KVR-CIBER/sc02-solar-hypercar/f1/docs/boodschappenlijst.md

# SC-02 · Boodschappenlijst

Afvinkbaar op je gsm: http://192.168.68.88:5880/lijst/

Prijzen zijn richtprijzen (oktober 2026). Bewaar alle kassabonnen: de organisatie vergoedt max. €50.

## Aandrijving (≈ €28)

| ✓ | Onderdeel | Aantal | Prijs | Waarvoor | Waar / zoekterm |
|---|---|---|---|---|---|
| ☐ | Tamiya Hyper-Dash 3 motor | 2 | €17.00 | Mini 4WD 130-motor, art. 15477 | Hobbywinkel / bol.com / Amazon.de · zoek “Tamiya 15477” |
| ☐ | Messing pinion 8T, module 0,5, boring 2 mm | 2 | €2.50 | past op de 2 mm-as van de motor (pak van 10) | AliExpress · “0.5M 8T brass pinion 2mm” |
| ☐ | Kogellager 683ZZ (3×7×3 mm) | 6 | €3.60 | 2 achteras + 4 in de voorwielen (pak van 10) | AliExpress / bol.com · “683ZZ bearing” |
| ☐ | Carbonstaaf Ø3 mm × 500 mm | 1 | €2.50 | achteras 186 mm | AliExpress / modelbouw · “carbon rod 3mm” |
| ☐ | Zilverstaal Ø3 mm × 100 mm | 1 | €2.00 | 2 steekasjes voor 16 mm | Conrad / modelbouw · “zilverstaal 3 mm” |

## Sturen & elektronica (≈ €60)

| ✓ | Onderdeel | Aantal | Prijs | Waarvoor | Waar / zoekterm |
|---|---|---|---|---|---|
| ☐ | Servo MG90S (metalen tandwielen) | 1 | €4.00 | stuurservo, omgekeerd in de neus | AliExpress / bol.com · “MG90S” |
| ☐ | Pololu DRV8874 motordriver | 2 | €18.00 | 1 per motor, vooruit/achteruit/remmen | Kiwi Electronics / Antratek / Pololu · “Pololu DRV8874 carrier” |
| ☐ | Pololu S13V30F5 (5 V 3 A buck-boost) | 1 | €17.00 | 5 V voor Pi 4 + servo, werkt op 4,8 V én 12 V | Kiwi Electronics / Antratek · “S13V30F5” |
| ☐ | INA226-module 20 A (2 mΩ shunt) | 1 | €3.00 | meet batterijspanning en stroom → verbruik op je gsm | AliExpress · “INA226 20A” |
| ☐ | Hallsensor DRV5023 (TO-92) | 1 | €1.50 | snelheid via het tandwiel | Mouser / Farnell · “DRV5023 TO-92” |
| ☐ | Neodymium magneetjes 2×1 mm + 6×3 mm | 1 | €4.00 | 2 in het tandwiel, 8 voor de body | AliExpress · “magnet 2x1mm / 6x3mm” |
| ☐ | Schottky 1N5819 + zekeringhouder mini-blade + 10 A zekering + mini-schakelaar | 1 | €4.00 | paneel-diode (verplicht), zekering, aan/uit onder de vloer | Conrad / AliExpress |
| ☐ | Siliconendraad 20 AWG + 26 AWG, XT30-stekkers | 1 | €6.00 | voeding + signaal | AliExpress / bol.com · “silicone wire 20awg”, “XT30” |
| ☐ | Dupont-kabeltjes F-F | 1 | €2.00 | ESP ↔ Pi UART, sensoren | AliExpress / bol.com |

## Batterij (≈ €48)

| ✓ | Onderdeel | Aantal | Prijs | Waarvoor | Waar / zoekterm |
|---|---|---|---|---|---|
| ☐ | 3S LiPo 1300 mAh (XT30, max. 75×35×25 mm) | 1 | €18.00 | om te rijden met Pi + controller (niet voor de wedstrijd) | Hobbywinkel / AliExpress · “3S 1300mAh XT30” |
| ☐ | LiPo-balanslader | 1 | €25.00 | alleen als je er nog geen hebt | bv. ToolkitRC / ISDT · “LiPo balance charger” |
| ☐ | LiPo-veiligheidszak | 1 | €5.00 | laden en bewaren | “LiPo safe bag” |

## Carrosserie, vloer & banden (≈ €44)

| ✓ | Onderdeel | Aantal | Prijs | Waarvoor | Waar / zoekterm |
|---|---|---|---|---|---|
| ☐ | Zwart plexi/acrylaat 2 mm, lasersnijden (DXF) | 1 | €15.00 | bestand: floor_2mm_acrylic.dxf | FabLab / laserservice · “acrylaat lasersnijden” |
| ☐ | Filament ASA (rood + zwart), ± 300 g | 1 | €8.00 | body, vleugels, chassisdelen | Bambu Lab store · “Bambu ASA” |
| ☐ | Filament PETG smoke/zwart, ± 40 g | 1 | €2.00 | koepel | Bambu Lab store · “PETG translucent gray” |
| ☐ | Filament PLA grafiet, ± 160 g | 1 | €3.00 | velgen + bandenmal |  |
| ☐ | Gietrubber: PU Shore 50A of siliconen Shore 40A (± 50 ml) | 1 | €15.00 | 4 banden + reserve | bol.com / Formx · “PU gietrubber shore 50” |
| ☐ | Spuitjes 10 ml Luer (zonder naald) | 3 | €1.50 | rubber inspuiten | apotheek / bol.com |

## Schroeven & klein materiaal (≈ €14)

| ✓ | Onderdeel | Aantal | Prijs | Waarvoor | Waar / zoekterm |
|---|---|---|---|---|---|
| ☐ | Assortiment M2×8 zelftappend + M3×6 verzonken + M3×12 (kingpins) | 1 | €8.00 | alles van onderen door de plexivloer | bol.com / AliExpress · “M2 M3 screw assortment” |
| ☐ | Klittenband + kabelbinders 2,5 mm | 1 | €3.00 | batterij en kabels |  |
| ☐ | Krimpkous assortiment | 1 | €3.00 |  |  |

**Totaal ≈ €194.** Zonder LiPo-lader en veiligheidszak (als je die al hebt) ≈ €164.

**Al in huis:** Raspberry Pi 4, ESP32-S3 DevKitC-1, Recon Cloud-controller, Bambu P1S, en de kit van de organisatie (paneel, 4× AA, houders, Loctite 3090).
