KVR-CIBER/sc02-solar-hypercar/cad/out/render_inside.png

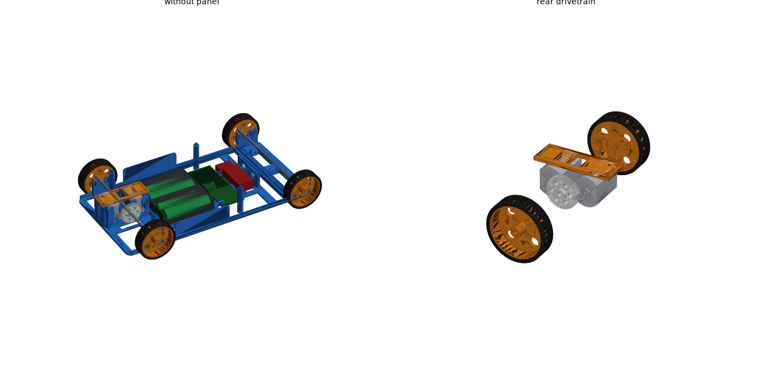
cad/out/render_inside.png
