KVR-CIBER/sc02-solar-hypercar/cad/out/render_mold.png

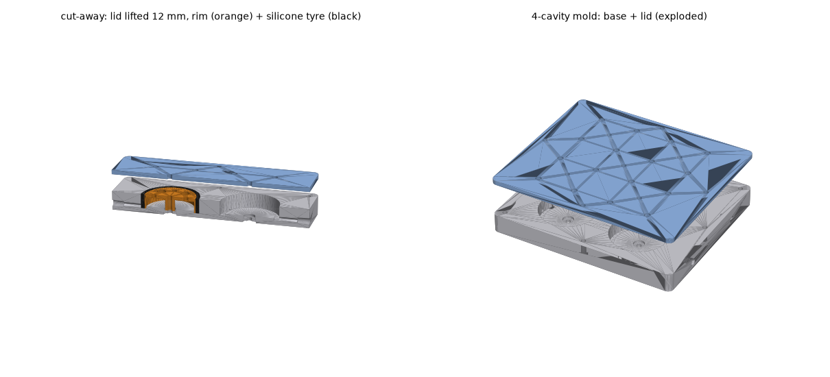
cad/out/render_mold.png
