KVR-CIBER/sc02-solar-hypercar/f1/pcb/fab/render_3d.png

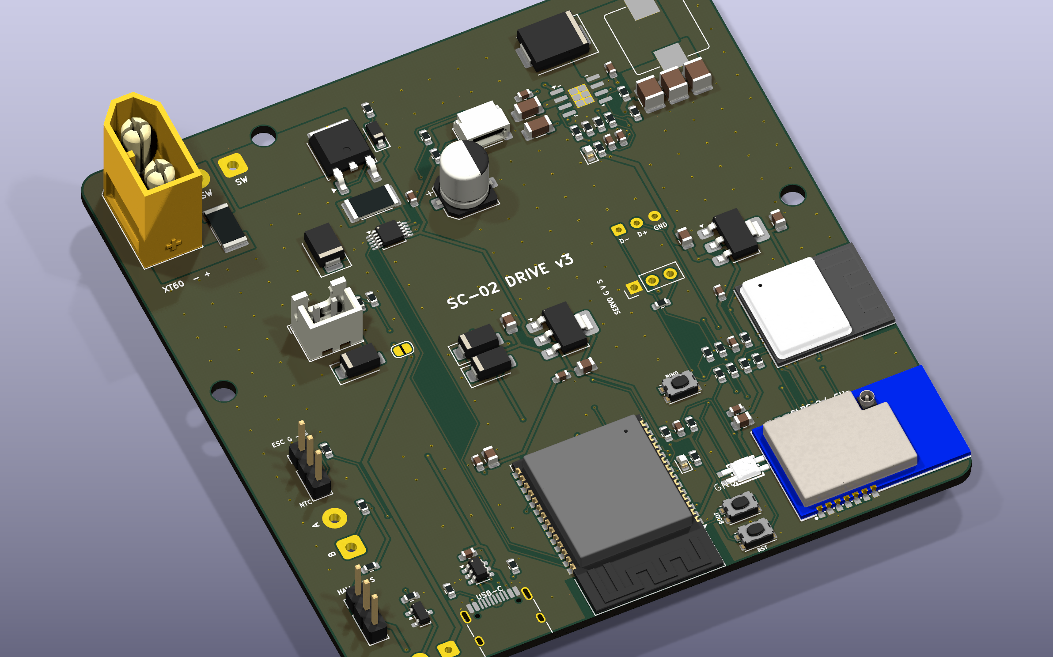
f1/pcb/fab/render_3d.png
