KVR-CIBER/sc02-solar-hypercar/f1/pcb/fab/render_bottom.png

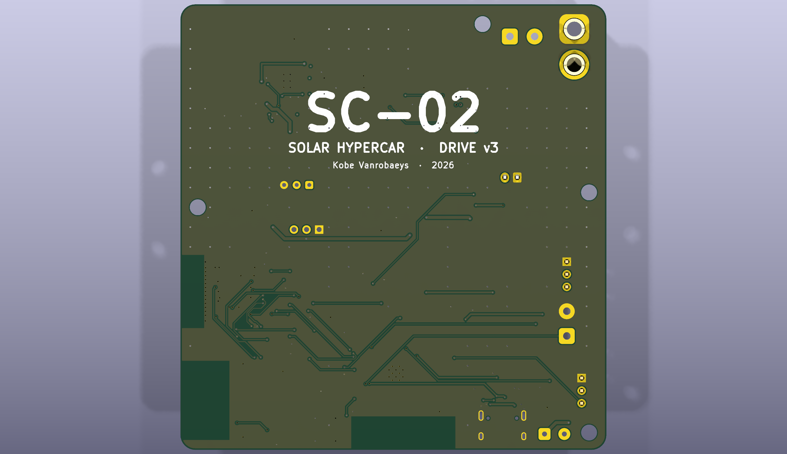
f1/pcb/fab/render_bottom.png
