KVR-CIBER/sc02-solar-hypercar/f1/pcb/fab/render_top.png

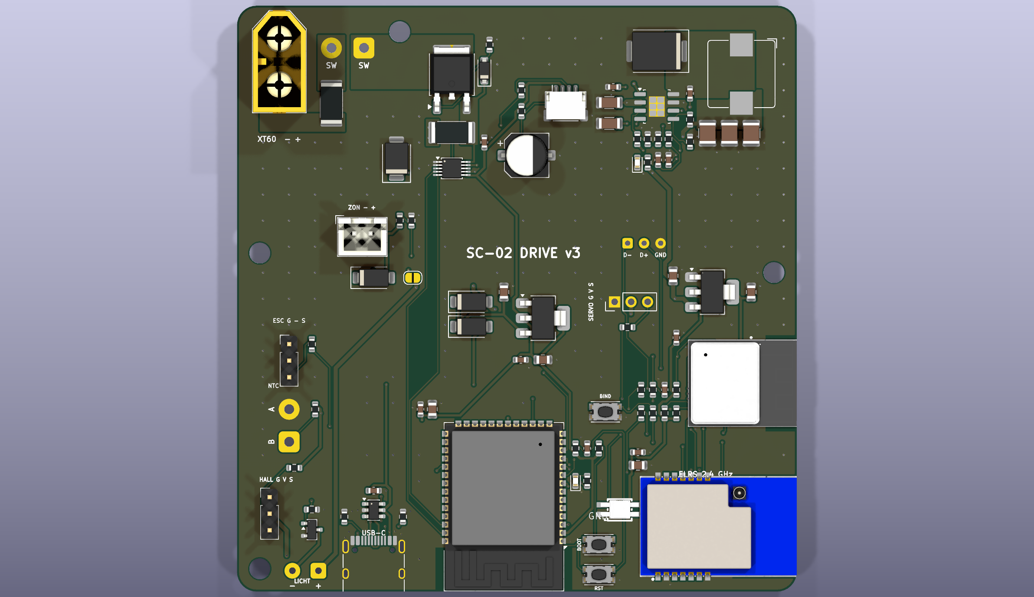
f1/pcb/fab/render_top.png
