KVR-CIBER/sc02-solar-hypercar/sim/out/launch_map.png

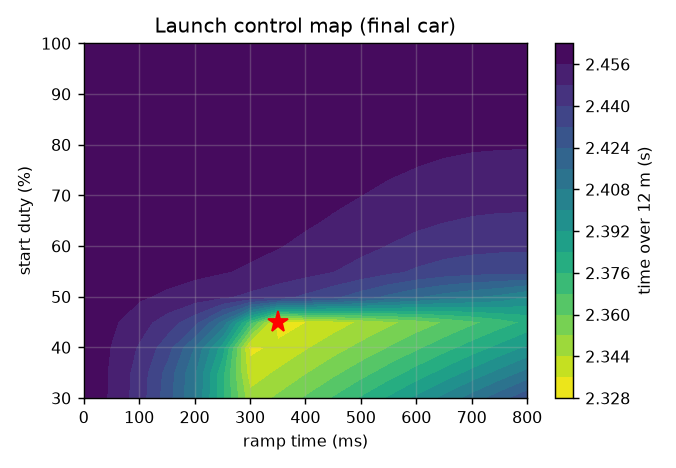
sim/out/launch_map.png
