KVR-CIBER/sc02-solar-hypercar/site/media/poster_hero.jpg

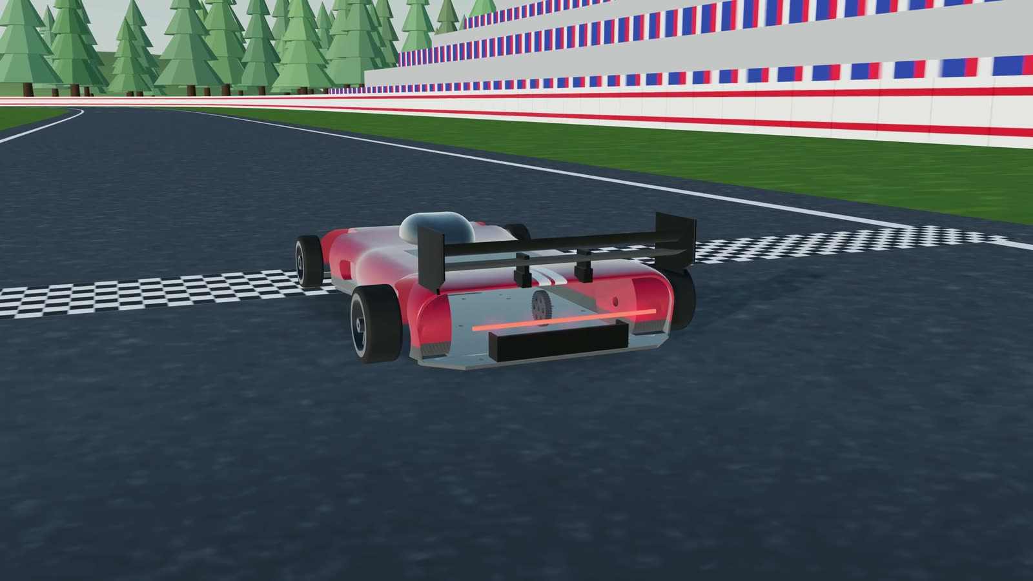
site/media/poster_hero.jpg
