KVR-CIBER/sc02-solar-hypercar/video/beauty/01_voor_driekwart.jpg

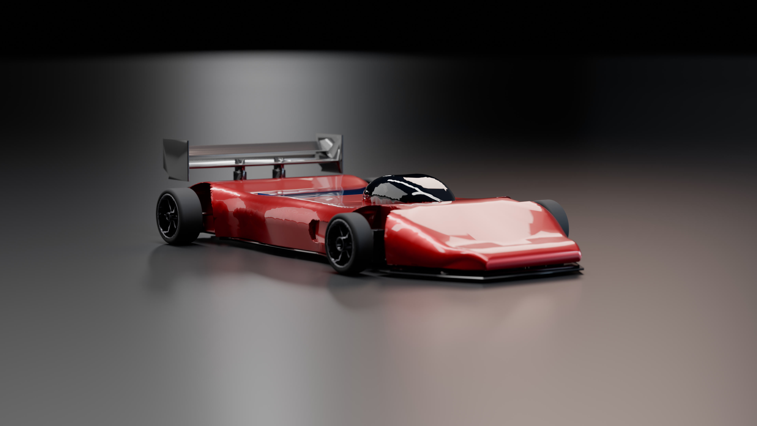
video/beauty/01_voor_driekwart.jpg
