KVR-CIBER/sc02-solar-hypercar/video/beauty/02_achter_driekwart.jpg

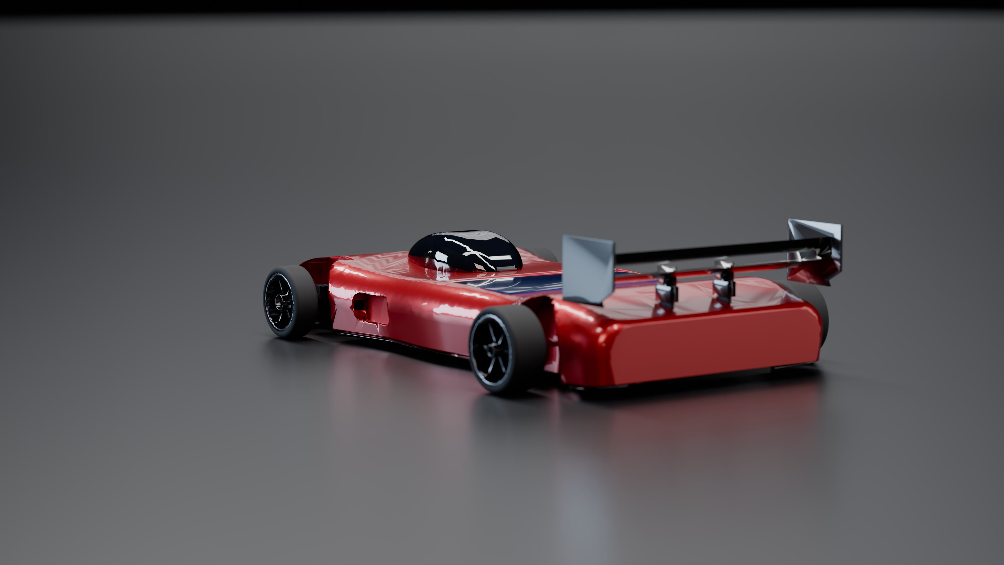
video/beauty/02_achter_driekwart.jpg
