KVR-CIBER/sc02-solar-hypercar/video/beauty/03_zijkant.jpg

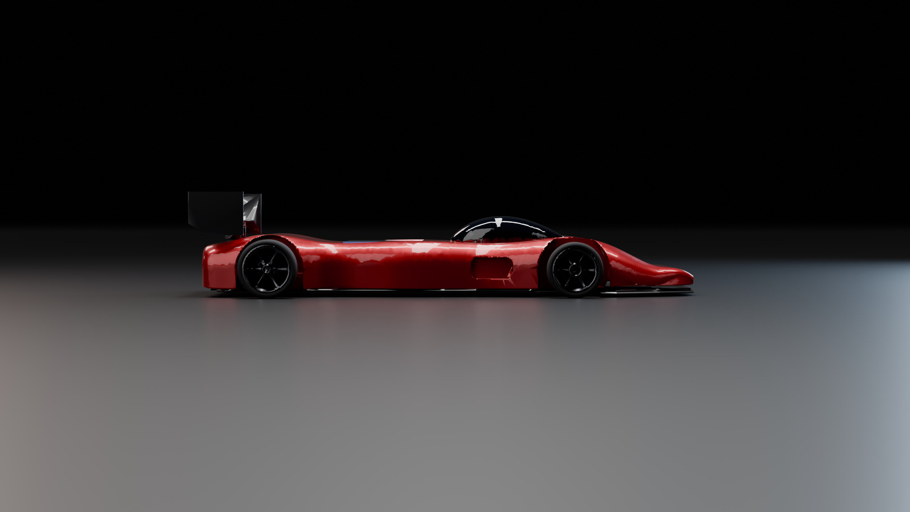
video/beauty/03_zijkant.jpg
