KVR-CIBER/sc02-solar-hypercar/video/beauty/04_laag_neus.jpg

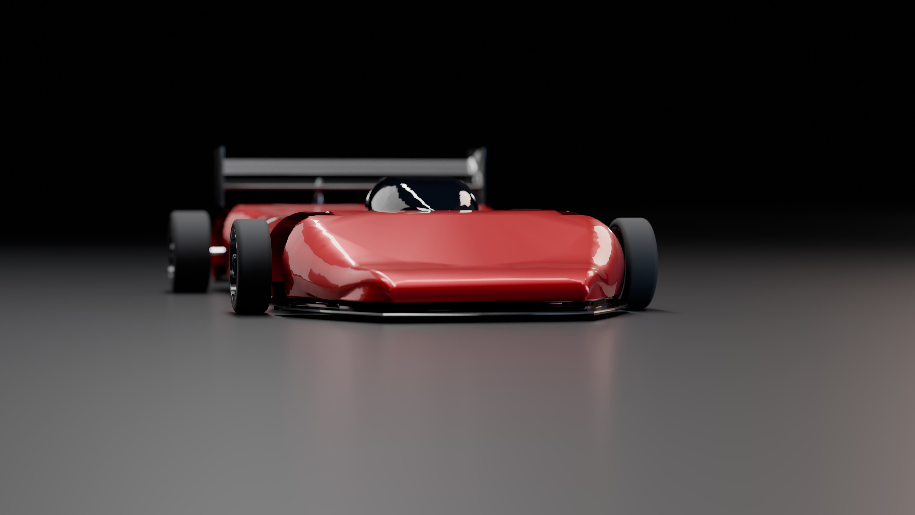
video/beauty/04_laag_neus.jpg
