KVR-CIBER/sc02-solar-hypercar/video/beauty/05_boven.jpg

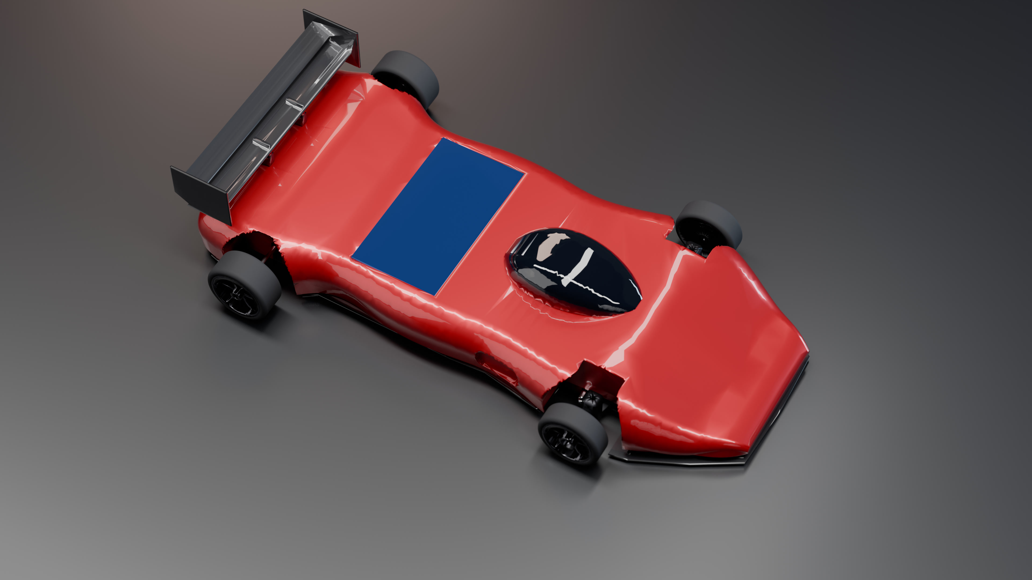
video/beauty/05_boven.jpg
