KVR-CIBER/sc02-solar-hypercar/video/beauty/06_achtervleugel.jpg

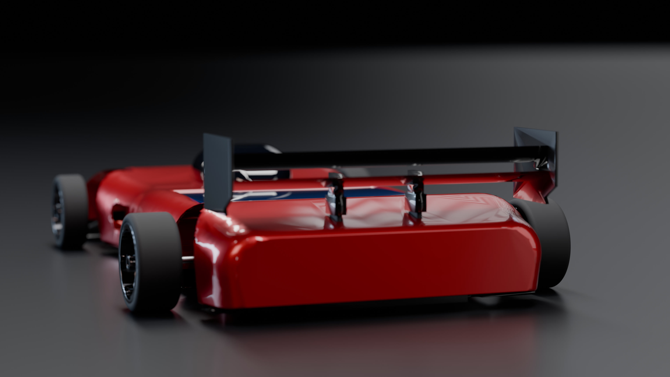
video/beauty/06_achtervleugel.jpg
