KVR-CIBER/sc02-solar-hypercar/video/beauty/07_wiel_voor.jpg

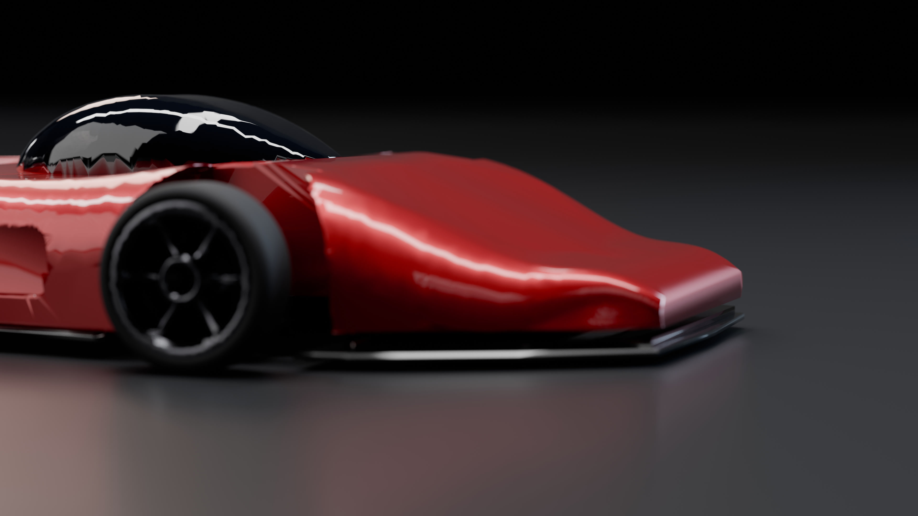
video/beauty/07_wiel_voor.jpg
