KVR-CIBER/sc02-solar-hypercar/video/beauty/08_zonnepaneel.jpg

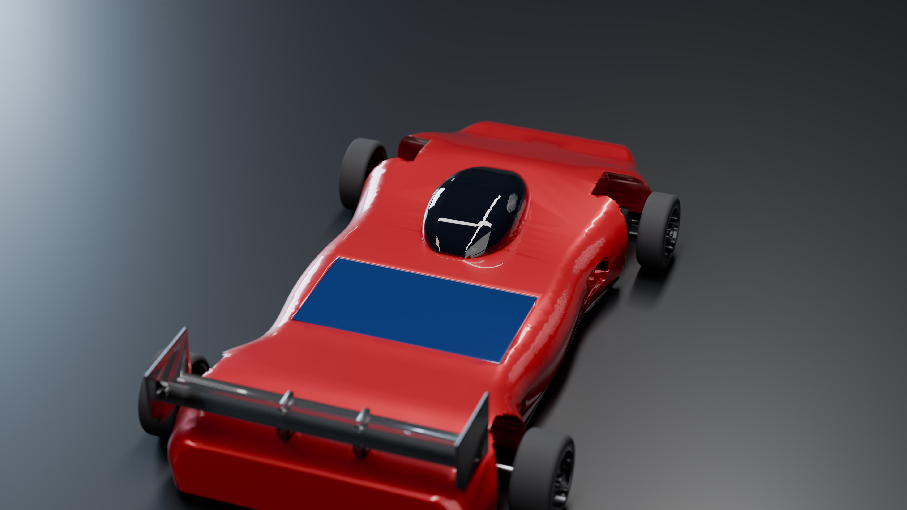
video/beauty/08_zonnepaneel.jpg
