KVR-CIBER/sc02-solar-hypercar/video/beauty/09_rontgen.jpg

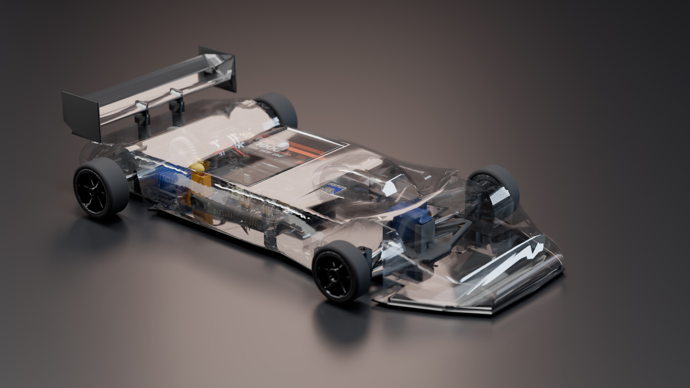
video/beauty/09_rontgen.jpg
