KVR-CIBER/sc02-solar-hypercar/video/beauty/10_explosie.jpg

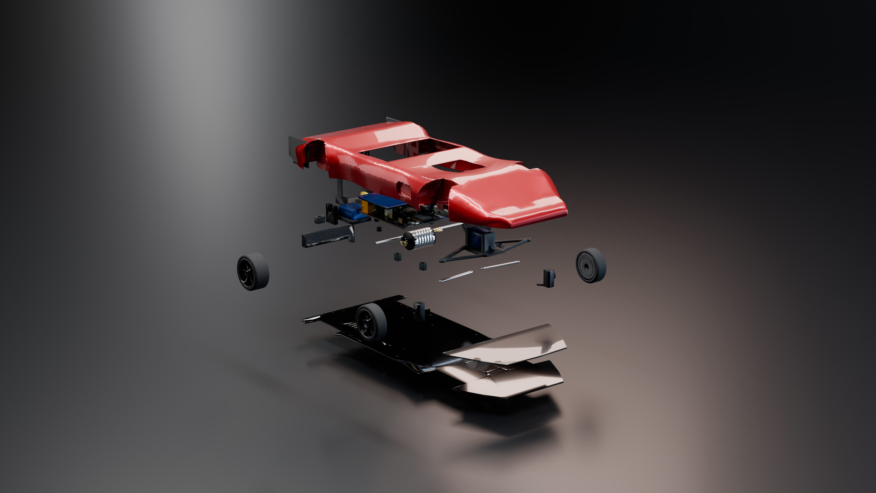
video/beauty/10_explosie.jpg
