KVR-CIBER/sc02-solar-hypercar/f1/docs/BOM_SC02.md

# SC-02 · Onderdelenlijst

De prijzen zijn richtprijzen (EU-webshops, oktober 2026). Al in huis: Raspberry Pi 4, ESP32-S3 DevKitC-1, Recon Cloud-controller, P1S.
Geleverd door de organisatie: kit-zonnepaneel, 4× AA NiMH en houders.

| # | Onderdeel | Aantal | Pro | Budget-alternatief |
|---|---|---|---|---|
| 1 | Zwart acrylaat 2 mm, lasersnijden (≈ 380 × 180) | 1 | €15 (laserservice/FabLab) | €8 (FabLab, zelf snijden) |
| 2 | Tamiya Hyper-Dash 3 (130-motor) | 2 | €17 | 2× generieke 130 high-speed €3 |
| 3 | Messing pinion 8T m0,5, 2 mm boring | 2 | €2,50 | idem |
| 4 | Servo MG90S (metalen tandwielen) | 1 | €4 | SG90 €2 |
| 5 | Motordriver Pololu DRV8874 (4,5–37 V, 6 A) | 2 | €18 | 1× TB6612FNG-module €2 (krapper: 1,2 A continu per kanaal) |
| 6 | Pololu S13V30F5 buck-boost 5 V 3 A | 1 | €17 | XL6009/SEPIC-module €3 |
| 7 | INA226-module met 2 mΩ-shunt (20 A-versie) | 1 | €3 | idem |
| 8 | 3S LiPo 1300 mAh (XT30) | 1 | €18 | idem (of alleen de kit-AA's: dan geen Pi aan boord) |
| 9 | XT30-stekkers, siliconendraad 20/24 AWG | – | €4 | idem |
| 10 | 683ZZ-lagers (3 × 7 × 3) | 6 | €3,50 (10 stuks) | idem |
| 11 | Carbonstaaf Ø3 + staalstaaf Ø3 (steekasjes) | – | €4 | idem |
| 12 | Schroeven M2 × 8 / M3 × 6 verzonken / M3-kingpins | – | €6 (assortiment) | idem |
| 13 | Magneten 6 × 3 (8) en 2 × 1 (2) | – | €4 | idem |
| 14 | DRV5023-hallsensor, 1N5819, zekeringhouder + 10 A, mini-schakelaar | – | €4,50 | idem |
| 15 | Bandenrubber: siliconen Shore 40A of PU Shore 50A (± 20 ml) | – | €15 | TPU 95A printen €1 |
| 16 | Filament: ASA ± 260 g, PETG smoke 40 g, PLA ± 180 g | – | €10 | idem |
| | **Totaal** | | **± €165** | **± €95** |

Zonder Pi aan boord (wedstrijdconfiguratie: kit-AA's, ESP alleen) vallen 6 en 8 weg.
De organisatie vergoedt max. €50 (regel 1.5): bewaar alle kassabonnen.
