KVR-CIBER/sc02-solar-hypercar/cad/out/render_parts.png

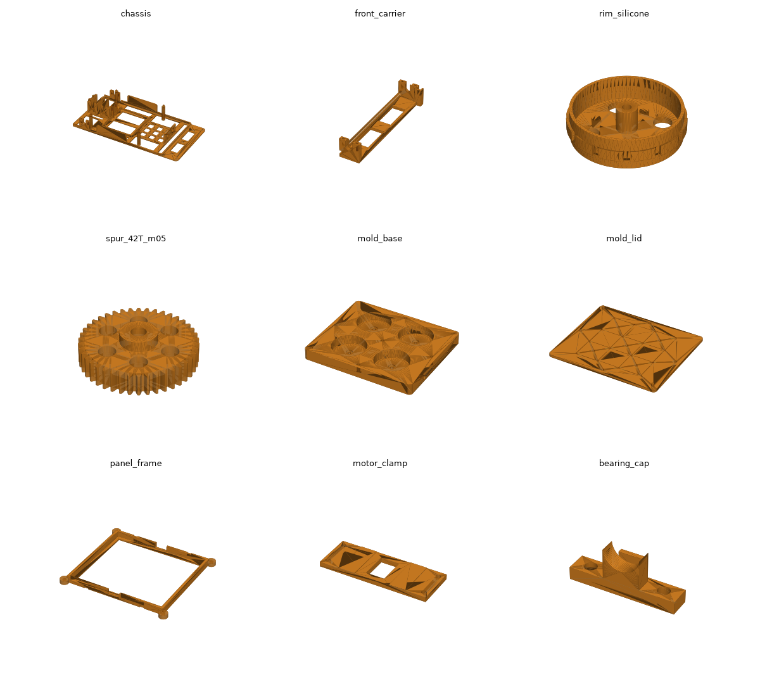
cad/out/render_parts.png
