KVR-CIBER/sc02-solar-hypercar/f1/cad/out/step/1_body_main_ASA.step

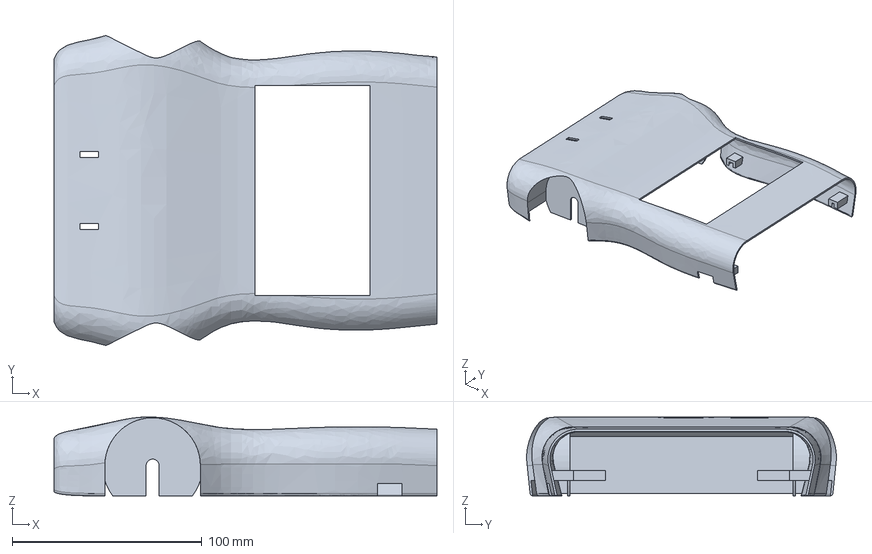
[picture p35: CAD file, 2026-10-18]
f1/cad/out/step/1_body_main_ASA.step
202.0 x 163.4 x 41.6 mm
