KVR-CIBER/sc02-solar-hypercar/f1/P1S_STEP/bambu_3mf/1_body_main_ASA.3mf

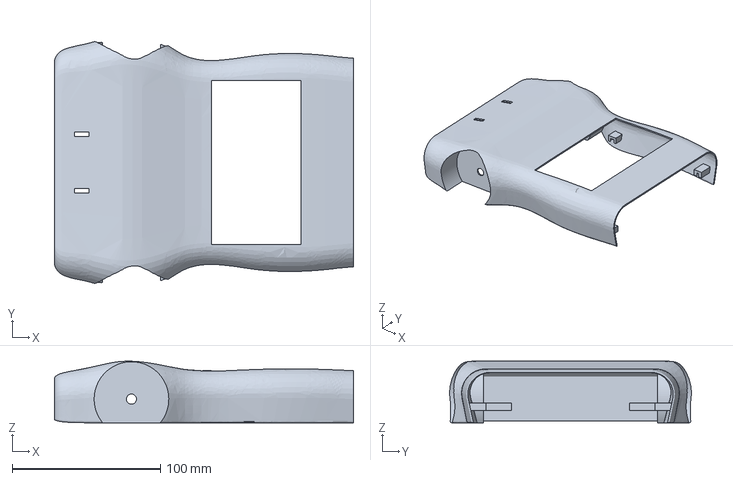
[picture p36: CAD file, 2026-10-16]
f1/P1S_STEP/bambu_3mf/1_body_main_ASA.3mf
202.0 x 163.4 x 41.7 mm
