KVR-CIBER/sc02-solar-hypercar/cad/out/step/assembly.step

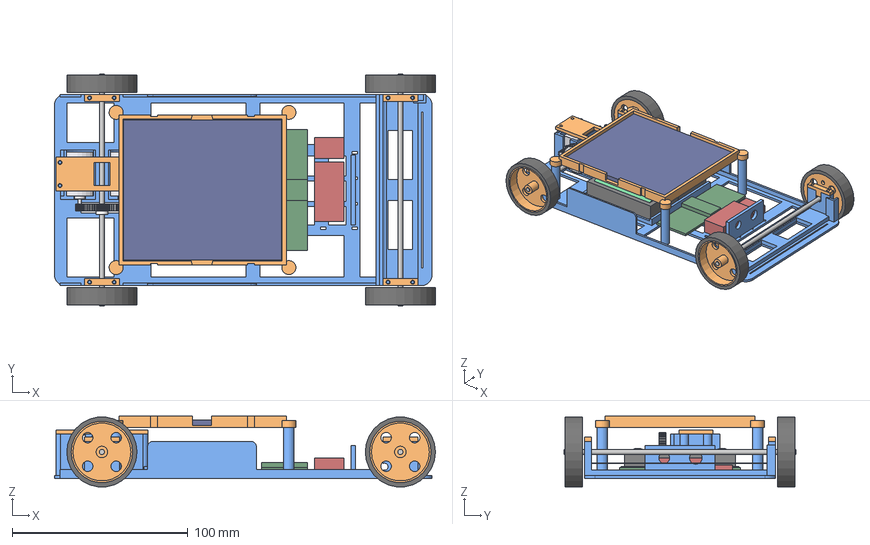
[picture p37: CAD file, 2026-10-16]
cad/out/step/assembly.step
217.0 x 132.0 x 40.3 mm
chassis
front_carrier
motor_clamp
cap_0_1
cap_0_-1
cap_170.0_1
cap_170.0_-1
panel_frame
spur
rim_0_1
tyre_0_1
rim_0_-1
tyre_0_-1
rim_170.0_1
tyre_170.0_1
rim_170.0_-1
tyre_170.0_-1
battery_holders
cells
panel
motors
axles
esp32s3
power
