KVR-CIBER/sc02-solar-hypercar/cad/out/print/4_option_TPU_tyres.3mf

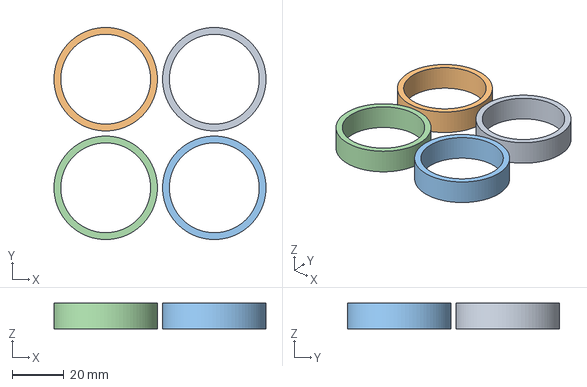
[picture p38: CAD file, 2026-10-16]
cad/out/print/4_option_TPU_tyres.3mf
81.9 x 81.9 x 10.0 mm
tyre_tpu.stl x 4
