KVR-CIBER/sc02-solar-hypercar/cad/out/render_parts/motor_clamp.stl

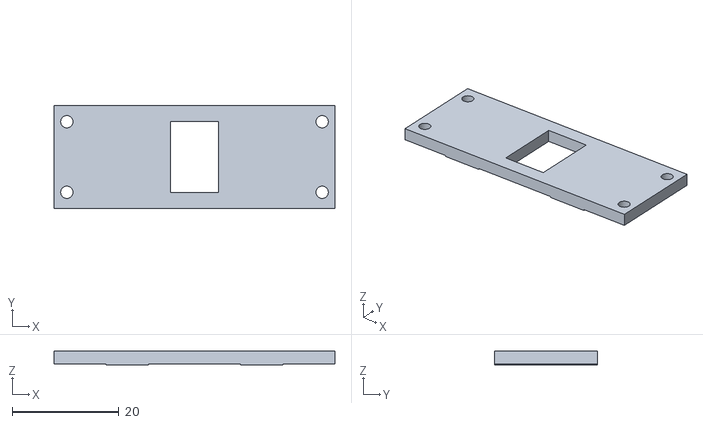
[picture p39: CAD file, 2026-10-16]
cad/out/render_parts/motor_clamp.stl
52.6 x 19.2 x 2.60
