KVR-CIBER/sc02-solar-hypercar/cad/out/step/front_carrier.step

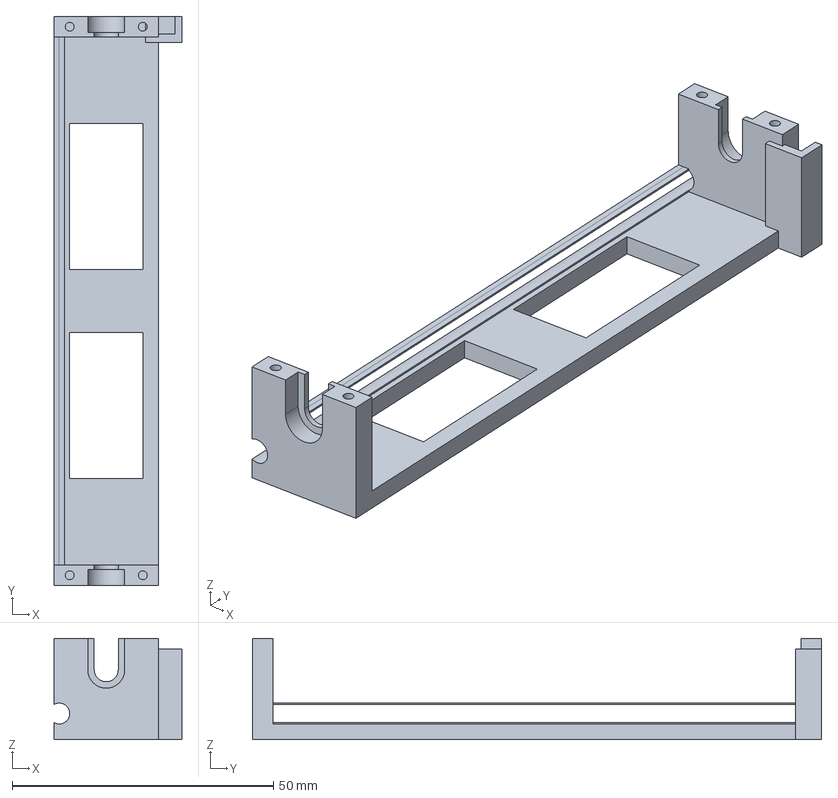
[picture p40: CAD file, 2026-10-16]
cad/out/step/front_carrier.step
24.5 x 109.0 x 19.4 mm
