KVR-CIBER/sc02-solar-hypercar/f1/cad/out/floor_2mm_acrylic_snijlijnen.dxf

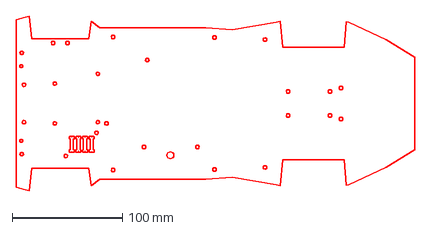
[picture p41: CAD file, 2026-10-21]
f1/cad/out/floor_2mm_acrylic_snijlijnen.dxf
362.0 x 158.6 mm
