KVR-CIBER/sc02-solar-hypercar/f1/cad/out/stl/clip_2L.stl

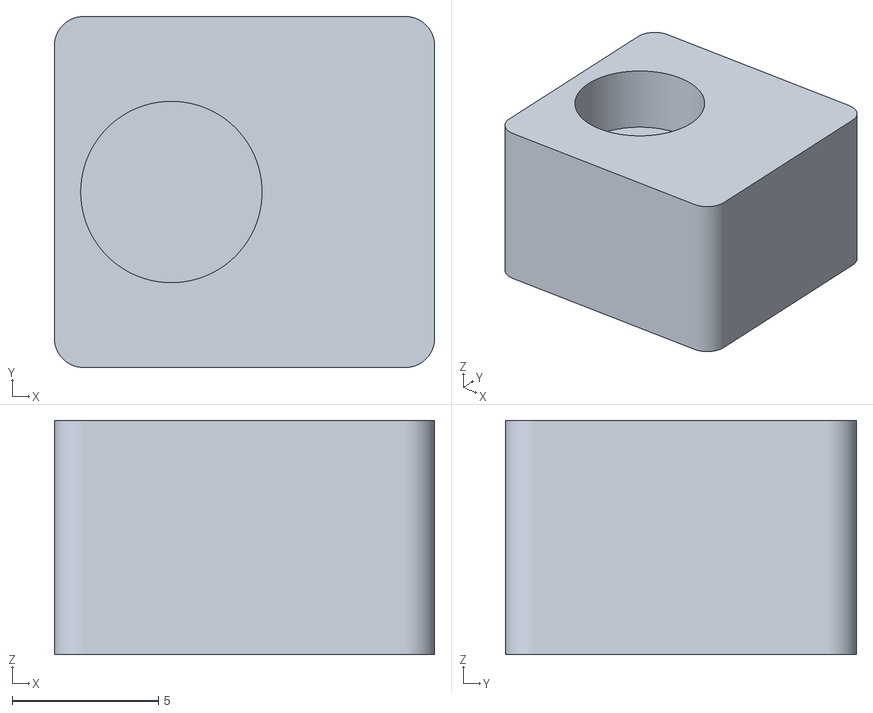
[picture p42: CAD file, 2026-10-21]
f1/cad/out/stl/clip_2L.stl
13.0 x 12.0 x 8.00
