KVR-CIBER/sc02-solar-hypercar/f1/P1S_STEP/bambu_3mf/6_wheels_PLA.3mf

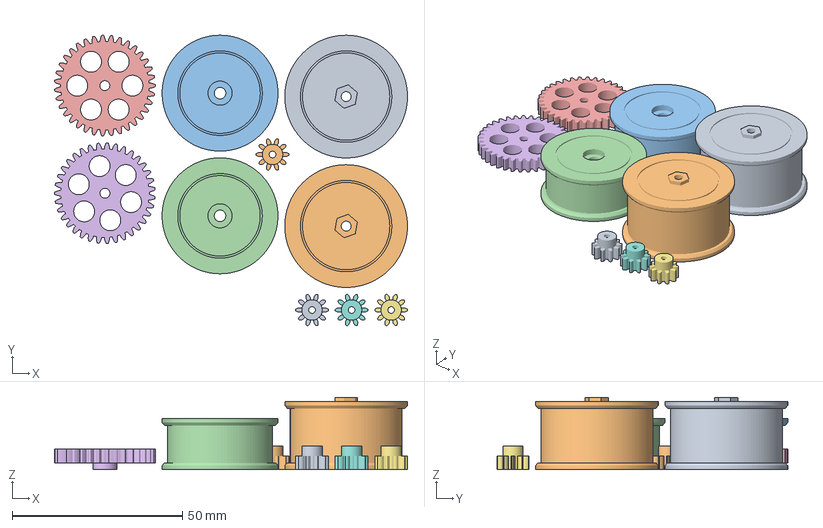
[picture p43: CAD file, 2026-10-16]
f1/P1S_STEP/bambu_3mf/6_wheels_PLA.3mf
103.6 x 85.2 x 21.2 mm
rim_rear_180_0.stl x 2
rim_front_180_0.stl x 2
spur_90_0.stl x 2
pinion_0_0.stl x 4
