KVR-CIBER/sc02-solar-hypercar/f1/P1S_STEP/onderdelen/tie_rod_R.step

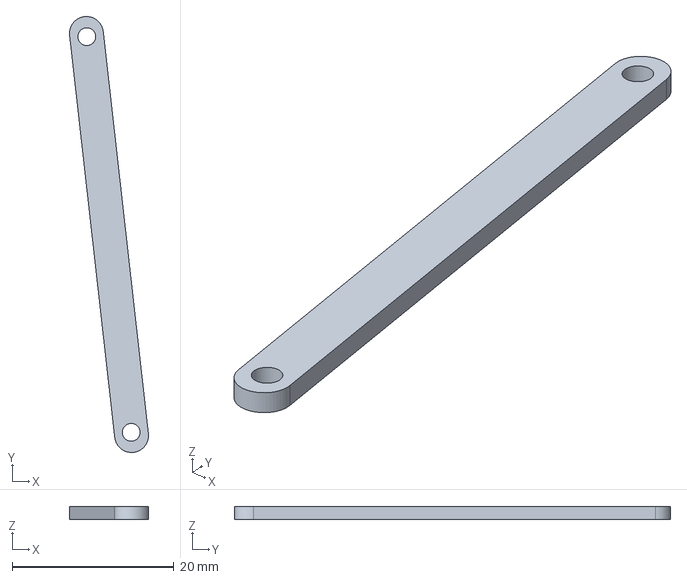
[picture p44: CAD file, 2026-10-16]
f1/P1S_STEP/onderdelen/tie_rod_R.step
9.79 x 54.0 x 1.60 mm
