KVR-CIBER/sc02-solar-hypercar/f1/P1S_STEP/platen/8_option_TPU_tyres.step

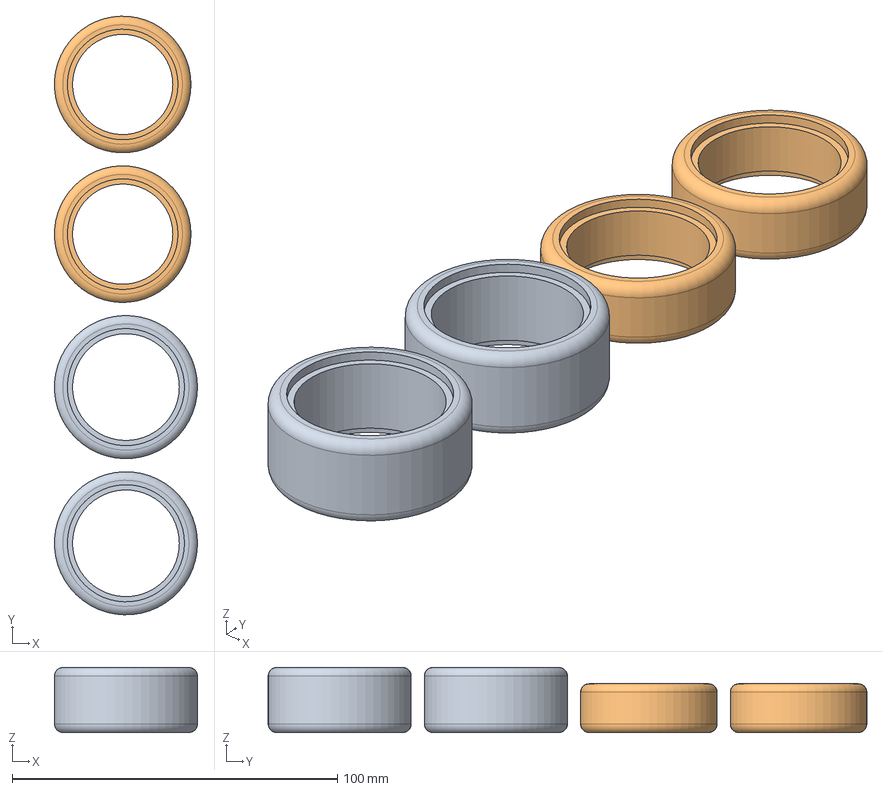
[picture p45: CAD file, 2026-10-16]
f1/P1S_STEP/platen/8_option_TPU_tyres.step
44.0 x 184.0 x 20.0 mm
tyre_rear_0
tyre_rear_1
tyre_front_2
tyre_front_3
