KVR-CIBER/sc02-solar-hypercar/PRINTEN_PLA_TPU/PLA/1x_esp_bridge.stl

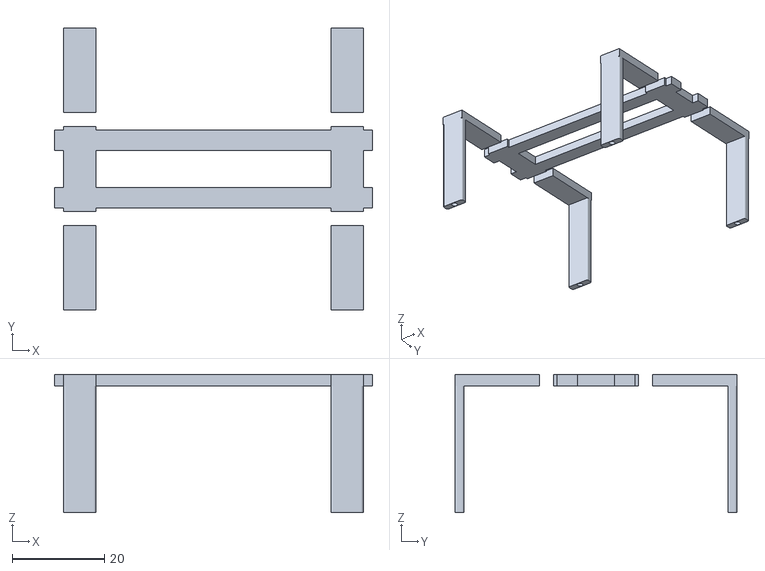
[picture p46: CAD file, 2026-10-16]
PRINTEN_PLA_TPU/PLA/1x_esp_bridge.stl
69.0 x 61.2 x 30.0
