KVR-CIBER/sc02-solar-hypercar/PRINTEN_PLA_TPU/TPU/2x_tyre_rear.stl

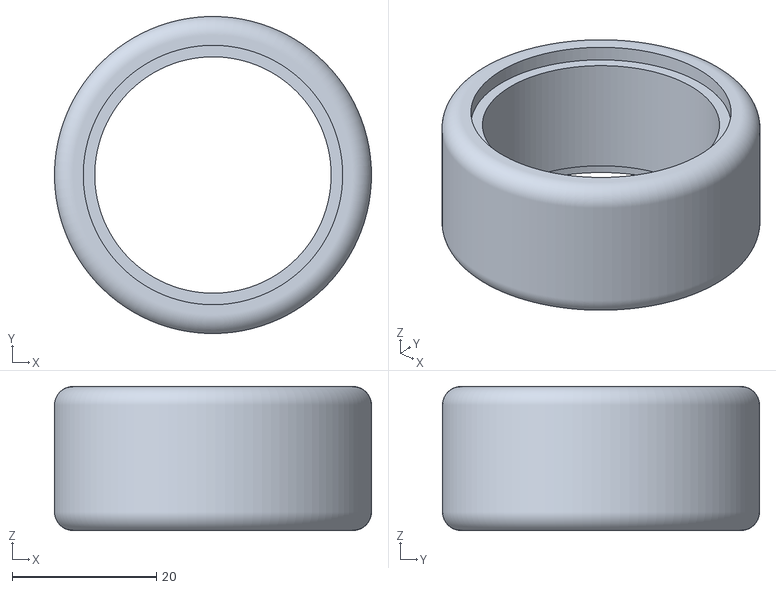
[picture p47: CAD file, 2026-10-16]
PRINTEN_PLA_TPU/TPU/2x_tyre_rear.stl
44.0 x 44.0 x 20.0
