KVR-CIBER/sc02-solar-hypercar/cad/out/print/5_option_rims_for_TPU_PLA.3mf

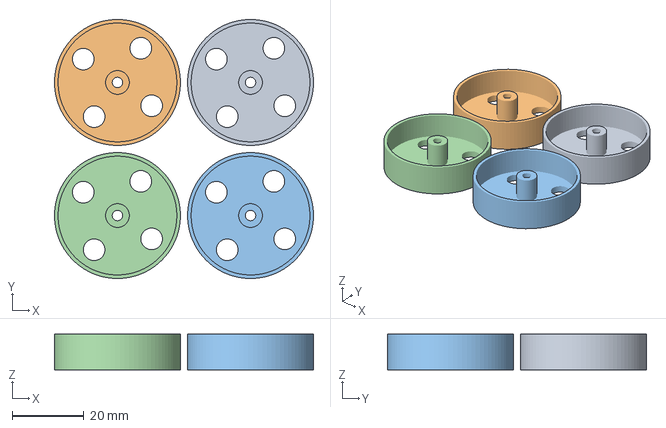
[picture p48: CAD file, 2026-10-16]
cad/out/print/5_option_rims_for_TPU_PLA.3mf
72.0 x 72.0 x 10.0 mm
rim_tpu.stl x 4
