KVR-CIBER/sc02-solar-hypercar/cad/out/render_parts/spur.stl

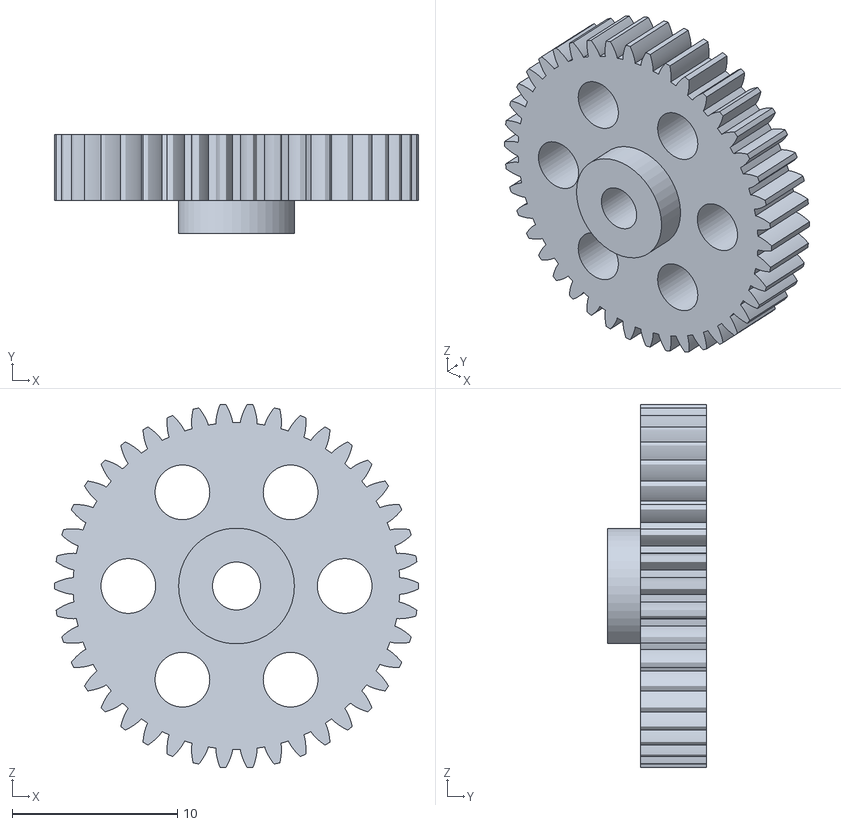
[picture p49: CAD file, 2026-10-16]
cad/out/render_parts/spur.stl
22.0 x 6.00 x 22.0
