KVR-CIBER/sc02-solar-hypercar/f1/cad/out/floor_2mm_acrylic.dxf

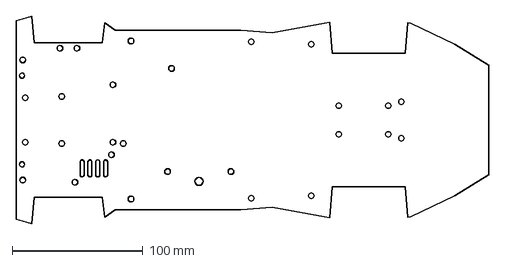
[picture p50: CAD file, 2026-10-21]
f1/cad/out/floor_2mm_acrylic.dxf
362.0 x 158.6 mm
