KVR-CIBER/sc02-solar-hypercar/f1/cad/out/step/7a_tyre_mold_bottom_cores_PLA.step

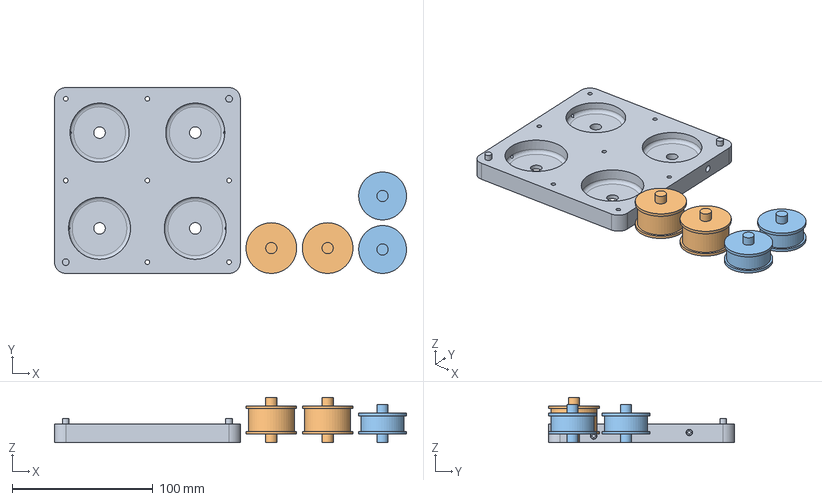
[picture p51: CAD file, 2026-10-18]
f1/cad/out/step/7a_tyre_mold_bottom_cores_PLA.step
250.0 x 132.0 x 32.0 mm
mold_bottom_0
mold_core_rear_1
mold_core_rear_2
mold_core_front_3
mold_core_front_4
