KVR-CIBER/sc02-solar-hypercar/f1/cad/out/step/onderdelen/splitter.step

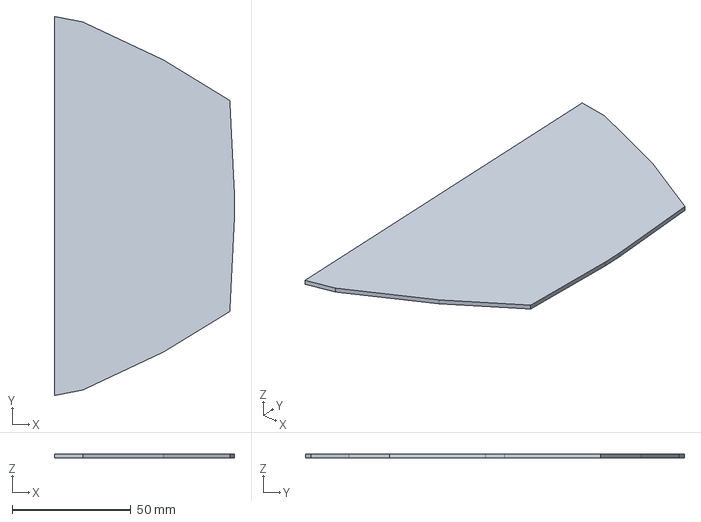
[picture p52: CAD file, 2026-10-18]
f1/cad/out/step/onderdelen/splitter.step
76.0 x 159.8 x 1.60 mm
