KVR-CIBER/sc02-solar-hypercar/f1/cad/out/stl/rear_bearing_R.stl

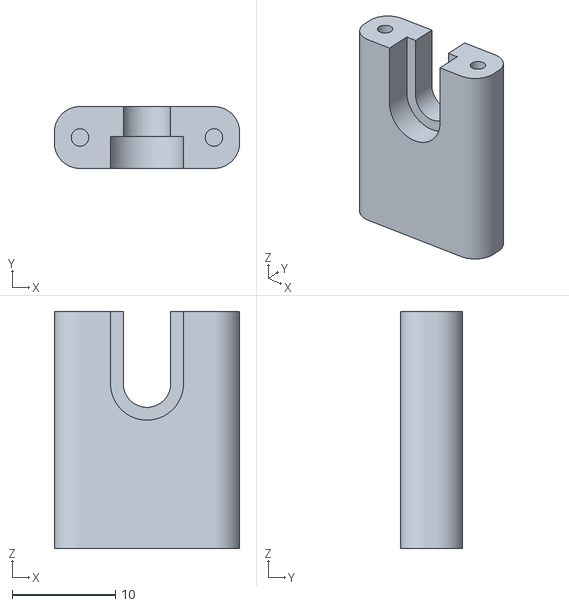
[picture p53: CAD file, 2026-10-21]
f1/cad/out/stl/rear_bearing_R.stl
18.0 x 6.00 x 23.0
