KVR-CIBER/sc02-solar-hypercar/PRINTEN_PLA_TPU/PLA/1x_clip_1L.stl

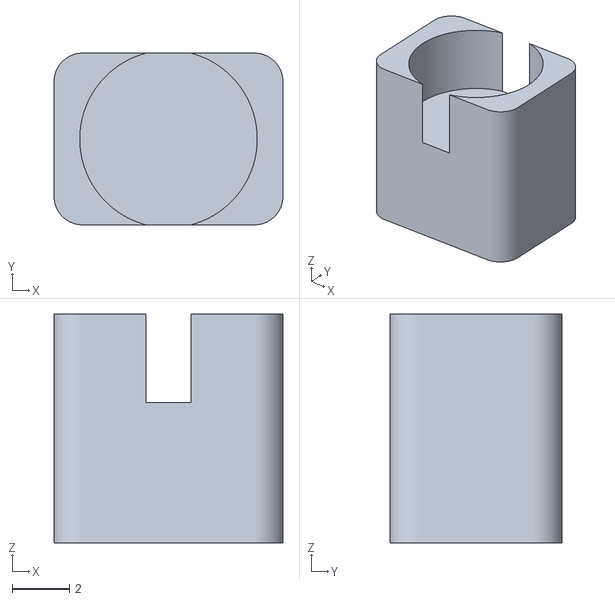
[picture p54: CAD file, 2026-10-16]
PRINTEN_PLA_TPU/PLA/1x_clip_1L.stl
8.00 x 6.00 x 8.00
