KVR-CIBER/sc02-solar-hypercar/PRINTEN_PLA_TPU/TPU/2x_tyre_front.stl

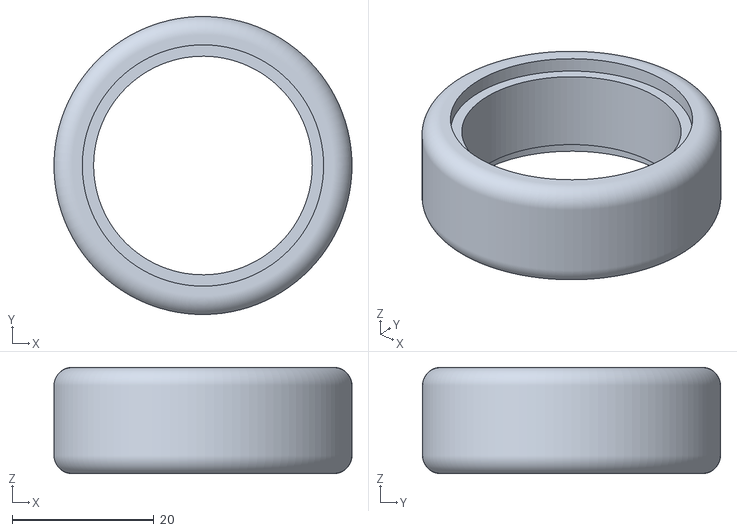
[picture p55: CAD file, 2026-10-16]
PRINTEN_PLA_TPU/TPU/2x_tyre_front.stl
42.0 x 42.0 x 15.0
