KVR-CIBER/sc02-solar-hypercar/cad/out/print/3_tyre_mold_PLA.3mf

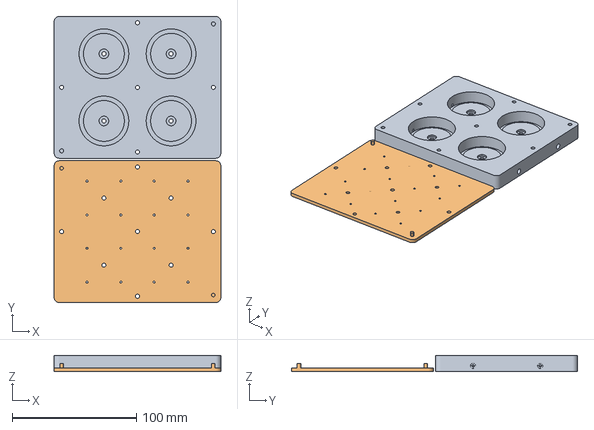
[picture p56: CAD file, 2026-10-16]
cad/out/print/3_tyre_mold_PLA.3mf
134.0 x 230.0 x 13.0 mm
mold_base.stl
mold_lid.stl
