KVR-CIBER/sc02-solar-hypercar/cad/out/render_parts/power.stl

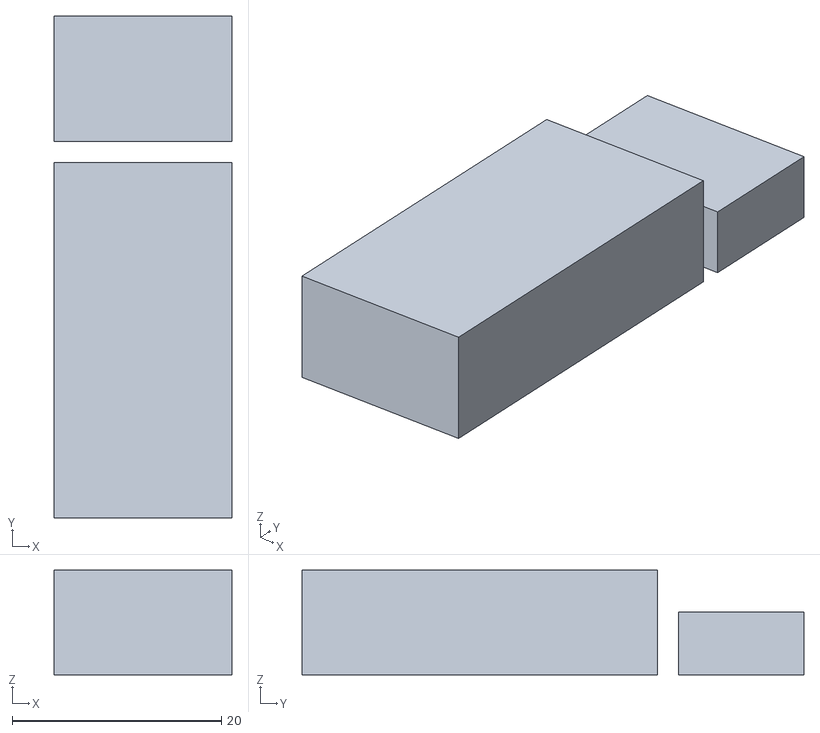
[picture p57: CAD file, 2026-10-16]
cad/out/render_parts/power.stl
17.0 x 48.0 x 10.0
