KVR-CIBER/sc02-solar-hypercar/cad/out/step/mold_base.step

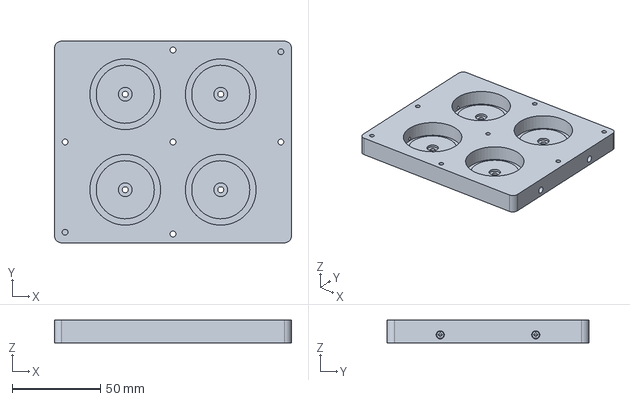
[picture p58: CAD file, 2026-10-16]
cad/out/step/mold_base.step
134.0 x 114.0 x 13.0 mm
