KVR-CIBER/sc02-solar-hypercar/f1/cad/out/cnc_spur_m0.8_35T.dxf

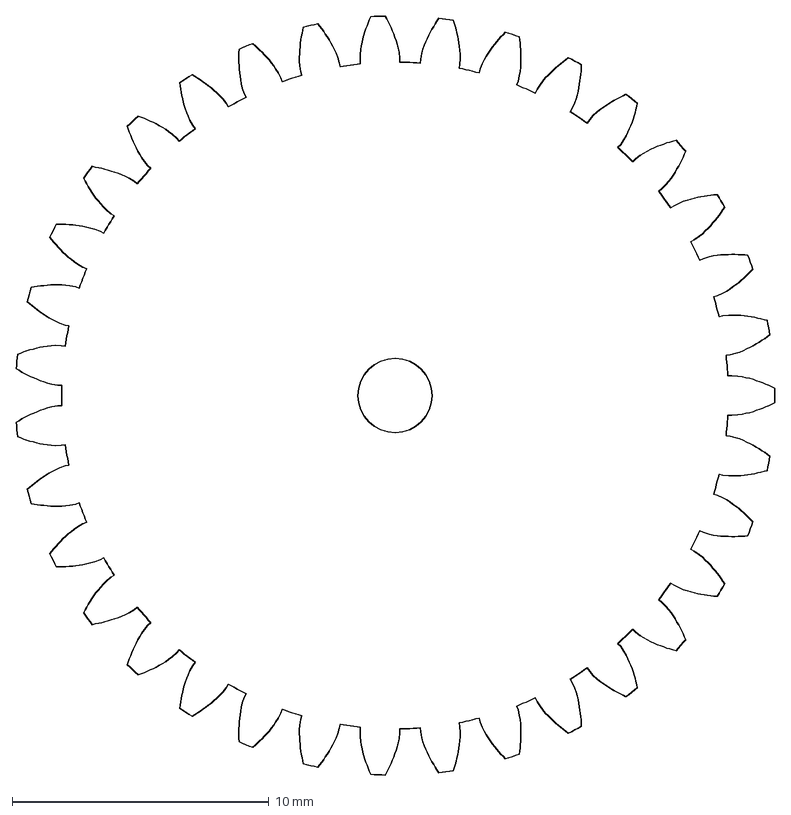
[picture p59: CAD file, 2026-10-20]
f1/cad/out/cnc_spur_m0.8_35T.dxf
29.6 x 29.6 mm
