KVR-CIBER/sc02-solar-hypercar/f1/cad/out/step/4_chassis_parts_ASA.step

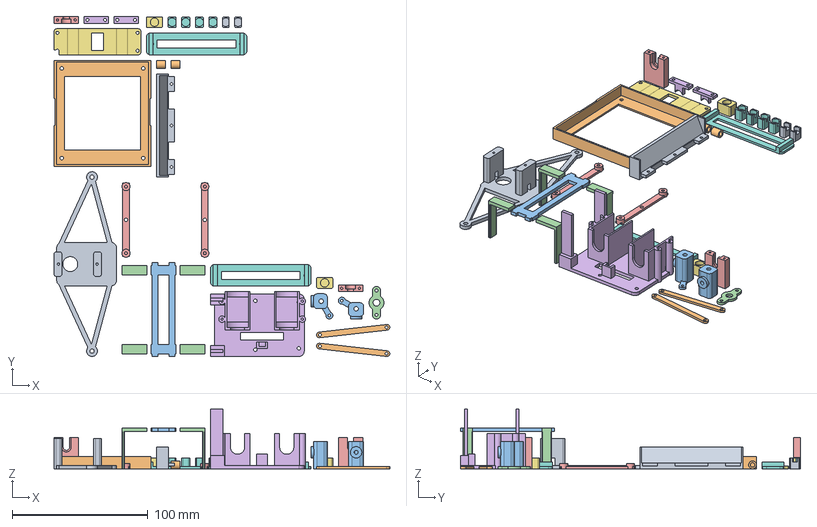
[picture p60: CAD file, 2026-10-18]
f1/cad/out/step/4_chassis_parts_ASA.step
247.1 x 250.2 x 44.0 mm
front_module_2
battery_tray_14
esp_bridge_16
pi_tray_15
rear_module_0
motor_clamp_1
power_tray_L_17
power_tray_R_18
diffuser_27
tie_rod_L_5
tie_rod_R_6
front_upright_L_3
front_upright_R_4
steering_horn_7
rear_bearing_L_8
rear_bearing_R_9
bearing_cap_R_11
bearing_cap_L_10
clip_2L_23
clip_2R_24
clip_1L_21
clip_1R_22
clip_3L_25
clip_3R_26
clip_0L_19
clip_0R_20
wheel_spacer_12
wheel_spacer_13
