KVR-CIBER/sc02-solar-hypercar/f1/cad/out/step/onderdelen/pinion.step

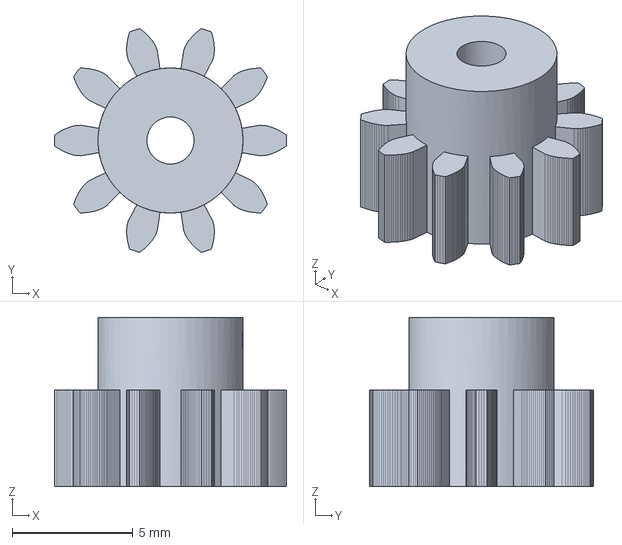
[picture p61: CAD file, 2026-10-18]
f1/cad/out/step/onderdelen/pinion.step
9.60 x 9.26 x 7.00 mm
