KVR-CIBER/sc02-solar-hypercar/f1/P1S_STEP/bambu_3mf/4_chassis_parts_ASA.3mf

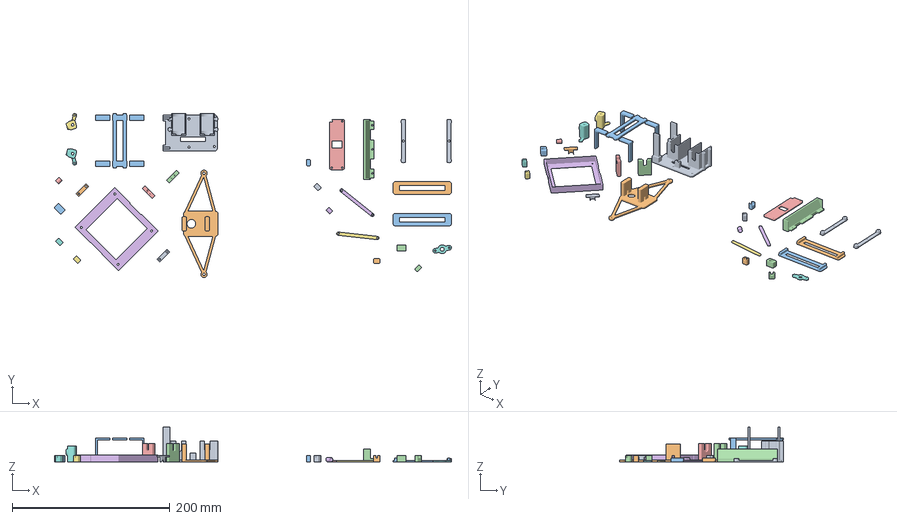
[picture p62: CAD file, 2026-10-16]
f1/P1S_STEP/bambu_3mf/4_chassis_parts_ASA.3mf
502.6 x 207.7 x 44.0 mm
rear_module_0_0.stl
front_module_0_0.stl
esp_bridge_0_0.stl
rear_bearing_L_0_0.stl
rear_bearing_R_0_0.stl
battery_tray_0_0.stl
front_upright_R_0_0.stl
front_upright_L_0_0.stl
pi_tray_0_0.stl
power_tray_L_0_0.stl
power_tray_R_0_0.stl
diffuser_0_0.stl
motor_clamp_0_0.stl
tie_rod_L_0_0.stl
tie_rod_R_0_0.stl
steering_horn_0_0.stl
bearing_cap_L_0_0.stl
bearing_cap_R_0_0.stl
clip_2L_0_0.stl
clip_2R_0_0.stl
wheel_spacer_0_0.stl x 2
clip_1L_0_0.stl
clip_1R_0_0.stl
clip_3L_0_0.stl
clip_3R_0_0.stl
clip_0L_0_0.stl
clip_0R_0_0.stl
