KVR-CIBER/sc02-solar-hypercar/f1/P1S_STEP/onderdelen/power_tray_R.step

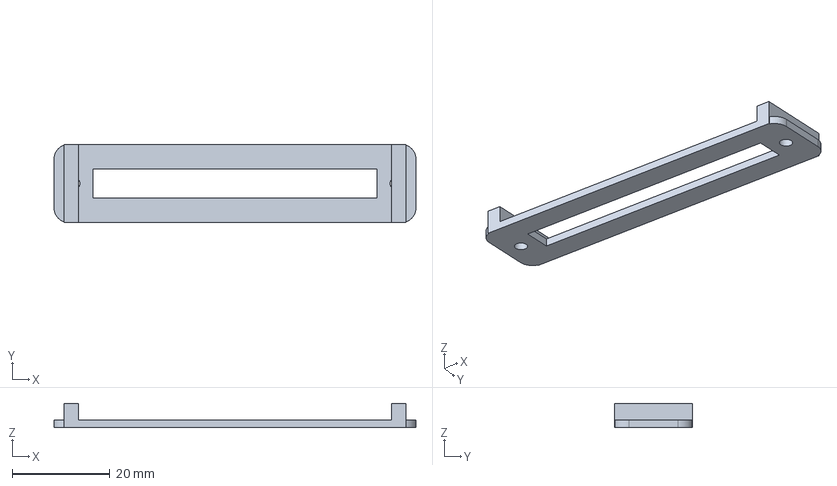
[picture p63: CAD file, 2026-10-16]
f1/P1S_STEP/onderdelen/power_tray_R.step
74.0 x 16.0 x 5.00 mm
