KVR-CIBER/sc02-solar-hypercar/f1/P1S_STEP/platen/2_body_nose_ASA.step

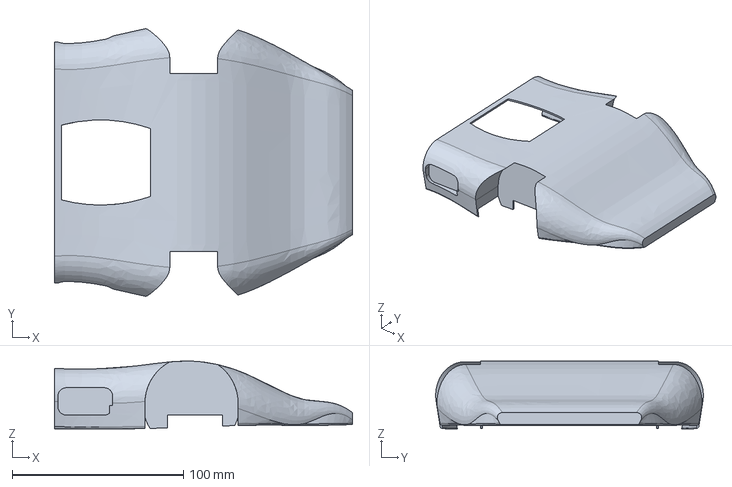
[picture p64: CAD file, 2026-10-16]
f1/P1S_STEP/platen/2_body_nose_ASA.step
174.0 x 156.3 x 39.6 mm
