KVR-CIBER/sc02-solar-hypercar/cad/out/print/2_wheels_PLA.3mf

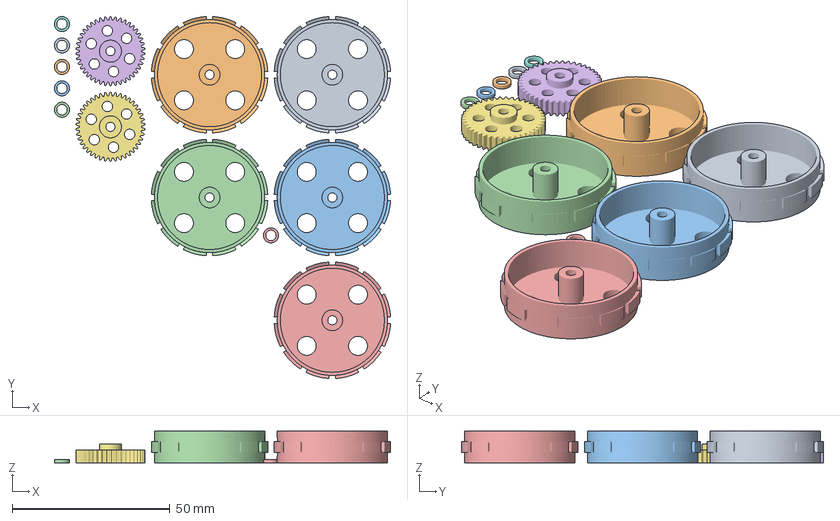
[picture p65: CAD file, 2026-10-16]
cad/out/print/2_wheels_PLA.3mf
106.7 x 114.8 x 10.0 mm
rim_silicone.stl x 5
spur_42T_m05.stl x 2
spacer.stl x 6
