KVR-CIBER/sc02-solar-hypercar/cad/out/render_parts/battery_holders.stl

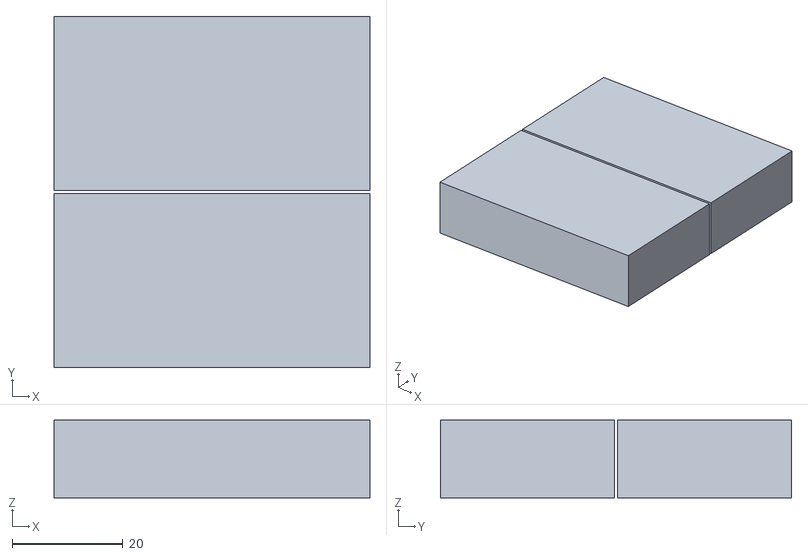
[picture p66: CAD file, 2026-10-16]
cad/out/render_parts/battery_holders.stl
57.0 x 63.4 x 14.0
