KVR-CIBER/sc02-solar-hypercar/cad/out/step/spacer.step

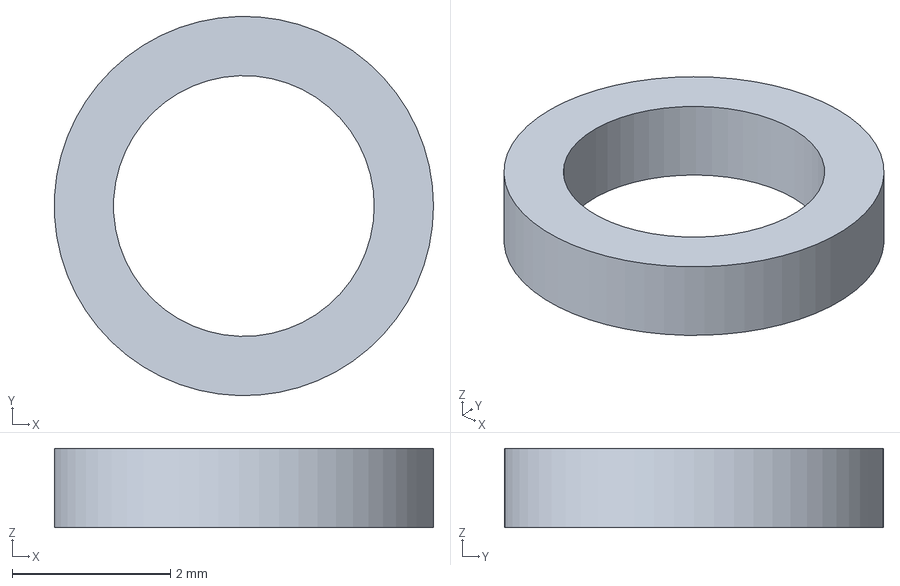
[picture p67: CAD file, 2026-10-16]
cad/out/step/spacer.step
4.80 x 4.80 x 1.00 mm
