KVR-CIBER/sc02-solar-hypercar/f1/cad/out/cnc_pinion_m0.8_11T.dxf

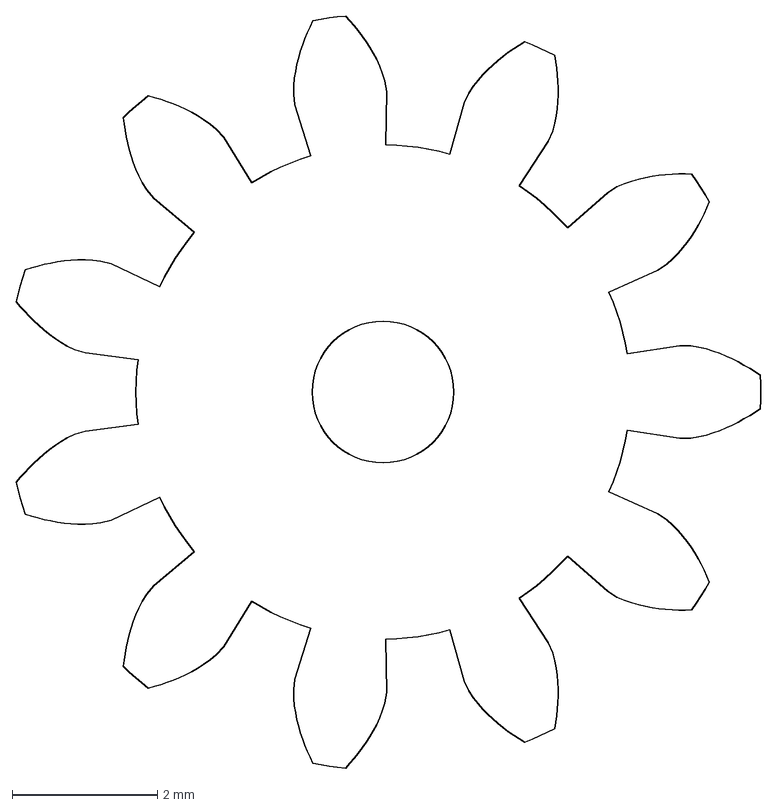
[picture p68: CAD file, 2026-10-20]
f1/cad/out/cnc_pinion_m0.8_11T.dxf
10.2 x 10.3 mm
