KVR-CIBER/sc02-solar-hypercar/f1/cad/out/step/7b_tyre_mold_top_PLA.step

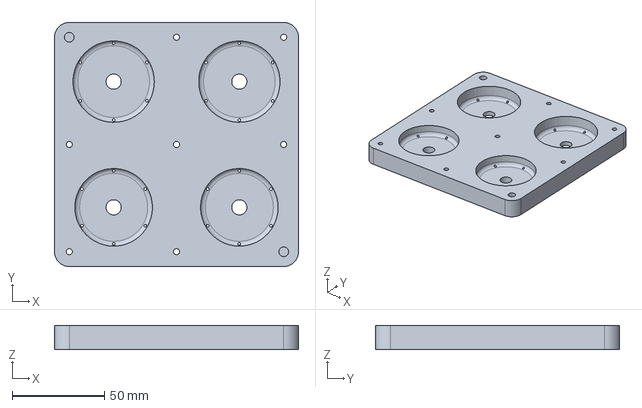
[picture p69: CAD file, 2026-10-18]
f1/cad/out/step/7b_tyre_mold_top_PLA.step
132.0 x 132.0 x 13.0 mm
