KVR-CIBER/sc02-solar-hypercar/f1/cad/out/stl/diffuser.stl

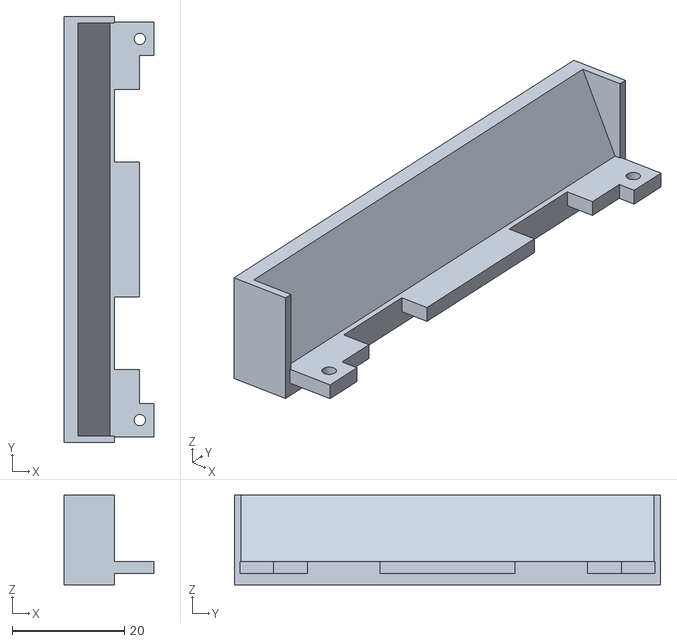
[picture p70: CAD file, 2026-10-21]
f1/cad/out/stl/diffuser.stl
16.0 x 76.0 x 16.0
