KVR-CIBER/sc02-solar-hypercar/f1/P1S_STEP/bambu_3mf/3_canopy_smoke_PETG.3mf

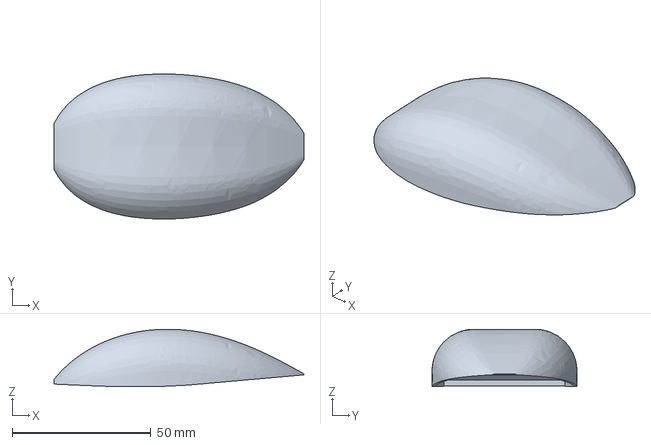
[picture p71: CAD file, 2026-10-16]
f1/P1S_STEP/bambu_3mf/3_canopy_smoke_PETG.3mf
90.0 x 52.2 x 20.7 mm
