KVR-CIBER/sc02-solar-hypercar/f1/P1S_STEP/onderdelen/steering_horn.step

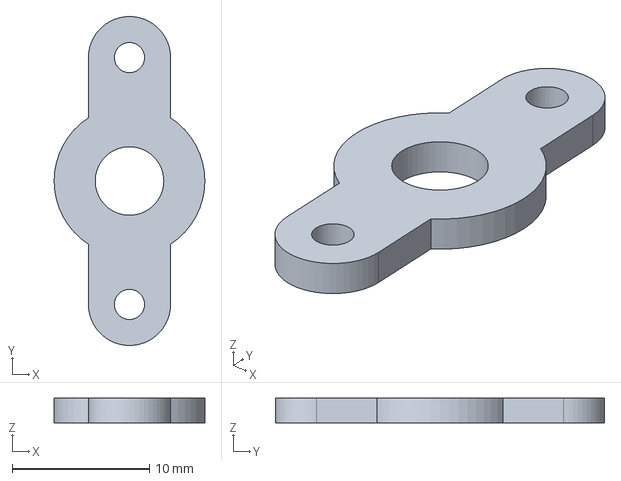
[picture p72: CAD file, 2026-10-16]
f1/P1S_STEP/onderdelen/steering_horn.step
11.0 x 24.0 x 1.80 mm
