KVR-CIBER/sc02-solar-hypercar/f1/P1S_STEP/platen/6_wheels_PLA.step

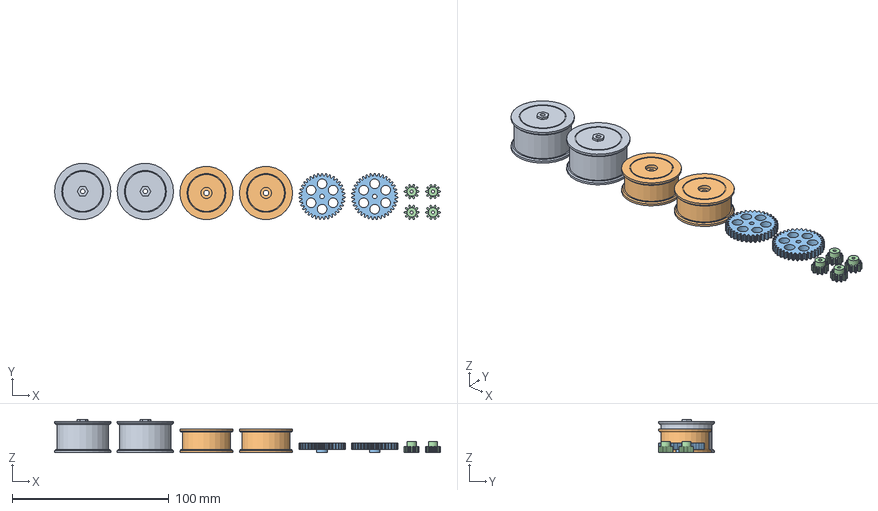
[picture p73: CAD file, 2026-10-16]
f1/P1S_STEP/platen/6_wheels_PLA.step
246.4 x 35.9 x 21.2 mm
rim_rear_0
rim_rear_1
rim_front_2
rim_front_3
spur_4
spur_5
pinion_6
pinion_7
pinion_8
pinion_9
