KVR-CIBER/sc02-solar-hypercar/PRINTEN_PLA_TPU/PLA/1x_rear_bearing_L.stl

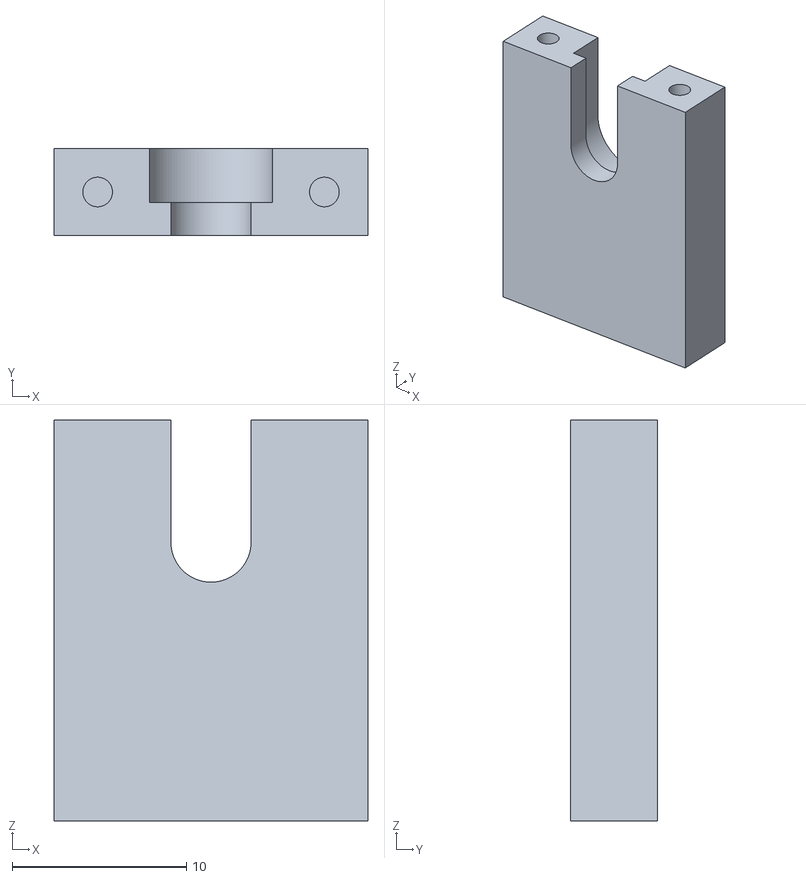
[picture p74: CAD file, 2026-10-16]
PRINTEN_PLA_TPU/PLA/1x_rear_bearing_L.stl
18.0 x 5.00 x 23.0
