KVR-CIBER/sc02-solar-hypercar/cad/out/print/1_car_ASA.3mf

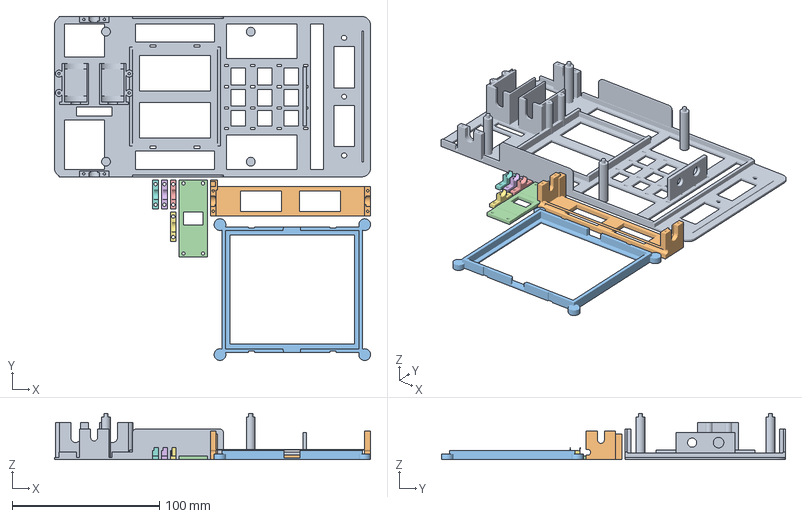
[picture p75: CAD file, 2026-10-16]
cad/out/print/1_car_ASA.3mf
215.0 x 233.9 x 31.5 mm
chassis.stl
front_carrier.stl
panel_frame.stl
motor_clamp.stl
bearing_cap.stl x 4
