KVR-CIBER/sc02-solar-hypercar/cad/out/render_parts/esp32s3.stl

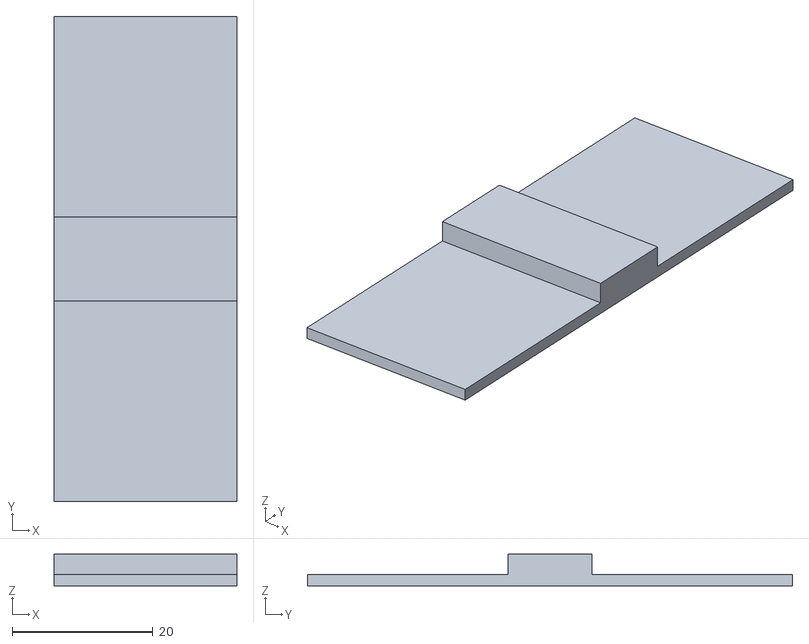
[picture p76: CAD file, 2026-10-16]
cad/out/render_parts/esp32s3.stl
26.0 x 69.0 x 4.50
