KVR-CIBER/sc02-solar-hypercar/cad/out/step/panel_frame.step

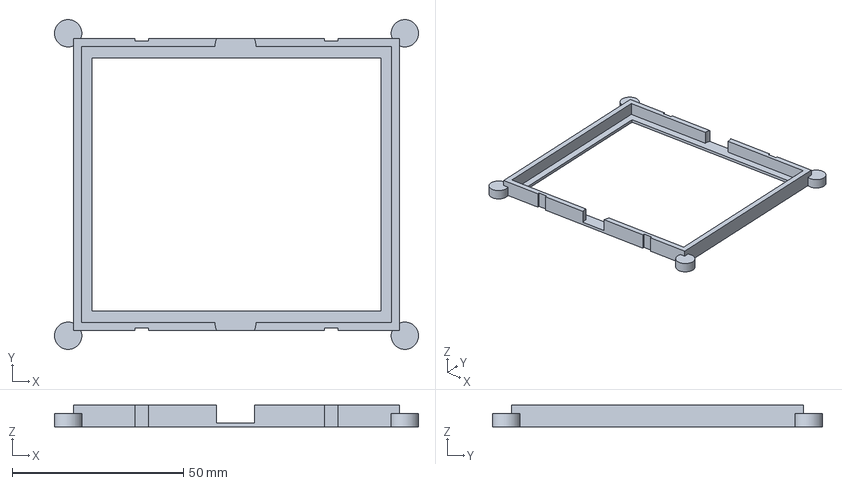
[picture p77: CAD file, 2026-10-16]
cad/out/step/panel_frame.step
106.4 x 96.4 x 6.40 mm
