KVR-CIBER/sc02-solar-hypercar/f1/cad/out/cnc_pinion_m0.8_10T.dxf

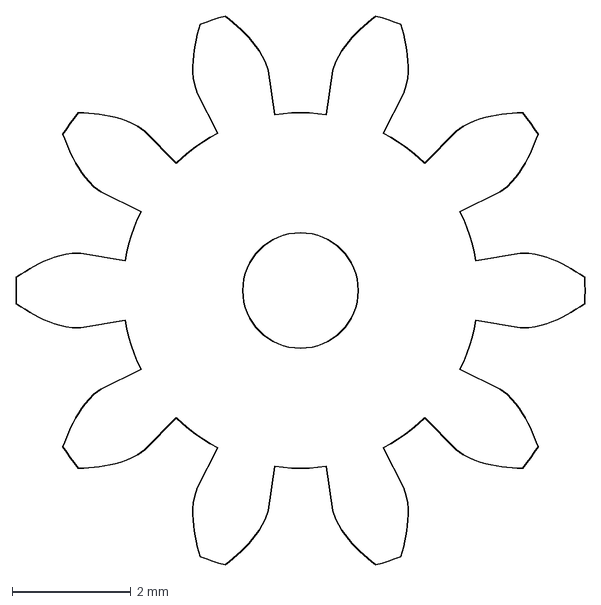
[picture p78: CAD file, 2026-10-18]
f1/cad/out/cnc_pinion_m0.8_10T.dxf
9.60 x 9.26 mm
