KVR-CIBER/sc02-solar-hypercar/f1/cad/out/step/onderdelen/clip_0R.step

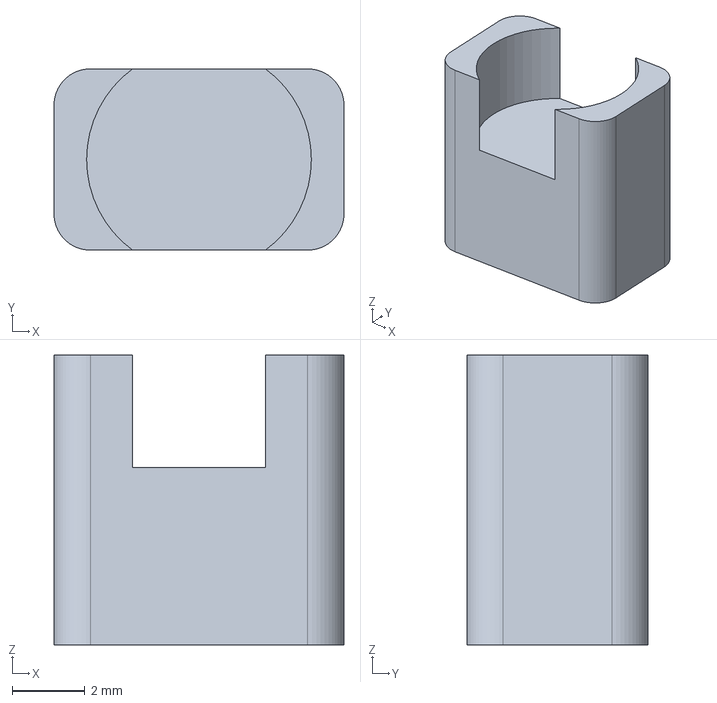
[picture p79: CAD file, 2026-10-18]
f1/cad/out/step/onderdelen/clip_0R.step
8.00 x 5.00 x 8.00 mm
