KVR-CIBER/sc02-solar-hypercar/f1/P1S_STEP/bambu_3mf/7a_tyre_mold_bottom_cores_PLA.3mf

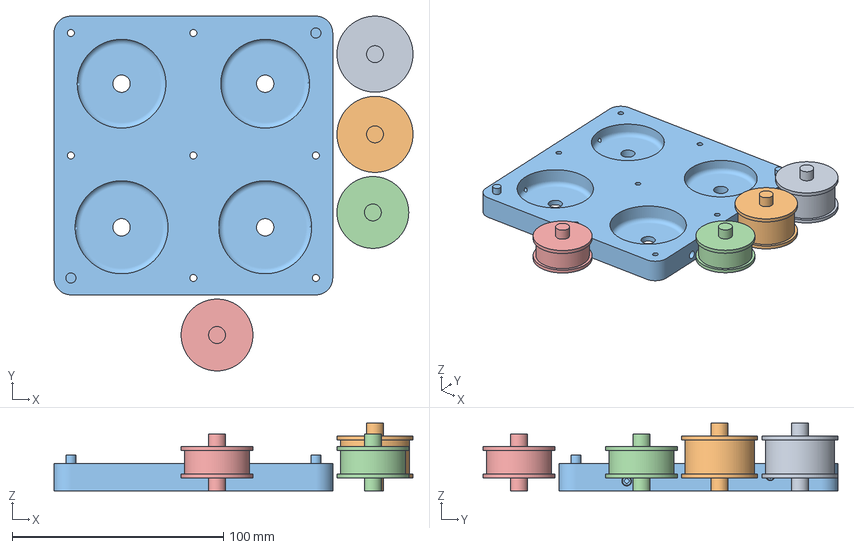
[picture p80: CAD file, 2026-10-16]
f1/P1S_STEP/bambu_3mf/7a_tyre_mold_bottom_cores_PLA.3mf
170.0 x 168.0 x 32.0 mm
mold_core_rear_0_0.stl x 2
mold_bottom_0_0.stl
mold_core_front_0_0.stl x 2
