KVR-CIBER/sc02-solar-hypercar/f1/P1S_STEP/onderdelen/clip_2L.step

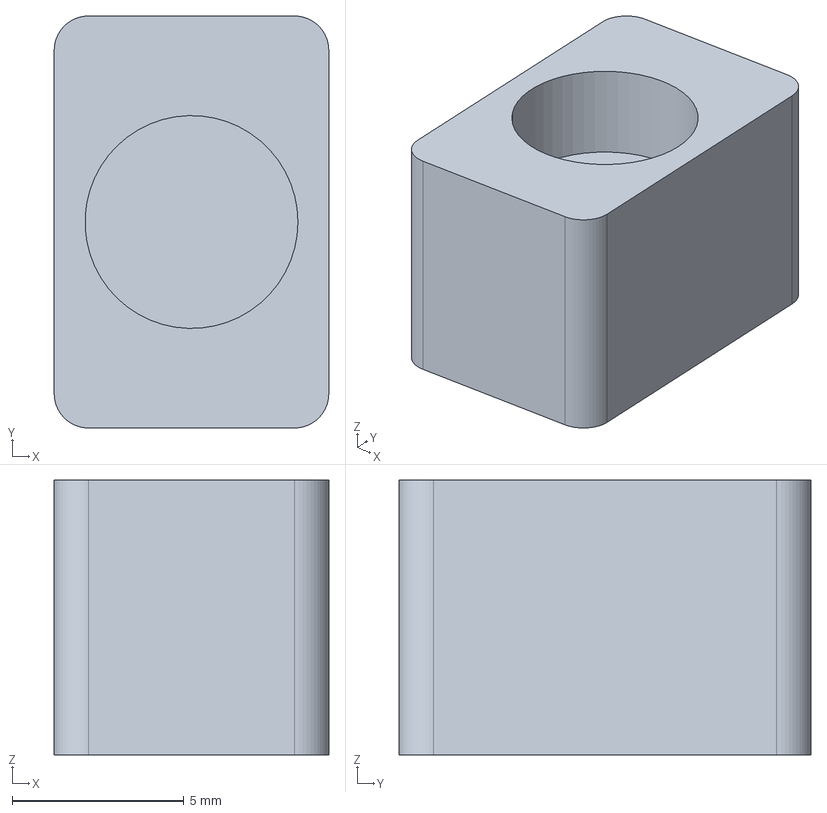
[picture p81: CAD file, 2026-10-16]
f1/P1S_STEP/onderdelen/clip_2L.step
8.00 x 12.0 x 8.00 mm
