KVR-CIBER/sc02-solar-hypercar/PRINTEN_PLA_TPU/PLA/2x_rim_rear.stl

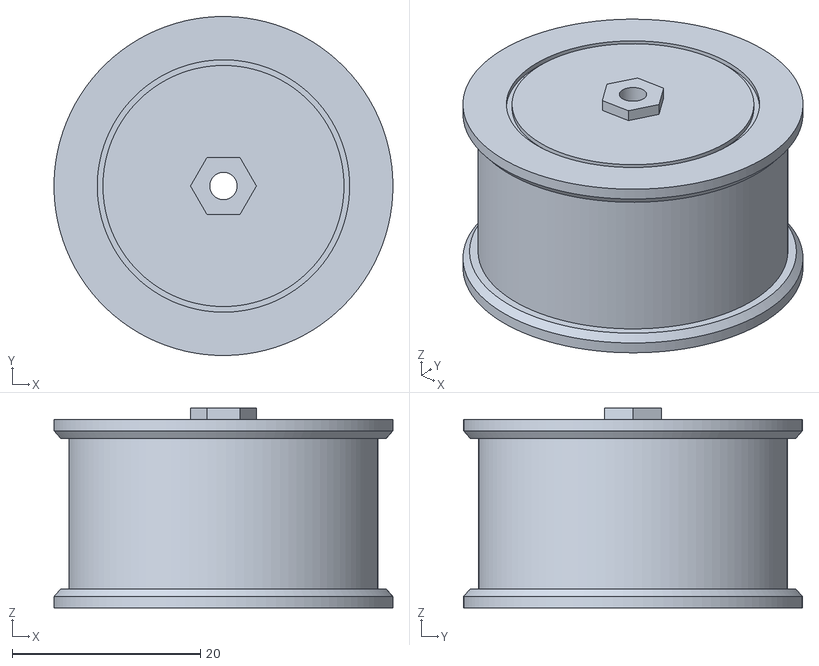
[picture p82: CAD file, 2026-10-16]
PRINTEN_PLA_TPU/PLA/2x_rim_rear.stl
36.0 x 36.0 x 21.2
