KVR-CIBER/sc02-solar-hypercar/cad/out/render_parts/tyre_170.0_-1.stl

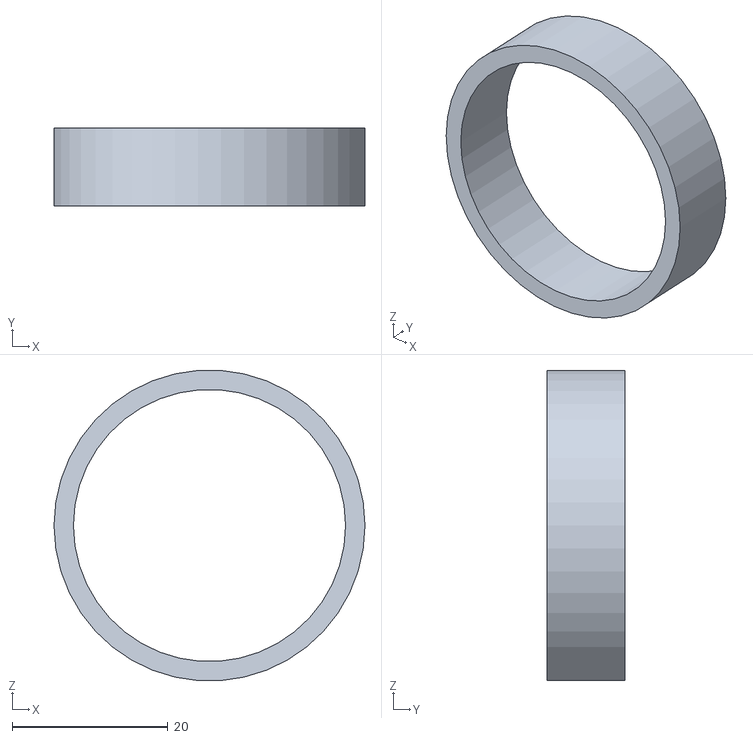
[picture p83: CAD file, 2026-10-16]
cad/out/render_parts/tyre_170.0_-1.stl
40.0 x 10.0 x 39.9
