KVR-CIBER/sc02-solar-hypercar/f1/cad/out/stl/bearing_cap_L.stl

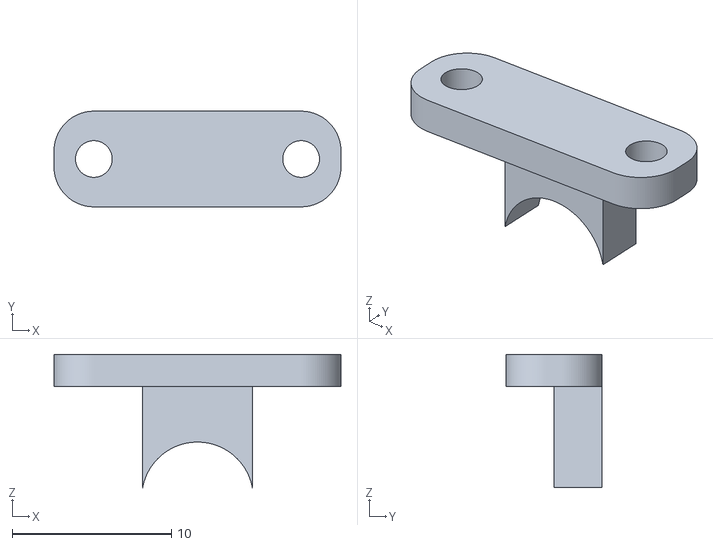
[picture p84: CAD file, 2026-10-21]
f1/cad/out/stl/bearing_cap_L.stl
18.0 x 6.00 x 8.35
