KVR-CIBER/sc02-solar-hypercar/f1/P1S_STEP/onderdelen/rim_front.step

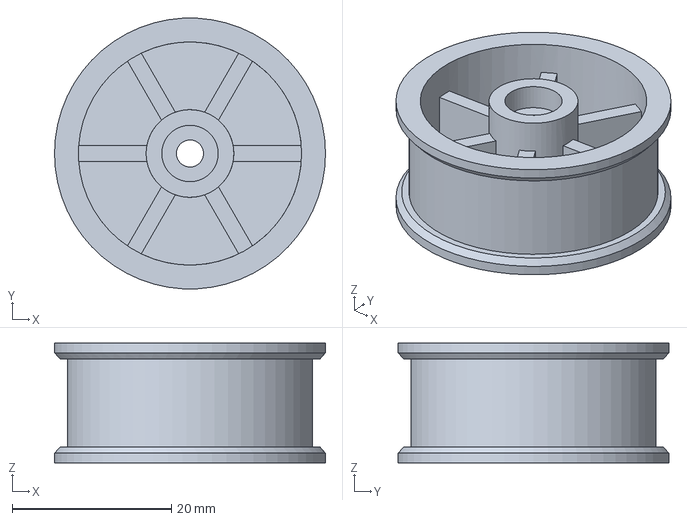
[picture p85: CAD file, 2026-10-16]
f1/P1S_STEP/onderdelen/rim_front.step
34.0 x 34.0 x 15.0 mm
