KVR-CIBER/sc02-solar-hypercar/cad/out/render_parts/rim_0_-1.stl

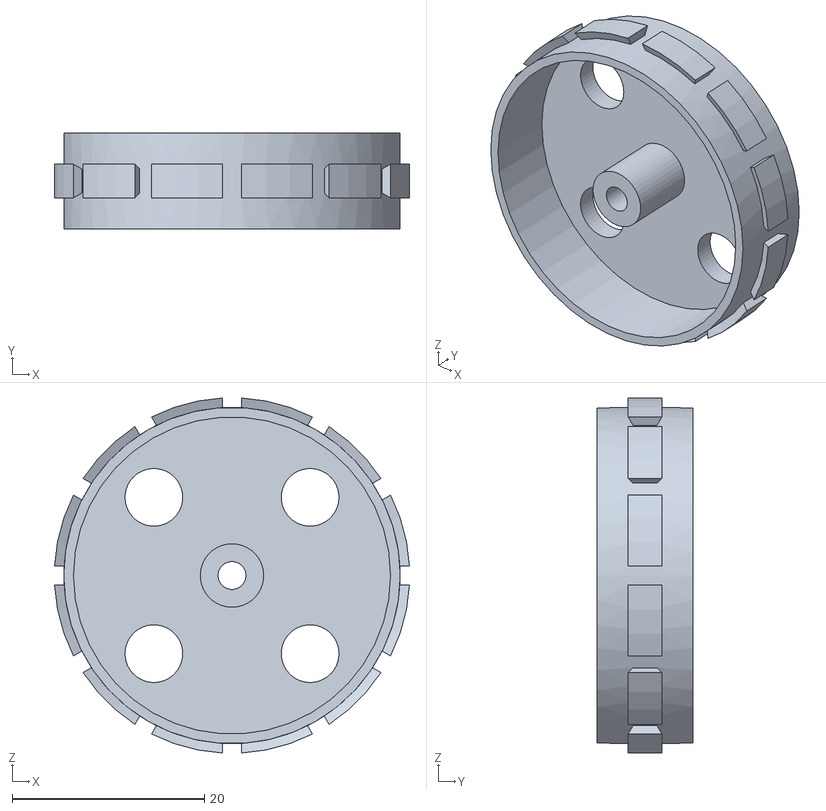
[picture p86: CAD file, 2026-10-16]
cad/out/render_parts/rim_0_-1.stl
36.9 x 10.0 x 36.9
