KVR-CIBER/sc02-solar-hypercar/cad/out/step/mold_lid.step

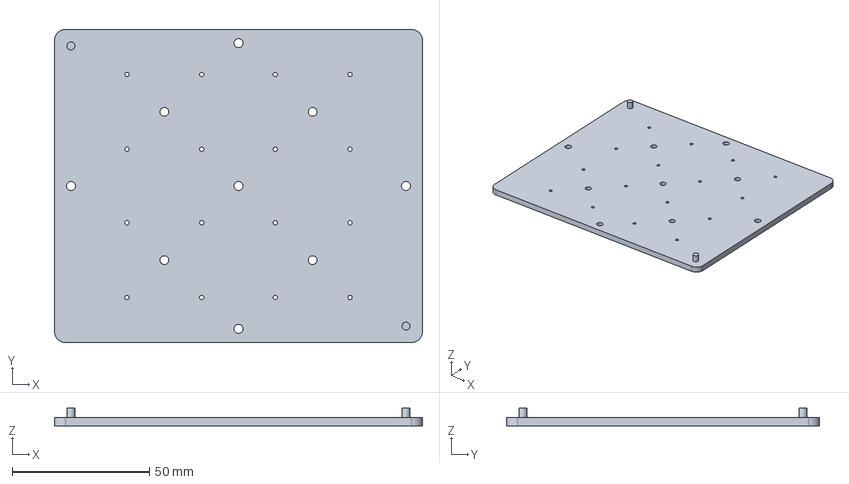
[picture p87: CAD file, 2026-10-16]
cad/out/step/mold_lid.step
134.0 x 114.0 x 6.50 mm
