KVR-CIBER/sc02-solar-hypercar/f1/P1S_STEP/bambu_3mf/5_aero_black_ASA.3mf

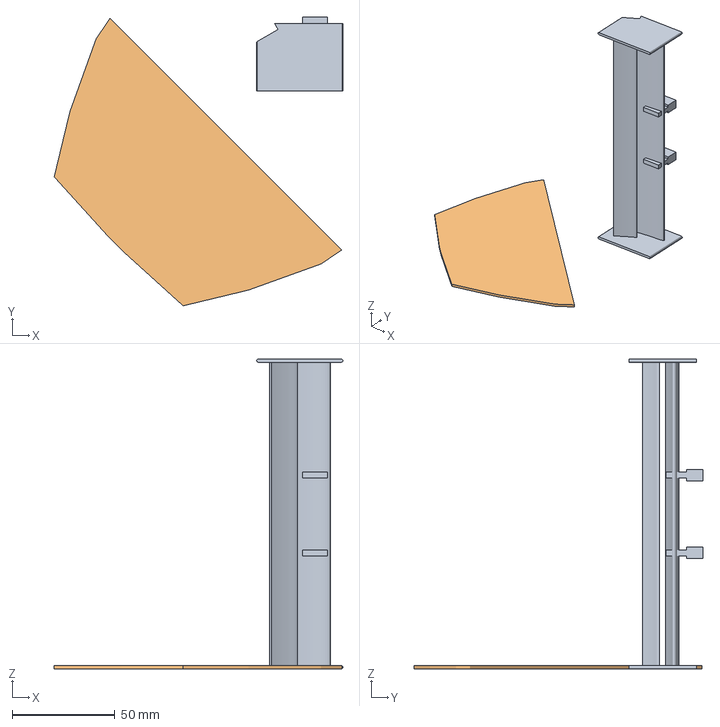
[picture p88: CAD file, 2026-10-16]
f1/P1S_STEP/bambu_3mf/5_aero_black_ASA.3mf
140.8 x 140.8 x 151.2 mm
rear_wing_90_0.stl
splitter_0_0.stl
