KVR-CIBER/sc02-solar-hypercar/cad/out/render_parts/chassis.stl

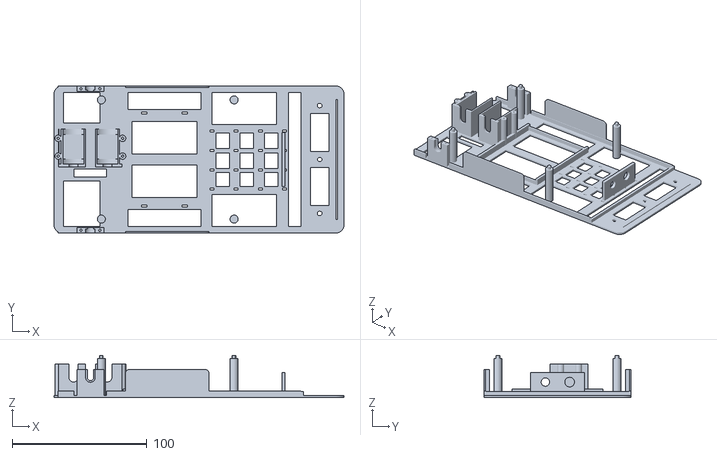
[picture p89: CAD file, 2026-10-16]
cad/out/render_parts/chassis.stl
215.0 x 109.0 x 31.5
