KVR-CIBER/sc02-solar-hypercar/f1/cad/out/step/onderdelen/bearing_cap_R.step

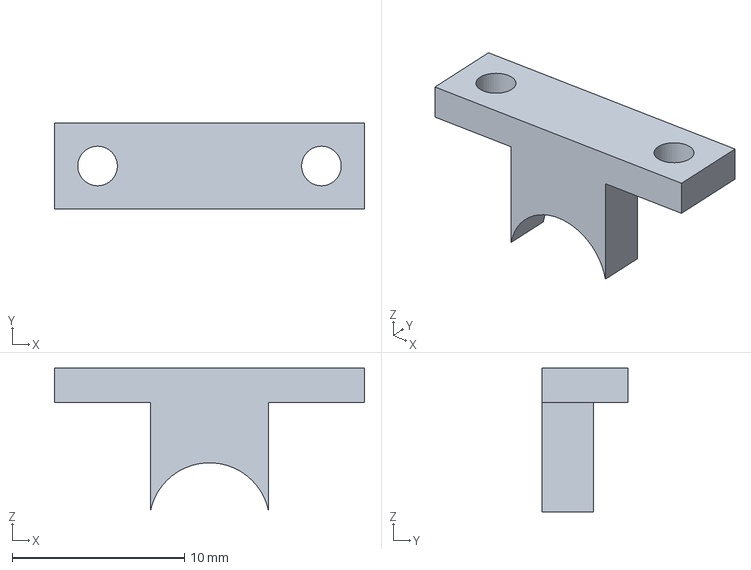
[picture p90: CAD file, 2026-10-18]
f1/cad/out/step/onderdelen/bearing_cap_R.step
18.0 x 5.00 x 8.35 mm
