KVR-CIBER/sc02-solar-hypercar/f1/cad/out/stl/rear_module.stl

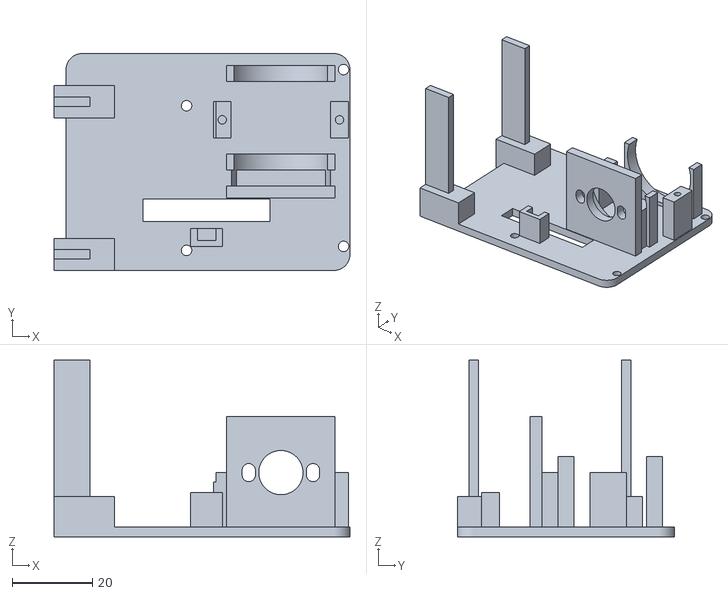
[picture p91: CAD file, 2026-10-20]
f1/cad/out/stl/rear_module.stl
73.7 x 54.0 x 44.0
