KVR-CIBER/sc02-solar-hypercar/f1/P1S_STEP/bambu_3mf/2_body_nose_ASA.3mf

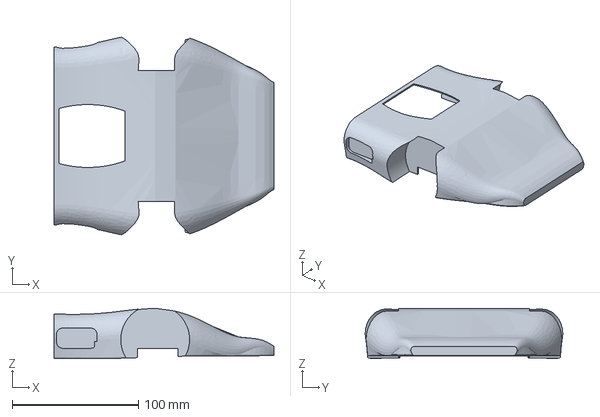
[picture p92: CAD file, 2026-10-16]
f1/P1S_STEP/bambu_3mf/2_body_nose_ASA.3mf
174.0 x 156.3 x 39.6 mm
