KVR-CIBER/sc02-solar-hypercar/f1/P1S_STEP/platen/5_aero_black_ASA.step

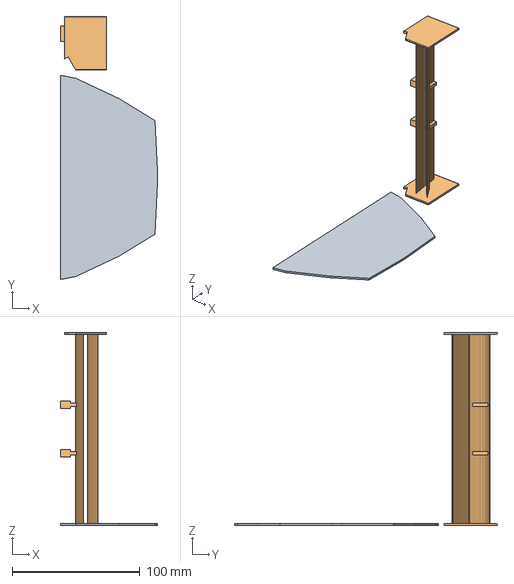
[picture p93: CAD file, 2026-10-16]
f1/P1S_STEP/platen/5_aero_black_ASA.step
76.0 x 205.9 x 151.2 mm
splitter_1
rear_wing_0
