KVR-CIBER/sc02-solar-hypercar/f1/cad/out/stl/esc_tray.stl

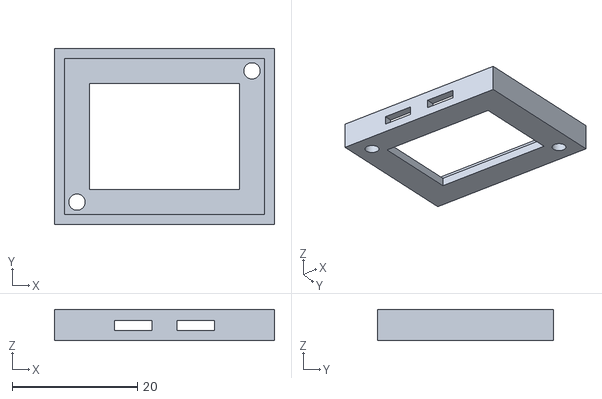
[picture p94: CAD file, 2026-10-20]
f1/cad/out/stl/esc_tray.stl
35.2 x 28.2 x 5.00
