KVR-CIBER/sc02-solar-hypercar/f1/P1S_STEP/bambu_3mf/8_option_TPU_tyres.3mf

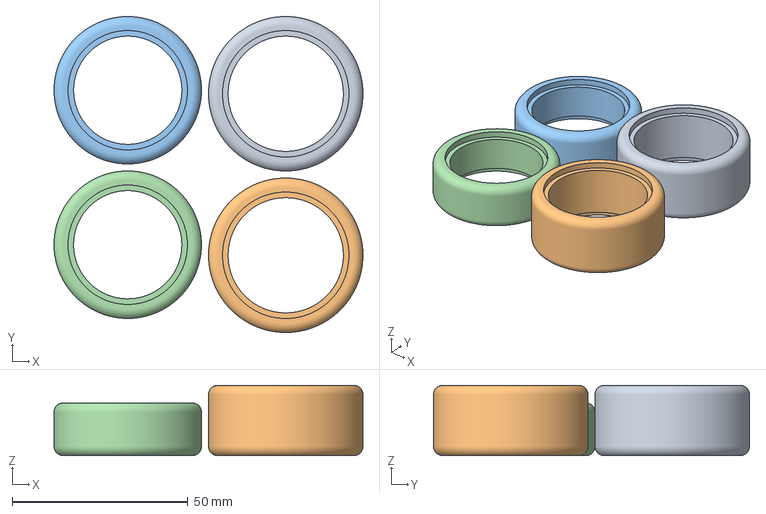
[picture p95: CAD file, 2026-10-16]
f1/P1S_STEP/bambu_3mf/8_option_TPU_tyres.3mf
88.0 x 90.0 x 20.0 mm
tyre_rear_0_0.stl x 2
tyre_front_0_0.stl x 2
