KVR-CIBER/sc02-solar-hypercar/f1/P1S_STEP/onderdelen/battery_tray.step

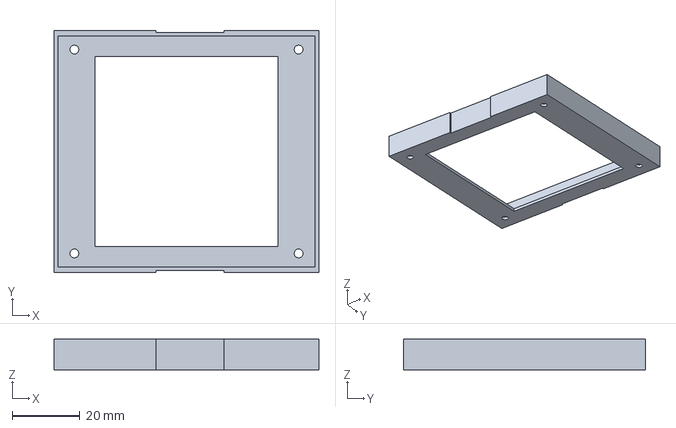
[picture p96: CAD file, 2026-10-16]
f1/P1S_STEP/onderdelen/battery_tray.step
78.0 x 71.2 x 9.00 mm
