KVR-CIBER/sc02-solar-hypercar/cad/out/render_parts/cells.stl

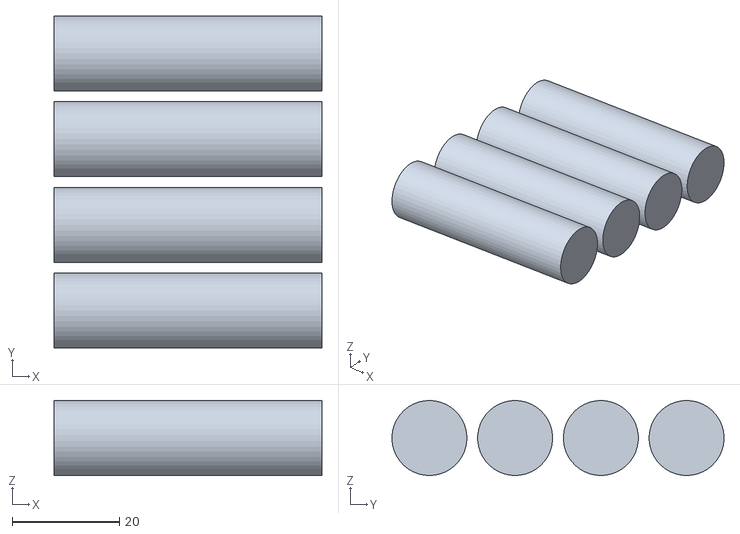
[picture p97: CAD file, 2026-10-16]
cad/out/render_parts/cells.stl
50.0 x 62.0 x 14.0
