KVR-CIBER/sc02-solar-hypercar/f1/cad/out/step/onderdelen/rear_wing.step

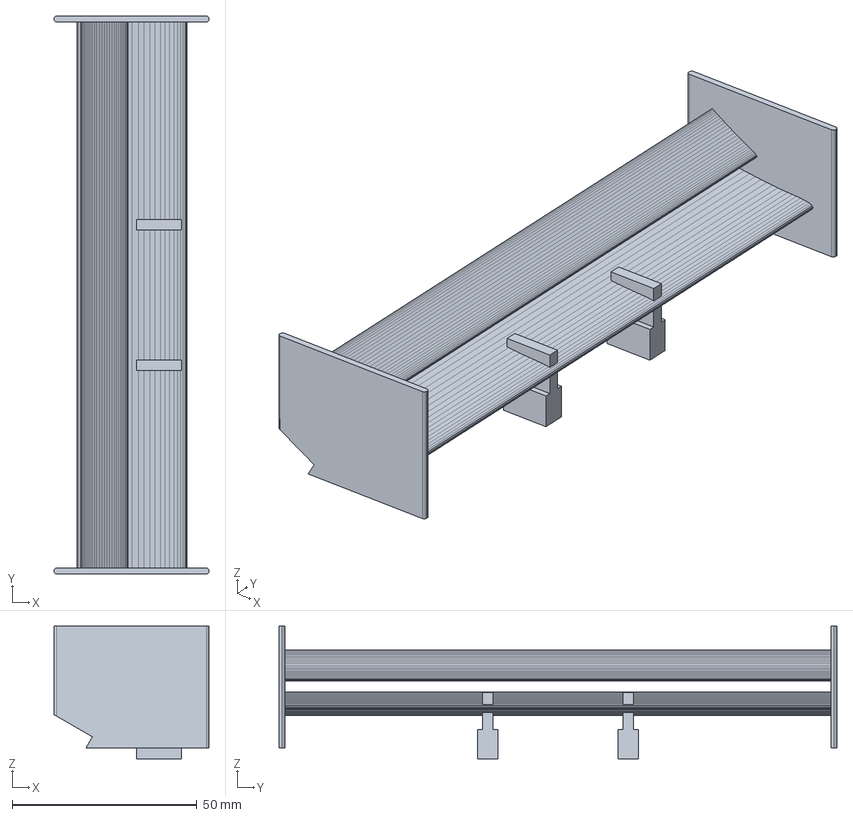
[picture p98: CAD file, 2026-10-18]
f1/cad/out/step/onderdelen/rear_wing.step
42.0 x 151.2 x 36.0 mm
