KVR-CIBER/sc02-solar-hypercar/f1/cad/out/stl/battery_tray.stl

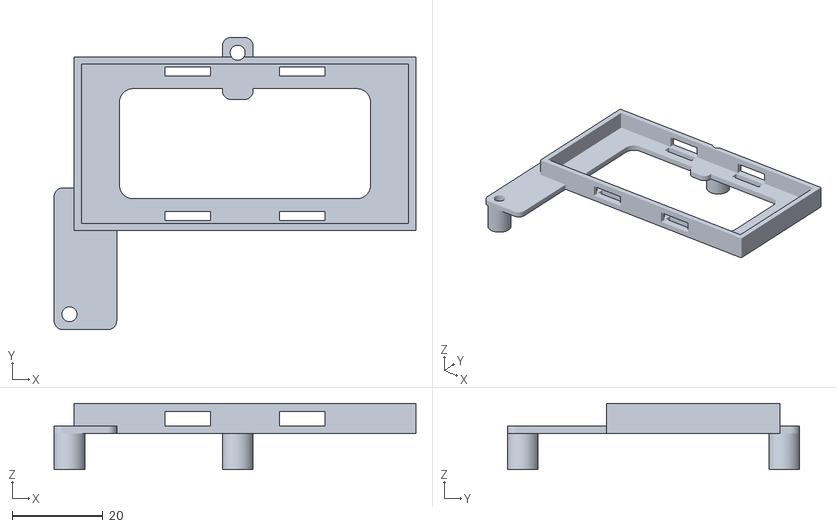
[picture p99: CAD file, 2026-10-20]
f1/cad/out/stl/battery_tray.stl
79.6 x 64.3 x 14.6
