KVR-CIBER/sc02-solar-hypercar/f1/P1S_STEP/onderdelen/mold_core_rear.step

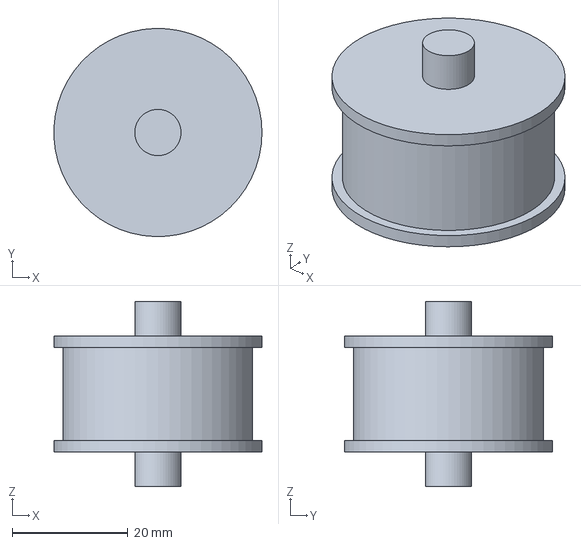
[picture p100: CAD file, 2026-10-16]
f1/P1S_STEP/onderdelen/mold_core_rear.step
36.0 x 36.0 x 32.0 mm
