KVR-CIBER/sc02-solar-hypercar/cad/out/render_parts/cap_0_-1.stl

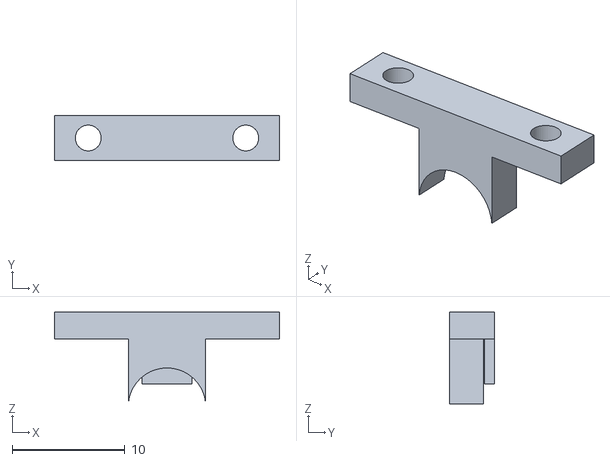
[picture p101: CAD file, 2026-10-16]
cad/out/render_parts/cap_0_-1.stl
20.0 x 4.00 x 8.14
