KVR-CIBER/sc02-solar-hypercar/cad/out/step/rim_tpu.step

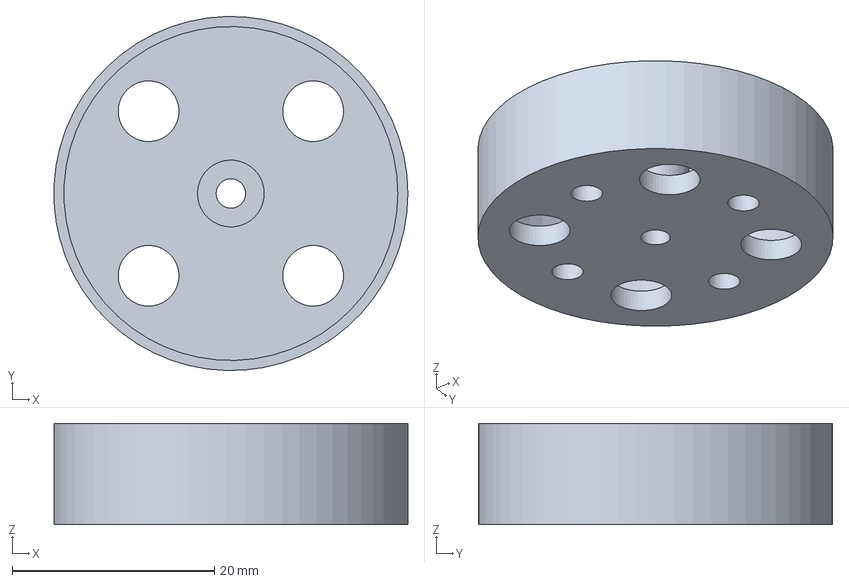
[picture p102: CAD file, 2026-10-16]
cad/out/step/rim_tpu.step
35.0 x 35.0 x 10.0 mm
