KVR-CIBER/sc02-solar-hypercar/f1/cad/out/stl/motor_clamp.stl

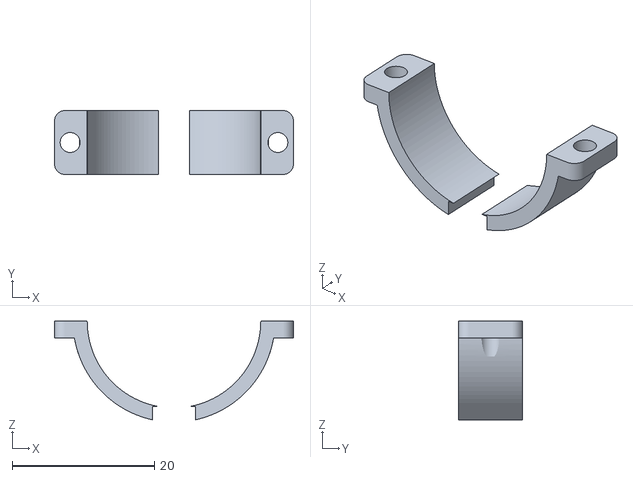
[picture p103: CAD file, 2026-10-20]
f1/cad/out/stl/motor_clamp.stl
33.6 x 9.00 x 13.9
