KVR-CIBER/sc02-solar-hypercar/cad/out/render_parts/axles.stl

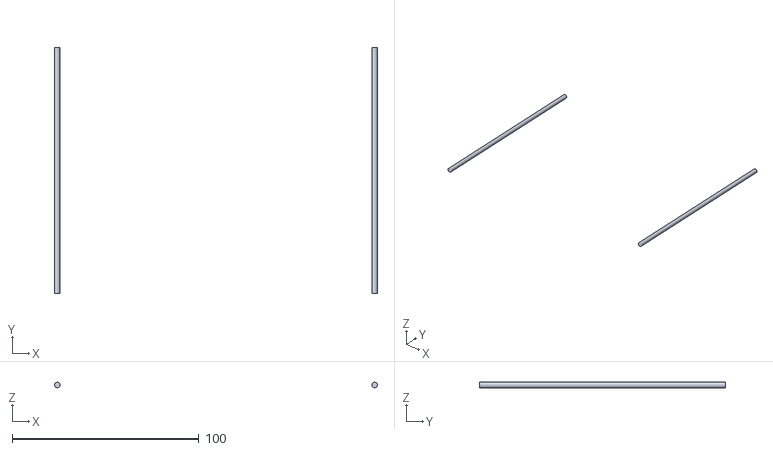
[picture p104: CAD file, 2026-10-16]
cad/out/render_parts/axles.stl
173.0 x 132.0 x 3.00
