KVR-CIBER/sc02-solar-hypercar/cad/out/step/tyre_tpu.step

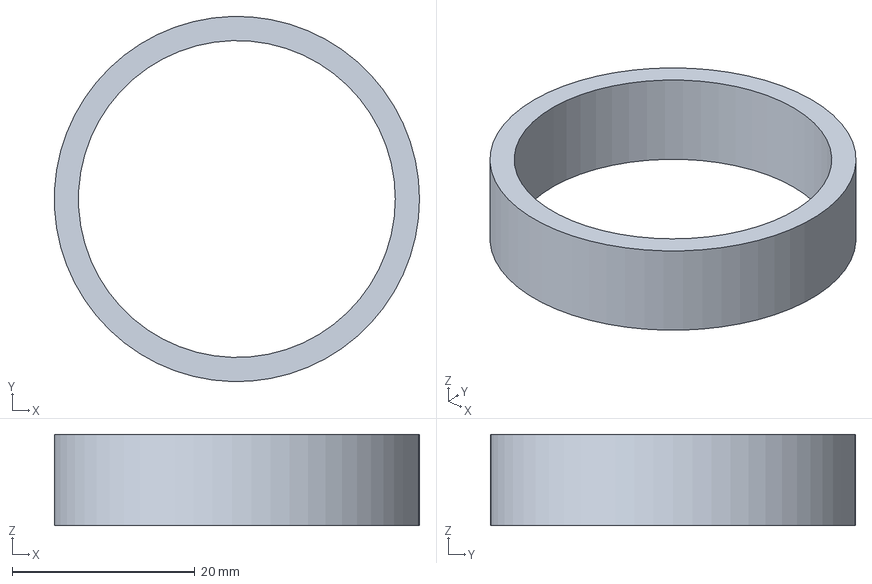
[picture p105: CAD file, 2026-10-16]
cad/out/step/tyre_tpu.step
40.0 x 40.0 x 10.0 mm
