KVR-CIBER/sc02-solar-hypercar/f1/cad/out/step/onderdelen/mold_core_front.step

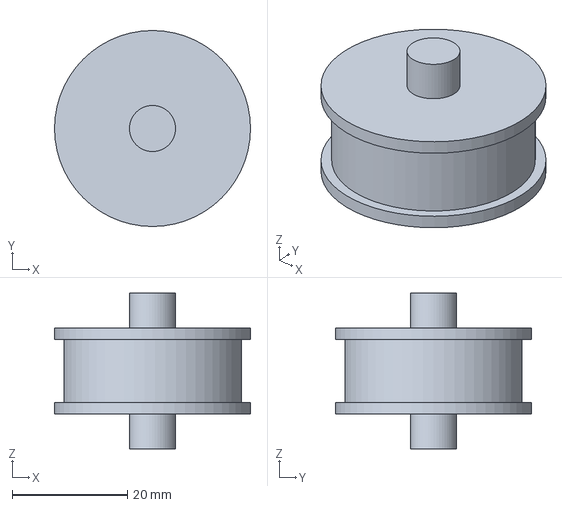
[picture p106: CAD file, 2026-10-18]
f1/cad/out/step/onderdelen/mold_core_front.step
34.0 x 34.0 x 27.0 mm
