KVR-CIBER/sc02-solar-hypercar/f1/cad/out/stl/pcb_posts.stl

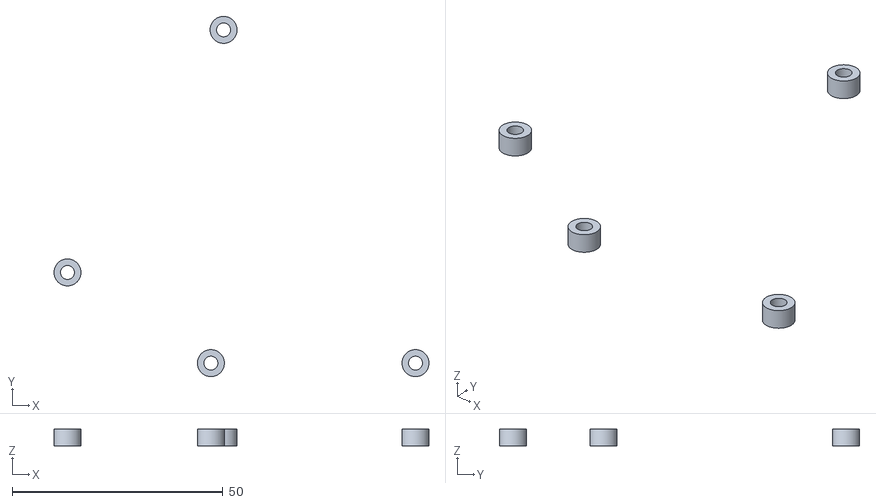
[picture p107: CAD file, 2026-10-20]
f1/cad/out/stl/pcb_posts.stl
88.9 x 85.4 x 4.00
