KVR-CIBER/sc02-solar-hypercar/f1/cad/out/step/onderdelen/motor_clamp.step

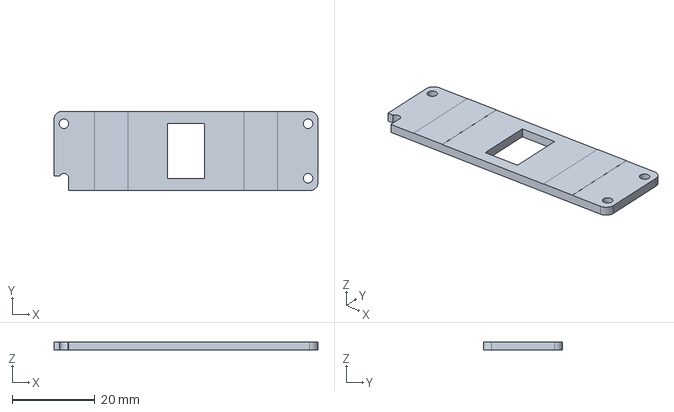
[picture p108: CAD file, 2026-10-18]
f1/cad/out/step/onderdelen/motor_clamp.step
63.9 x 19.2 x 2.05 mm
