KVR-CIBER/sc02-solar-hypercar/f1/cad/out/stl/pinion.stl

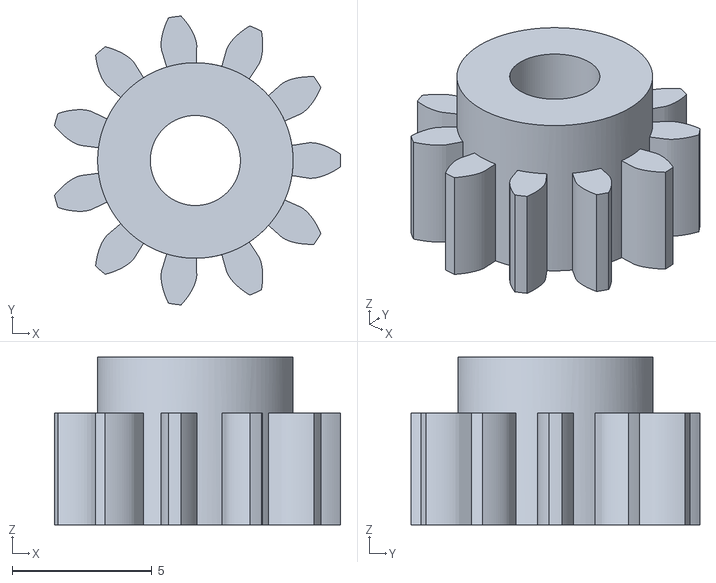
[picture p109: CAD file, 2026-10-20]
f1/cad/out/stl/pinion.stl
10.2 x 10.3 x 6.00
