KVR-CIBER/sc02-solar-hypercar/cad/out/render_parts/motors.stl

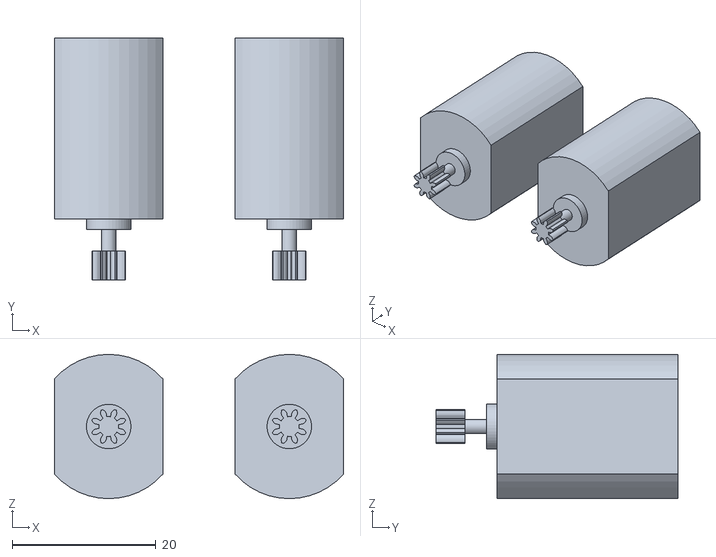
[picture p110: CAD file, 2026-10-16]
cad/out/render_parts/motors.stl
40.3 x 33.7 x 20.1
