KVR-CIBER/sc02-solar-hypercar/PRINTEN_PLA_TPU/PLA/2x_wheel_spacer.stl

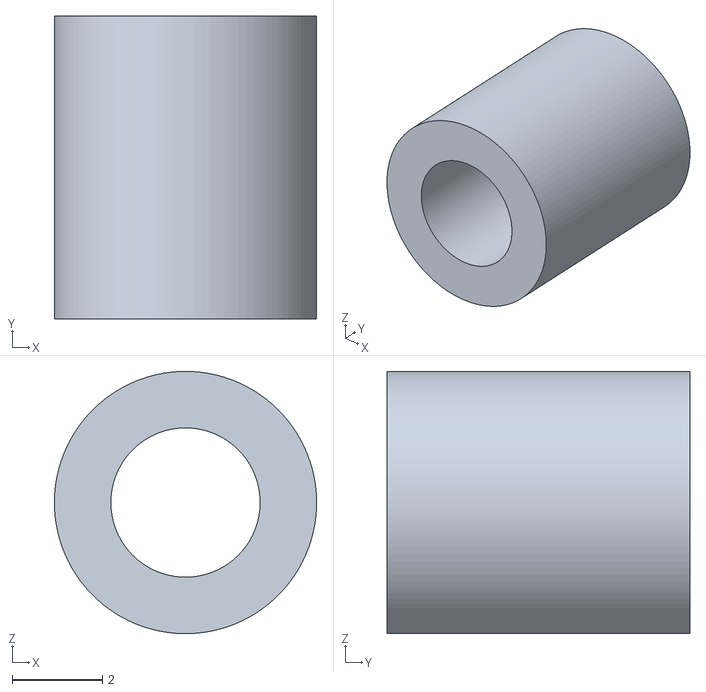
[picture p111: CAD file, 2026-10-16]
PRINTEN_PLA_TPU/PLA/2x_wheel_spacer.stl
5.80 x 6.70 x 5.80
