KVR-CIBER/sc02-solar-hypercar/f1/P1S_STEP/onderdelen/front_upright_R.step

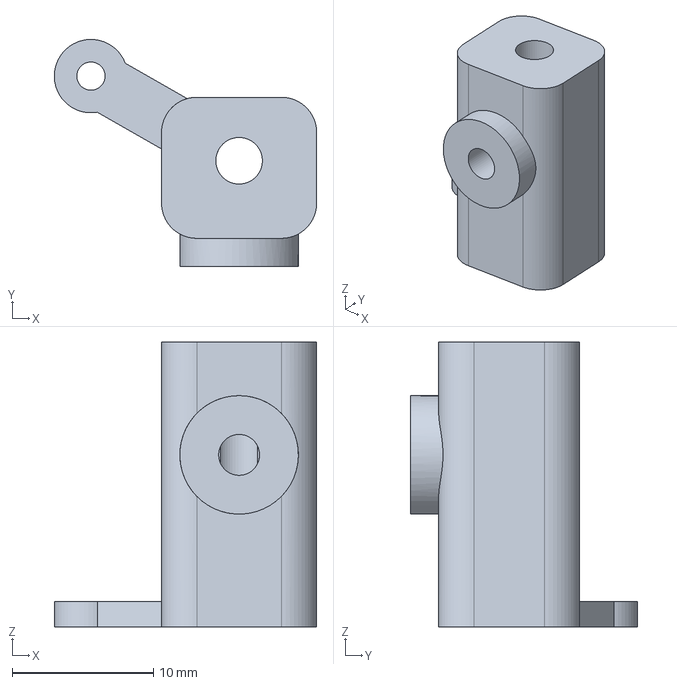
[picture p112: CAD file, 2026-10-16]
f1/P1S_STEP/onderdelen/front_upright_R.step
18.6 x 16.1 x 20.2 mm
