KVR-CIBER/sc02-solar-hypercar/cad/out/render_parts/panel.stl

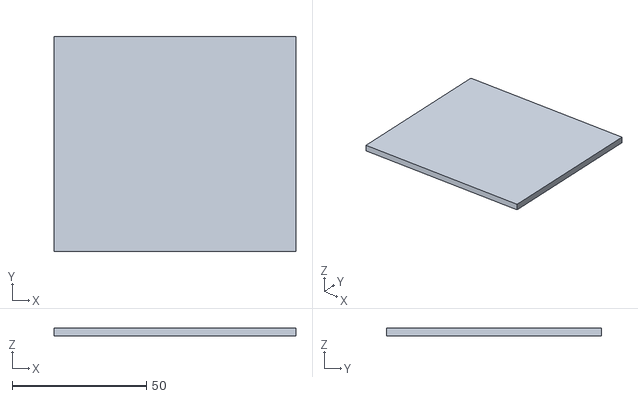
[picture p113: CAD file, 2026-10-16]
cad/out/render_parts/panel.stl
90.0 x 80.0 x 3.00
