KVR-CIBER/sc02-solar-hypercar/f1/P1S_STEP/onderdelen/mold_bottom.step

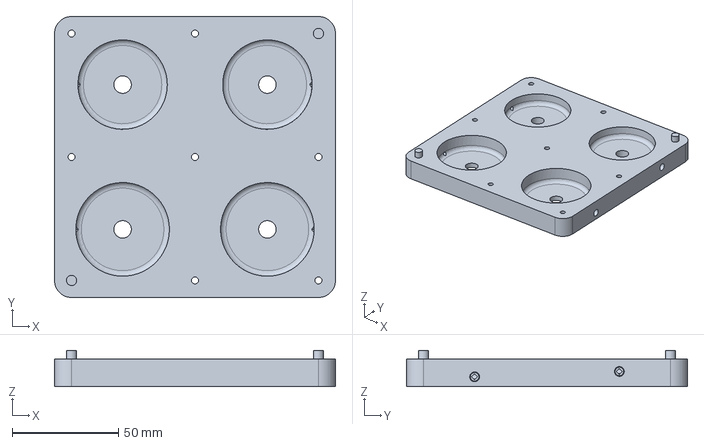
[picture p114: CAD file, 2026-10-16]
f1/P1S_STEP/onderdelen/mold_bottom.step
132.0 x 132.0 x 17.0 mm
