KVR-CIBER/sc02-solar-hypercar/f1/cad/out/step/onderdelen/spur.step

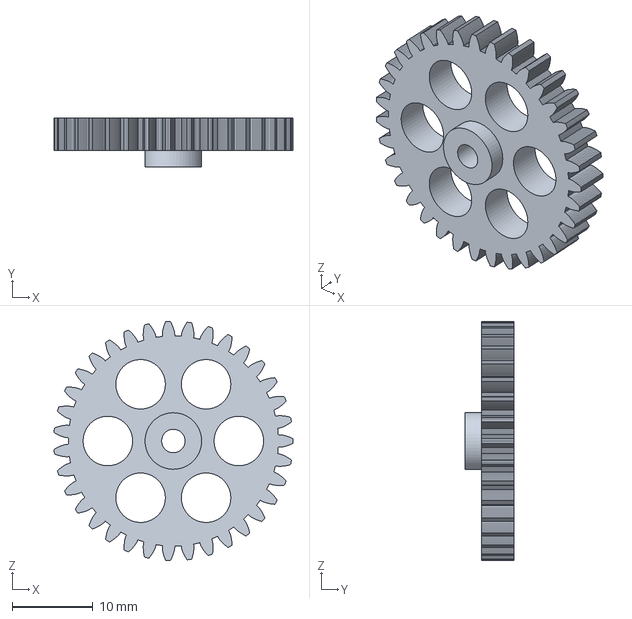
[picture p115: CAD file, 2026-10-18]
f1/cad/out/step/onderdelen/spur.step
29.6 x 6.00 x 29.6 mm
