KVR-CIBER/sc02-solar-hypercar/PRINTEN_PLA_TPU/PLA/1x_diffuser.stl

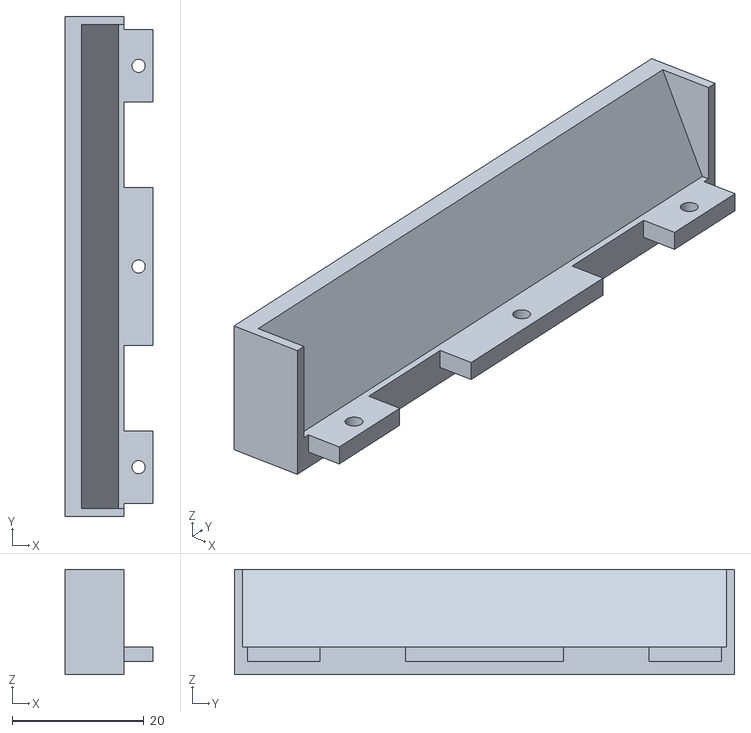
[picture p116: CAD file, 2026-10-16]
PRINTEN_PLA_TPU/PLA/1x_diffuser.stl
13.4 x 76.0 x 16.0
