KVR-CIBER/sc02-solar-hypercar/(list of files, cad)

Other CAD files:
f1/cad/out/step/onderdelen/body_main.step
f1/P1S_STEP/platen/1_body_main_ASA.step
PRINTEN_PLA_TPU/PLA/1x_body_main.stl
f1/P1S_STEP/onderdelen/body_main.step
f1/cad/out/stl/body_main.stl
cad/out/step/spur_42T_m05.step
f1/P1S_STEP/onderdelen/tie_rod_L.step
f1/cad/out/step/onderdelen/power_tray_L.step
f1/cad/out/step/8_option_TPU_tyres.step
f1/cad/out/stl/rear_bearing_L.stl
f1/P1S_STEP/platen/3_canopy_smoke_PETG.step
f1/cad/out/step/3_canopy_smoke_PETG.step
f1/cad/out/step/onderdelen/tyre_rear.step
f1/P1S_STEP/bambu_3mf/7b_tyre_mold_top_PLA.3mf
f1/P1S_STEP/platen/7b_tyre_mold_top_PLA.step
PRINTEN_PLA_TPU/PLA/1x_steering_horn.stl
f1/cad/out/step/2_body_nose_ASA.step
f1/cad/out/step/onderdelen/mold_top.step
f1/cad/out/stl/bearing_cap_R.stl
f1/P1S_STEP/onderdelen/rear_bearing_L.step
f1/P1S_STEP/platen/7a_tyre_mold_bottom_cores_PLA.step
PRINTEN_PLA_TPU/PLA/1x_rear_bearing_R.stl
cad/out/step/rim_silicone.step
f1/cad/out/step/6_wheels_PLA.step
f1/P1S_STEP/onderdelen/tyre_front.step
PRINTEN_PLA_TPU/PLA/1x_clip_2R.stl
cad/out/render_parts/tyre_0_-1.stl
cad/out/step/chassis.step
f1/cad/out/step/5_aero_black_ASA.step
f1/cad/out/step/onderdelen/steering_horn.step
f1/P1S_STEP/platen/4_chassis_parts_ASA.step
PRINTEN_PLA_TPU/PLA/1x_canopy.stl
cad/out/step/motor_clamp.step
f1/cad/out/step/onderdelen/mold_core_rear.step
f1/P1S_STEP/onderdelen/esp_bridge.step
PRINTEN_PLA_TPU/PLA/1x_body_nose.stl
f1/P1S_STEP/onderdelen/clip_0R.step
PRINTEN_PLA_TPU/PLA/1x_splitter.stl
cad/out/render_parts/front_carrier.stl
cad/out/step/bearing_cap.step
f1/P1S_STEP/onderdelen/clip_3L.step
PRINTEN_PLA_TPU/PLA/1x_bearing_cap_R.stl
cad/out/render_parts/cap_170.0_-1.stl
f1/cad/out/step/onderdelen/tie_rod_R.step
f1/cad/out/stl/tie_rod_R.stl
f1/P1S_STEP/onderdelen/rear_wing.step
PRINTEN_PLA_TPU/PLA/1x_rear_wing.stl
f1/cad/out/step/onderdelen/power_tray_R.step
cad/out/render_parts/panel_frame.stl
f1/cad/out/step/onderdelen/tyre_front.step
PRINTEN_PLA_TPU/PLA/1x_power_tray_L.stl
f1/cad/out/step/onderdelen/rear_bearing_L.step
f1/cad/out/stl/clip_0R.stl
PRINTEN_PLA_TPU/PLA/1x_tie_rod_R.stl
cad/out/render_parts/rim_170.0_-1.stl
f1/cad/out/stl/clip_0L.stl
f1/P1S_STEP/onderdelen/mold_top.step
f1/cad/out/step/onderdelen/clip_1L.step
f1/cad/out/stl/front_upright_R.stl
f1/P1S_STEP/onderdelen/pinion.step
f1/cad/out/step/onderdelen/clip_1R.step
f1/cad/out/stl/rim_rear.stl
f1/P1S_STEP/onderdelen/spur.step
PRINTEN_PLA_TPU/PLA/1x_battery_tray.stl
PRINTEN_PLA_TPU/PLA/1x_bearing_cap_L.stl
PRINTEN_PLA_TPU/PLA/1x_clip_0L.stl
PRINTEN_PLA_TPU/PLA/1x_clip_0R.stl
PRINTEN_PLA_TPU/PLA/1x_clip_2L.stl
PRINTEN_PLA_TPU/PLA/1x_front_module.stl
PRINTEN_PLA_TPU/PLA/1x_front_upright_L.stl
PRINTEN_PLA_TPU/PLA/1x_front_upright_R.stl
PRINTEN_PLA_TPU/PLA/1x_motor_clamp.stl
PRINTEN_PLA_TPU/PLA/1x_pi_tray.stl
PRINTEN_PLA_TPU/PLA/1x_power_tray_R.stl
PRINTEN_PLA_TPU/PLA/1x_rear_module.stl
PRINTEN_PLA_TPU/PLA/1x_tie_rod_L.stl
PRINTEN_PLA_TPU/PLA/2x_rim_front.stl
PRINTEN_PLA_TPU/PLA/2x_spur.stl
PRINTEN_PLA_TPU/PLA/4x_pinion.stl
cad/out/render_parts/cap_0_1.stl
cad/out/render_parts/cap_170.0_1.stl
cad/out/render_parts/rim_0_1.stl
cad/out/render_parts/rim_170.0_1.stl
cad/out/render_parts/tyre_0_1.stl
cad/out/render_parts/tyre_170.0_1.stl
cad/out/stl/bearing_cap.stl
cad/out/stl/front_carrier.stl
cad/out/stl/mold_base.stl
cad/out/stl/mold_lid.stl
cad/out/stl/motor_clamp.stl
cad/out/stl/panel_frame.stl
cad/out/stl/rim_silicone.stl
cad/out/stl/rim_tpu.stl
cad/out/stl/spacer.stl
cad/out/stl/spur_42T_m05.stl
cad/out/stl/tyre_tpu.stl
f1/P1S_STEP/onderdelen/bearing_cap_L.step
f1/P1S_STEP/onderdelen/bearing_cap_R.step
f1/P1S_STEP/onderdelen/body_nose.step
f1/P1S_STEP/onderdelen/canopy.step
f1/P1S_STEP/onderdelen/clip_0L.step
f1/P1S_STEP/onderdelen/clip_1L.step
f1/P1S_STEP/onderdelen/clip_1R.step
f1/P1S_STEP/onderdelen/clip_2R.step
f1/P1S_STEP/onderdelen/clip_3R.step
f1/P1S_STEP/onderdelen/diffuser.step
f1/P1S_STEP/onderdelen/front_module.step
f1/P1S_STEP/onderdelen/front_upright_L.step
f1/P1S_STEP/onderdelen/mold_core_front.step
f1/P1S_STEP/onderdelen/motor_clamp.step
f1/P1S_STEP/onderdelen/pi_tray.step
f1/P1S_STEP/onderdelen/power_tray_L.step
f1/P1S_STEP/onderdelen/rear_bearing_R.step
f1/P1S_STEP/onderdelen/rear_module.step
f1/P1S_STEP/onderdelen/rim_rear.step
f1/P1S_STEP/onderdelen/splitter.step
f1/P1S_STEP/onderdelen/tyre_rear.step
f1/P1S_STEP/onderdelen/wheel_spacer.step
f1/cad/out/print/7b_tyre_mold_top_PLA.3mf
f1/cad/out/step/onderdelen/battery_tray.step
f1/cad/out/step/onderdelen/bearing_cap_L.step
f1/cad/out/step/onderdelen/body_nose.step
f1/cad/out/step/onderdelen/canopy.step
f1/cad/out/step/onderdelen/clip_0L.step
f1/cad/out/step/onderdelen/clip_2L.step
f1/cad/out/step/onderdelen/clip_2R.step
f1/cad/out/step/onderdelen/clip_3L.step
f1/cad/out/step/onderdelen/clip_3R.step
f1/cad/out/step/onderdelen/diffuser.step
f1/cad/out/step/onderdelen/esp_bridge.step
f1/cad/out/step/onderdelen/front_module.step
f1/cad/out/step/onderdelen/front_upright_L.step
f1/cad/out/step/onderdelen/front_upright_R.step
f1/cad/out/step/onderdelen/mold_bottom.step
f1/cad/out/step/onderdelen/pi_tray.step
f1/cad/out/step/onderdelen/rear_bearing_R.step
f1/cad/out/step/onderdelen/rear_module.step
f1/cad/out/step/onderdelen/rim_front.step
f1/cad/out/step/onderdelen/rim_rear.step
f1/cad/out/step/onderdelen/tie_rod_L.step
f1/cad/out/step/onderdelen/wheel_spacer.step
f1/cad/out/stl/body_nose.stl
f1/cad/out/stl/canopy.stl
f1/cad/out/stl/front_module.stl
f1/cad/out/stl/front_upright_L.stl
f1/cad/out/stl/mold_bottom.stl
f1/cad/out/stl/mold_core_front.stl
f1/cad/out/stl/mold_core_rear.stl
f1/cad/out/stl/mold_top.stl
f1/cad/out/stl/pi_tray.stl
f1/cad/out/stl/power_tray_L.stl
f1/cad/out/stl/power_tray_R.stl
f1/cad/out/stl/rear_wing.stl
f1/cad/out/stl/rim_front.stl
f1/cad/out/stl/splitter.stl
f1/cad/out/stl/spur.stl
f1/cad/out/stl/steering_horn.stl
f1/cad/out/stl/tie_rod_L.stl
f1/cad/out/stl/wheel_spacer.stl
