KVR-CIBER/sc02-solar-hypercar/f1/docs/wiring_sc02.png

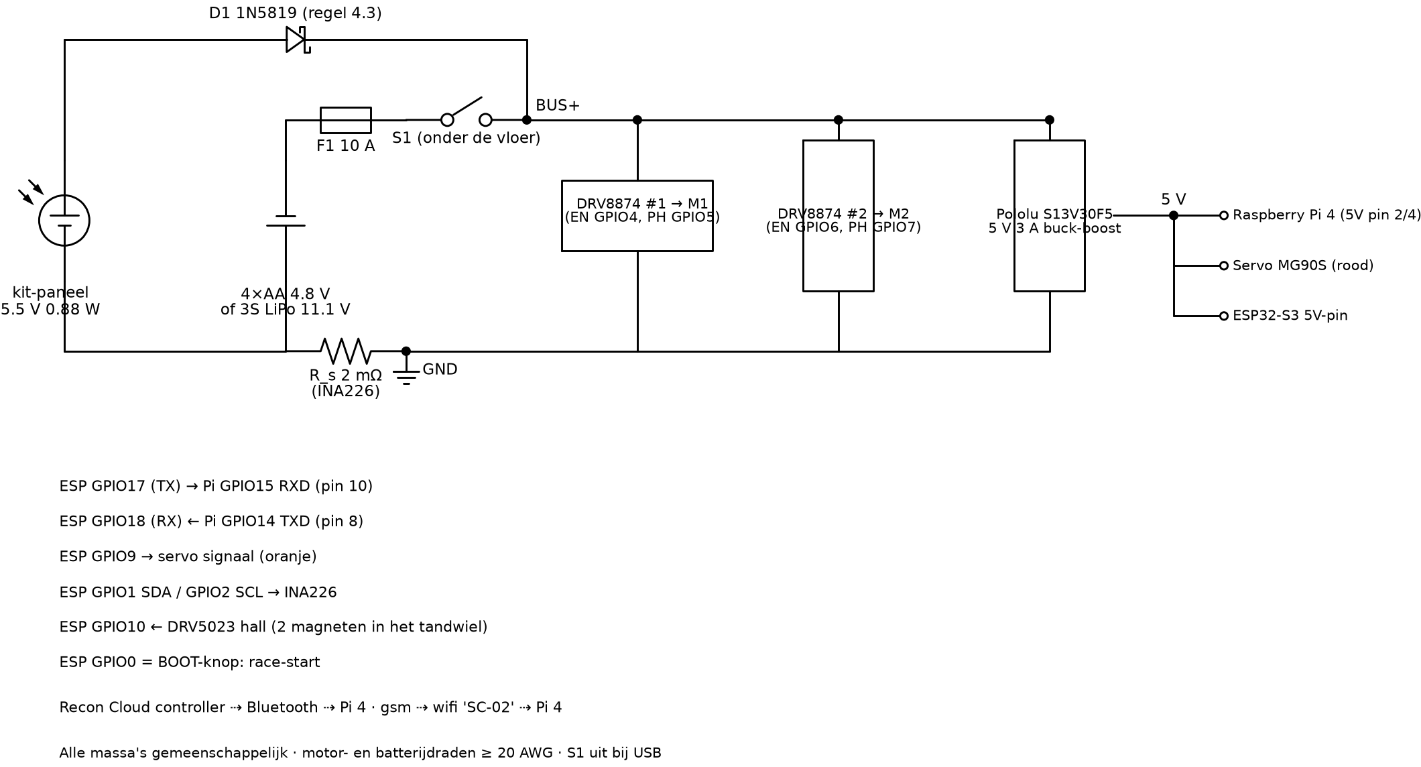
f1/docs/wiring_sc02.png
