KVR-CIBER/sc02-solar-hypercar/video/assembly/assets/lipo_end.png

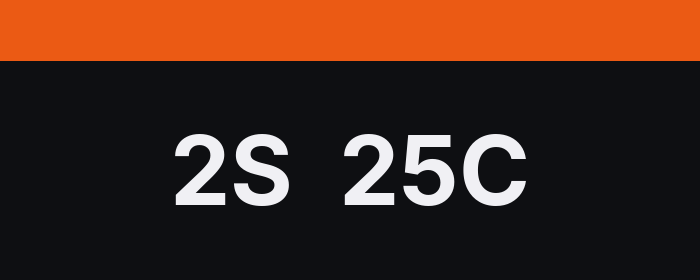
video/assembly/assets/lipo_end.png
