KVR-CIBER/sc02-solar-hypercar/video/assembly/assets/lipo_label.png

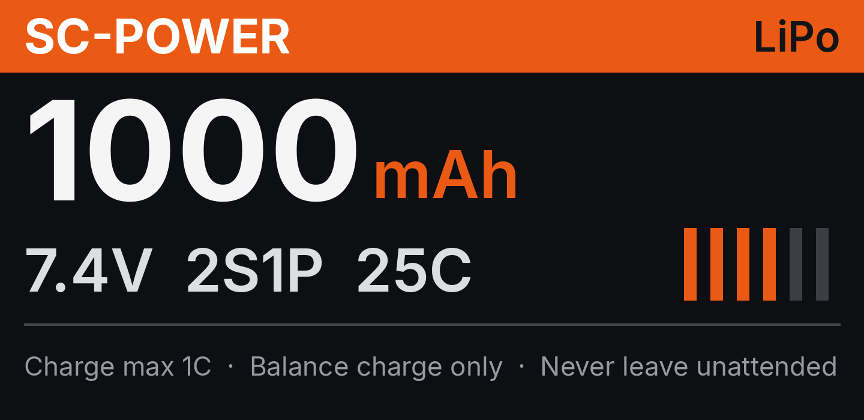
video/assembly/assets/lipo_label.png
