KVR-CIBER/sc02-solar-hypercar/video/assembly/assets/lipo_side.png

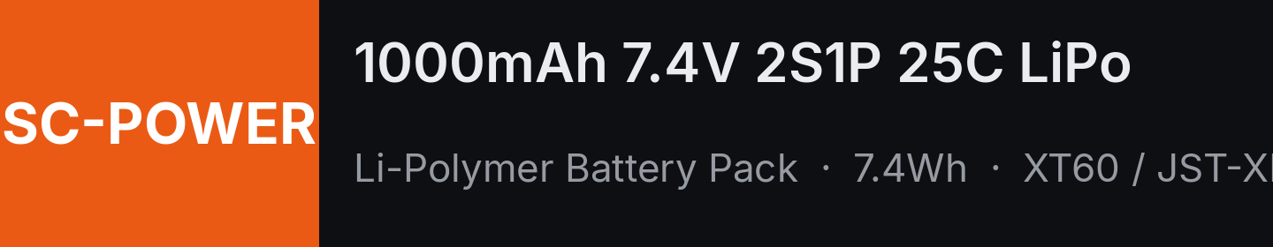
video/assembly/assets/lipo_side.png
