KVR-CIBER/sc02-solar-hypercar/video/stills/sc02_assemblage_24s.jpg

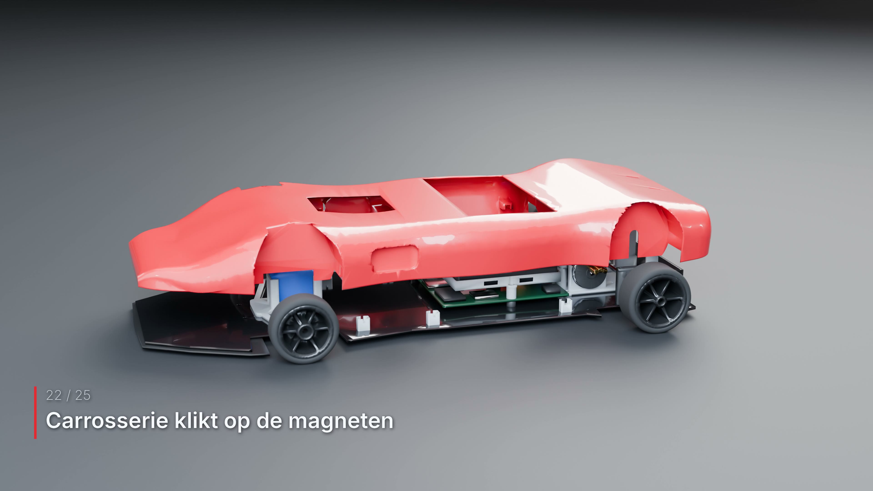
video/stills/sc02_assemblage_24s.jpg
