KVR-CIBER/sc02-solar-hypercar/f1/pcb/sc02_drive.kicad_pcb

## KiCad design f1/pcb/sc02_drive.kicad_pcb (2026-10-21)

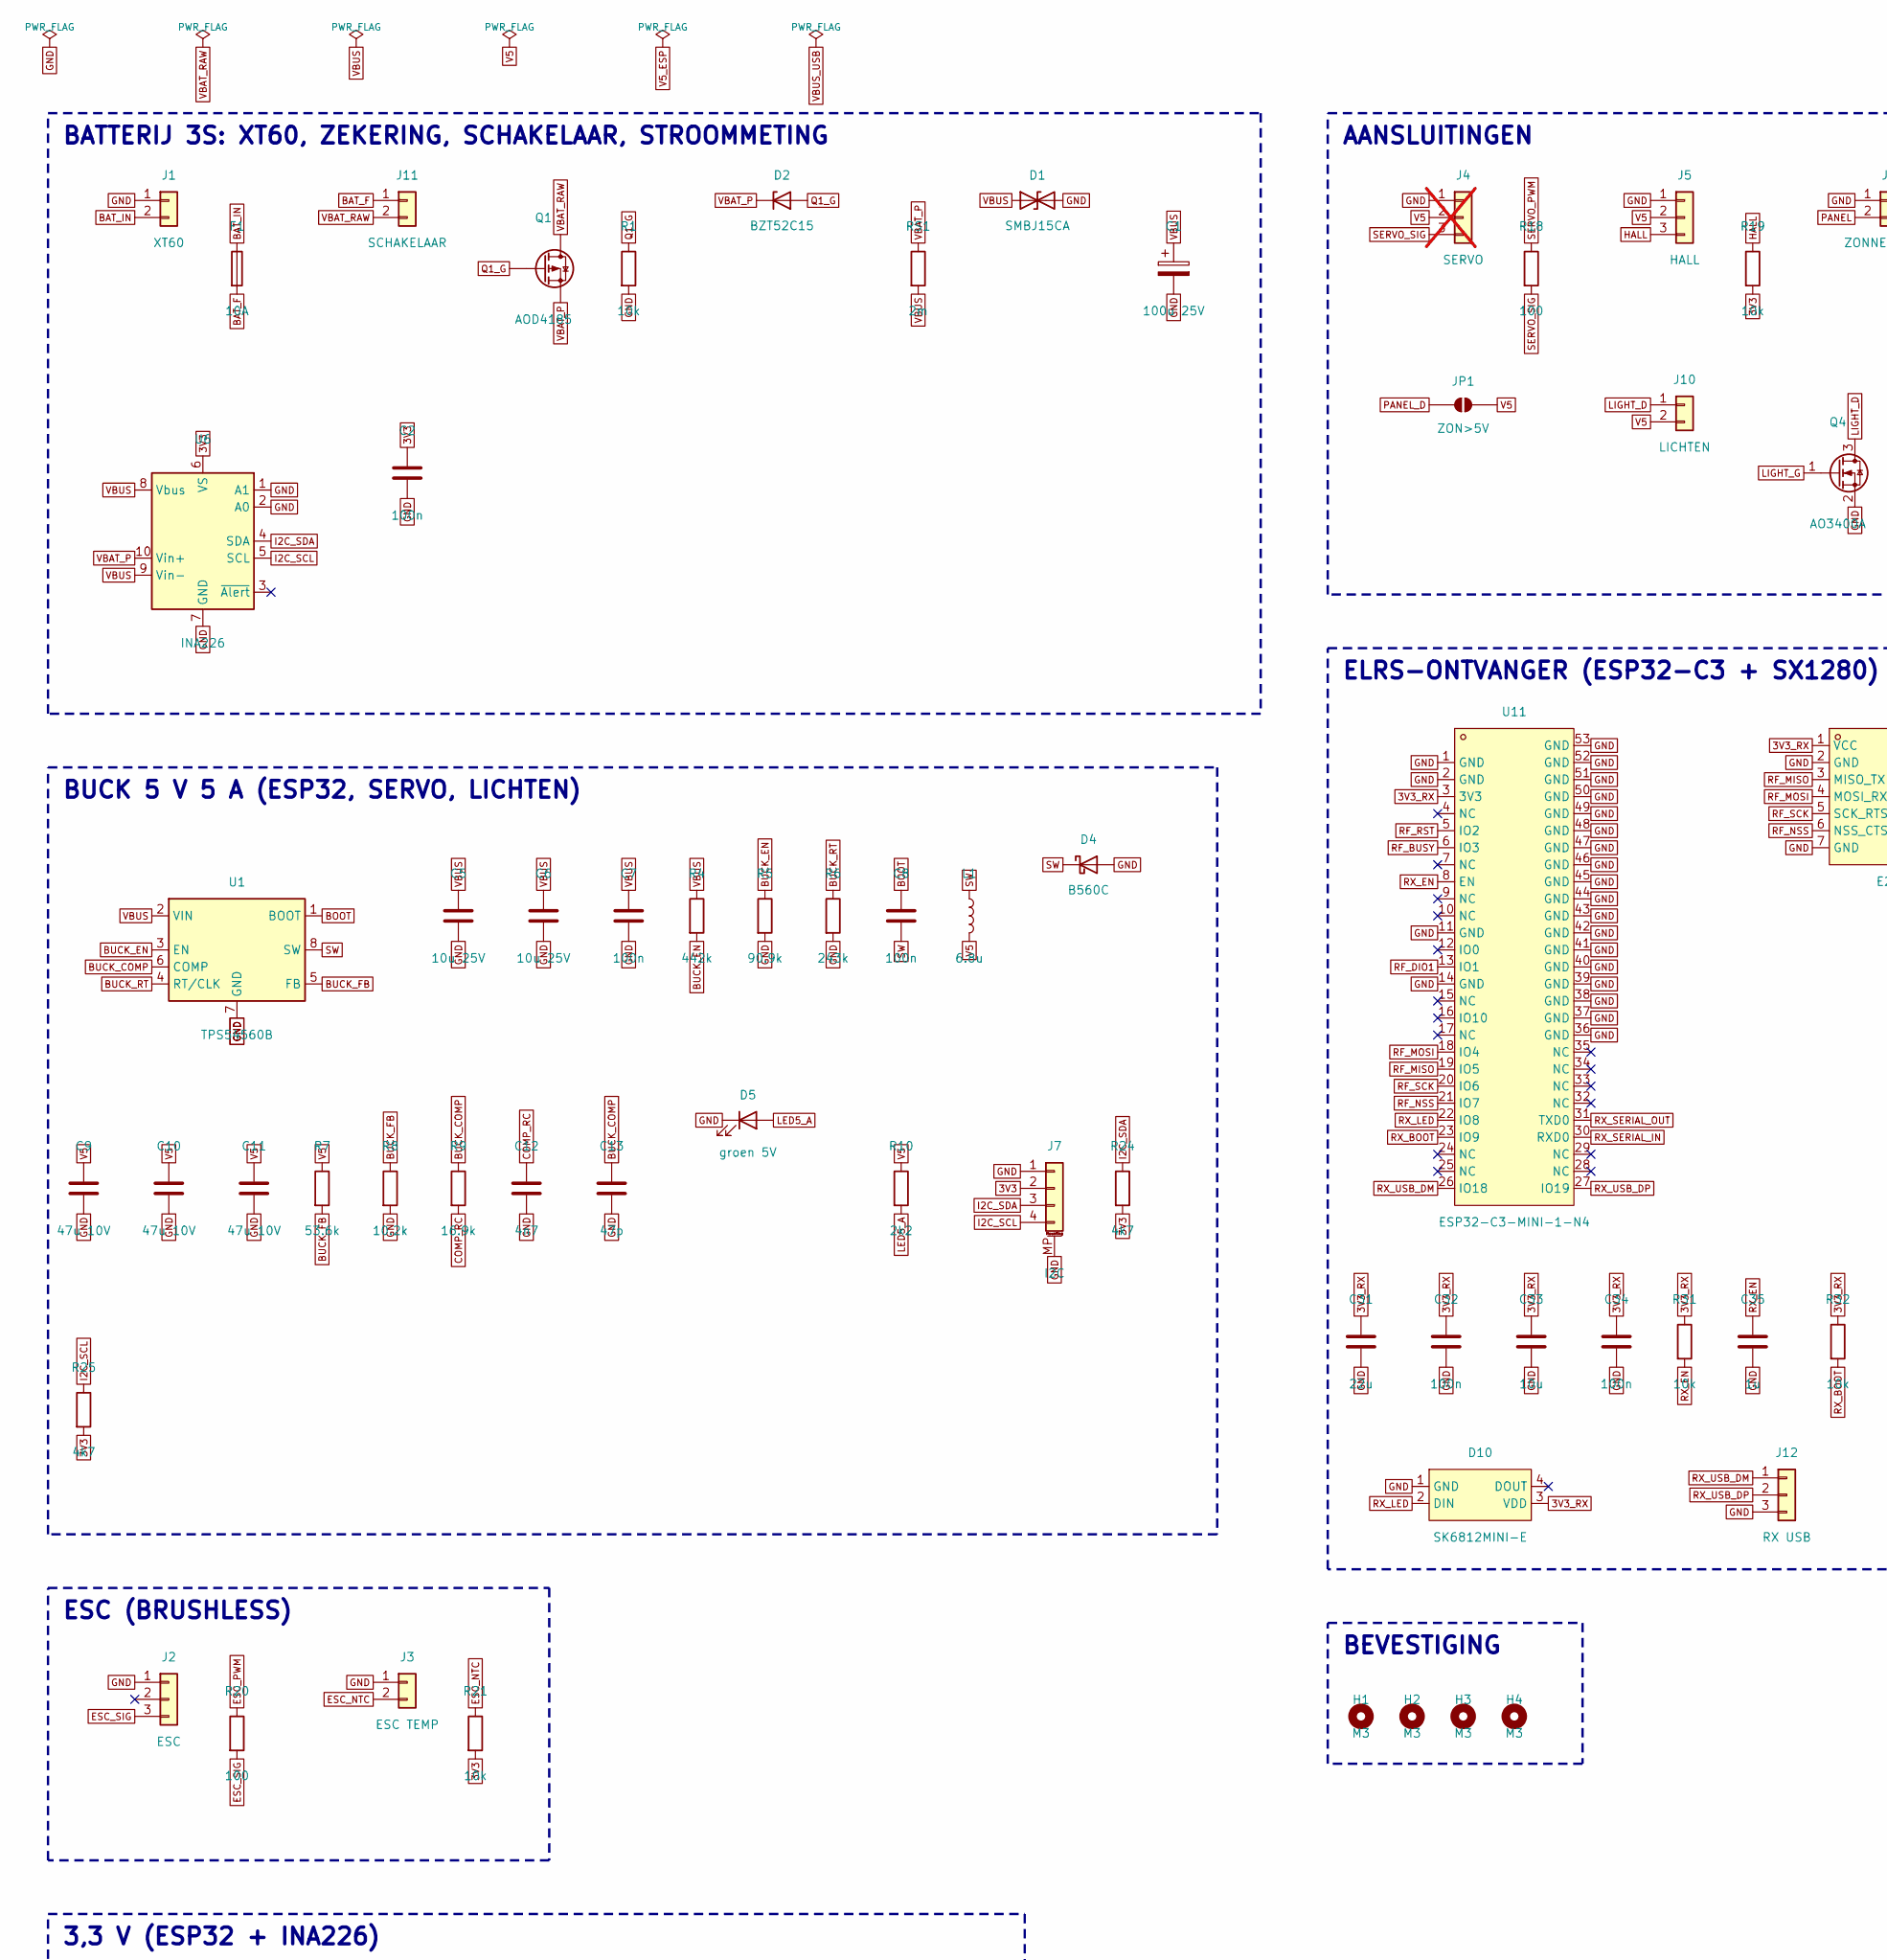
[picture p126: schematic sc02_drive.kicad_sch, SC-02 floor board, part in row 1, column 1]

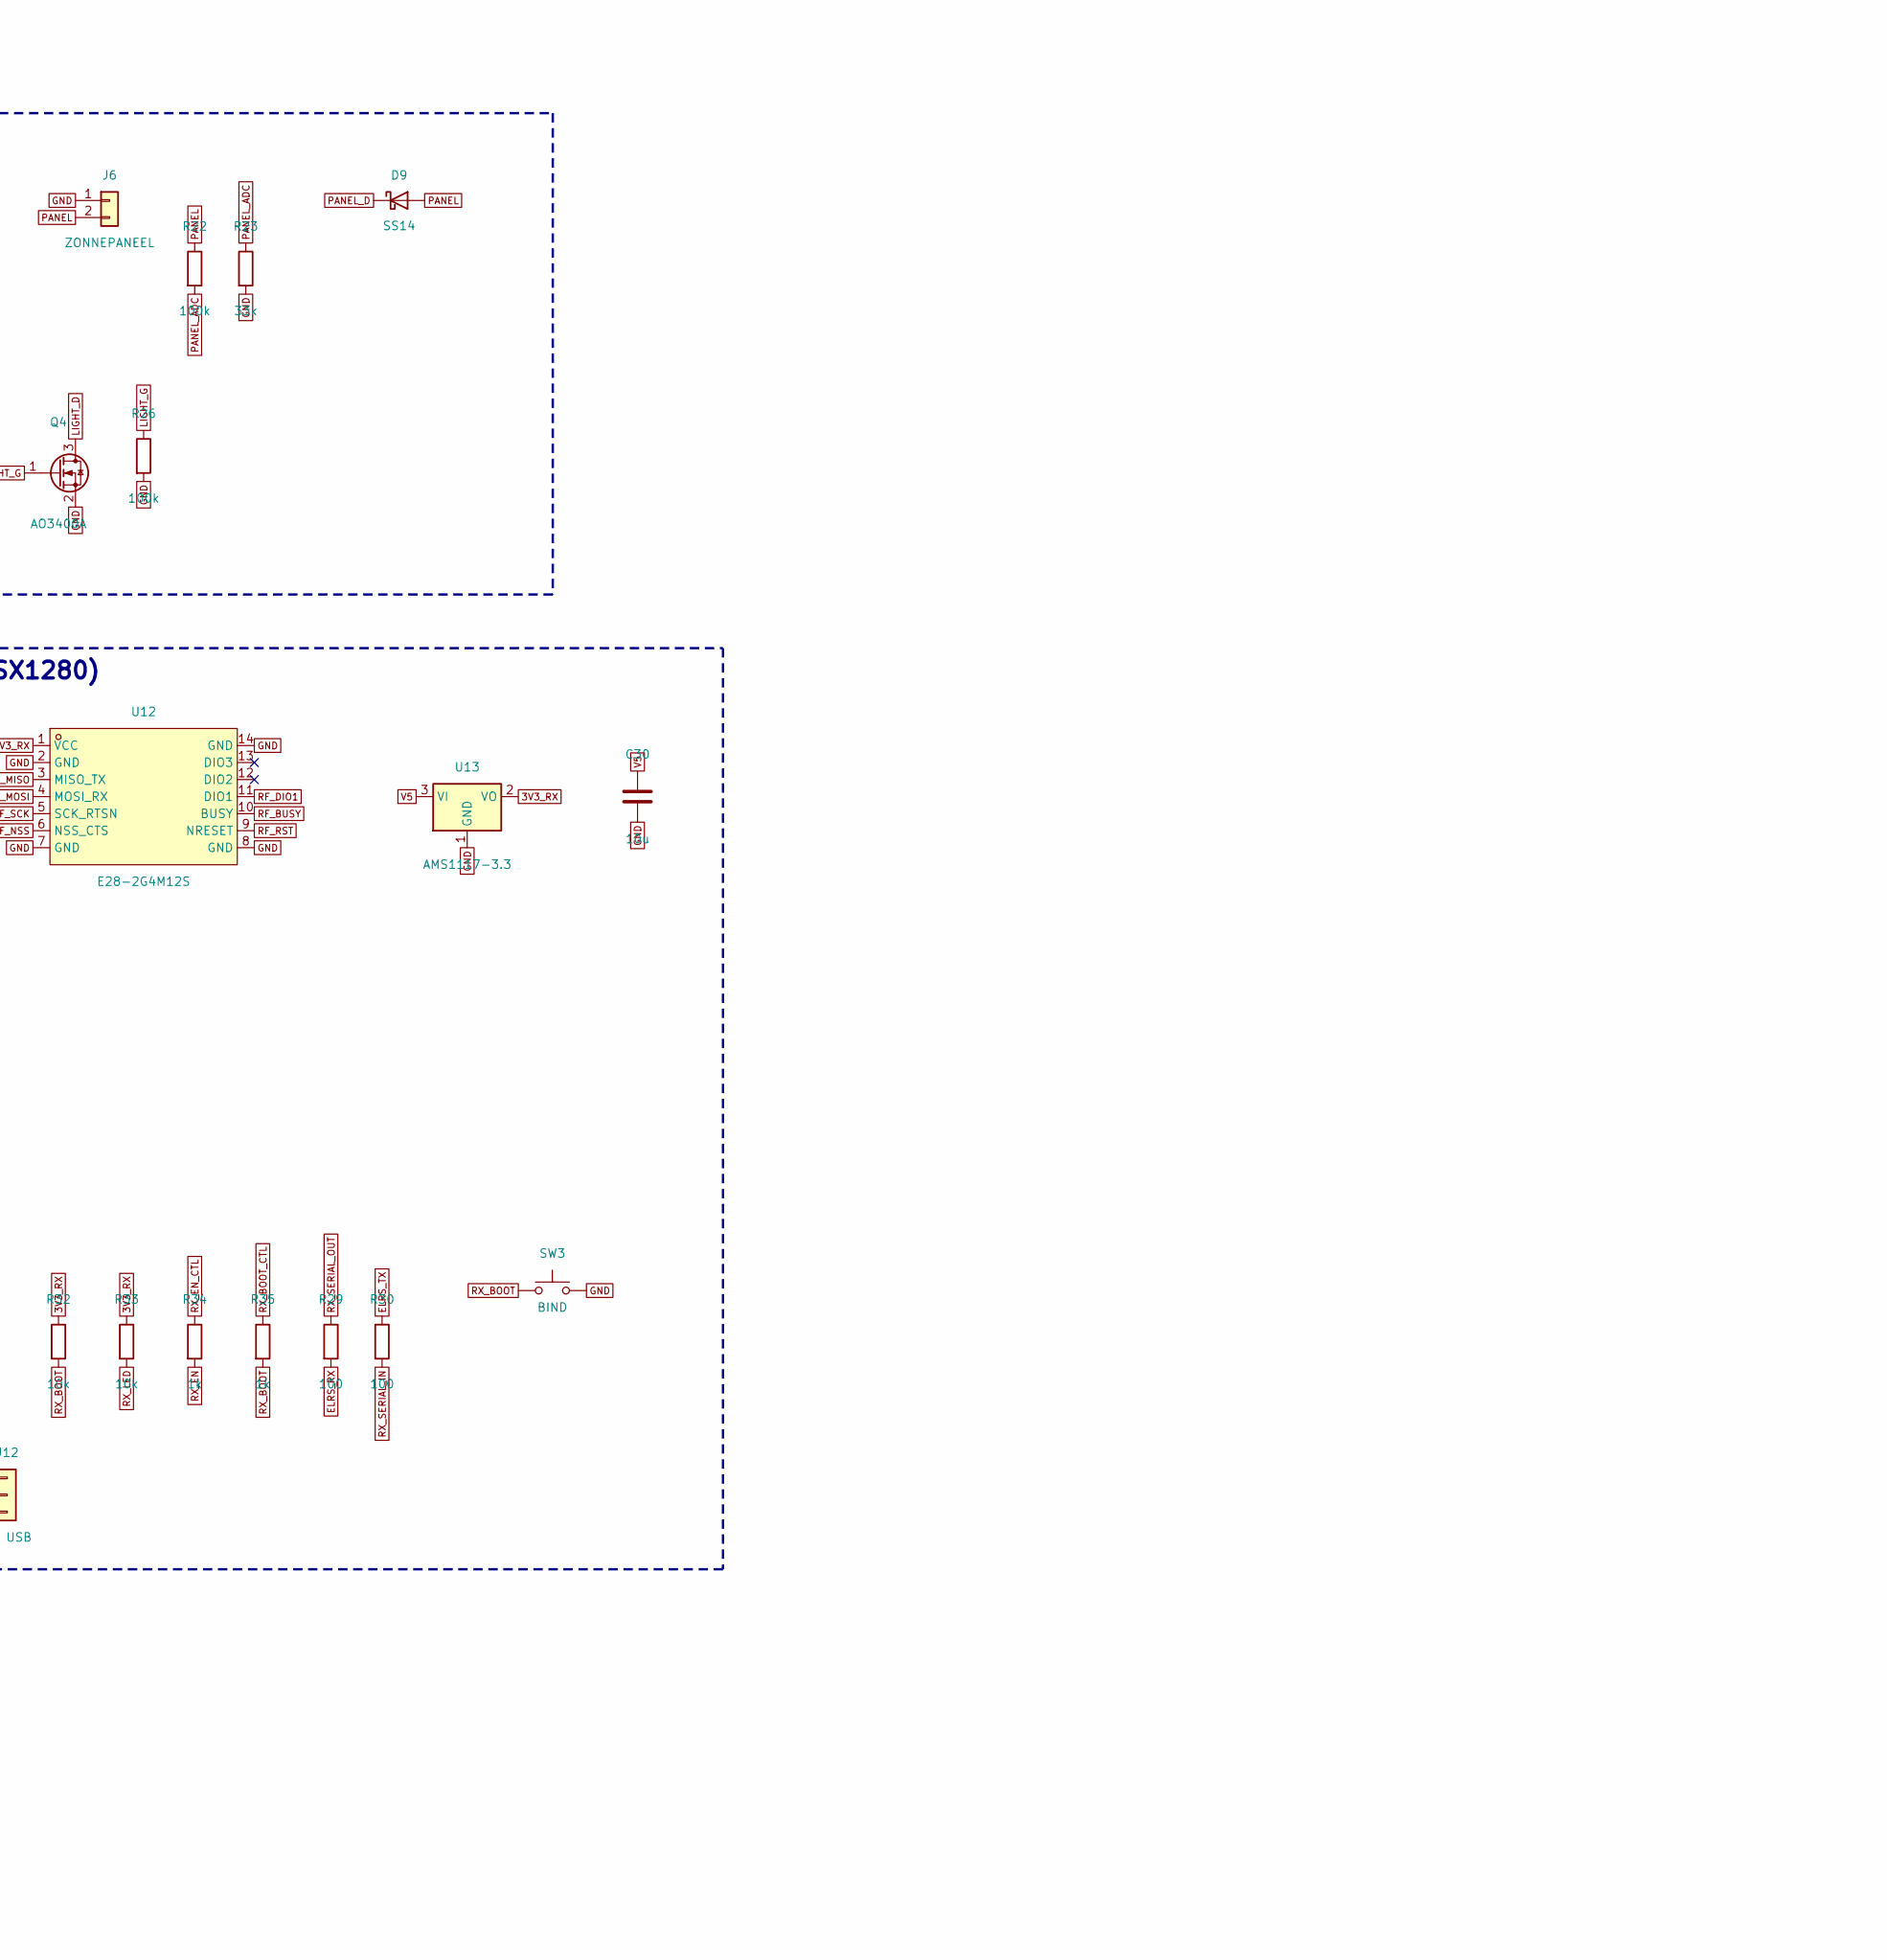
[picture p127: schematic sc02_drive.kicad_sch, SC-02 floor board, part in row 1, column 2]

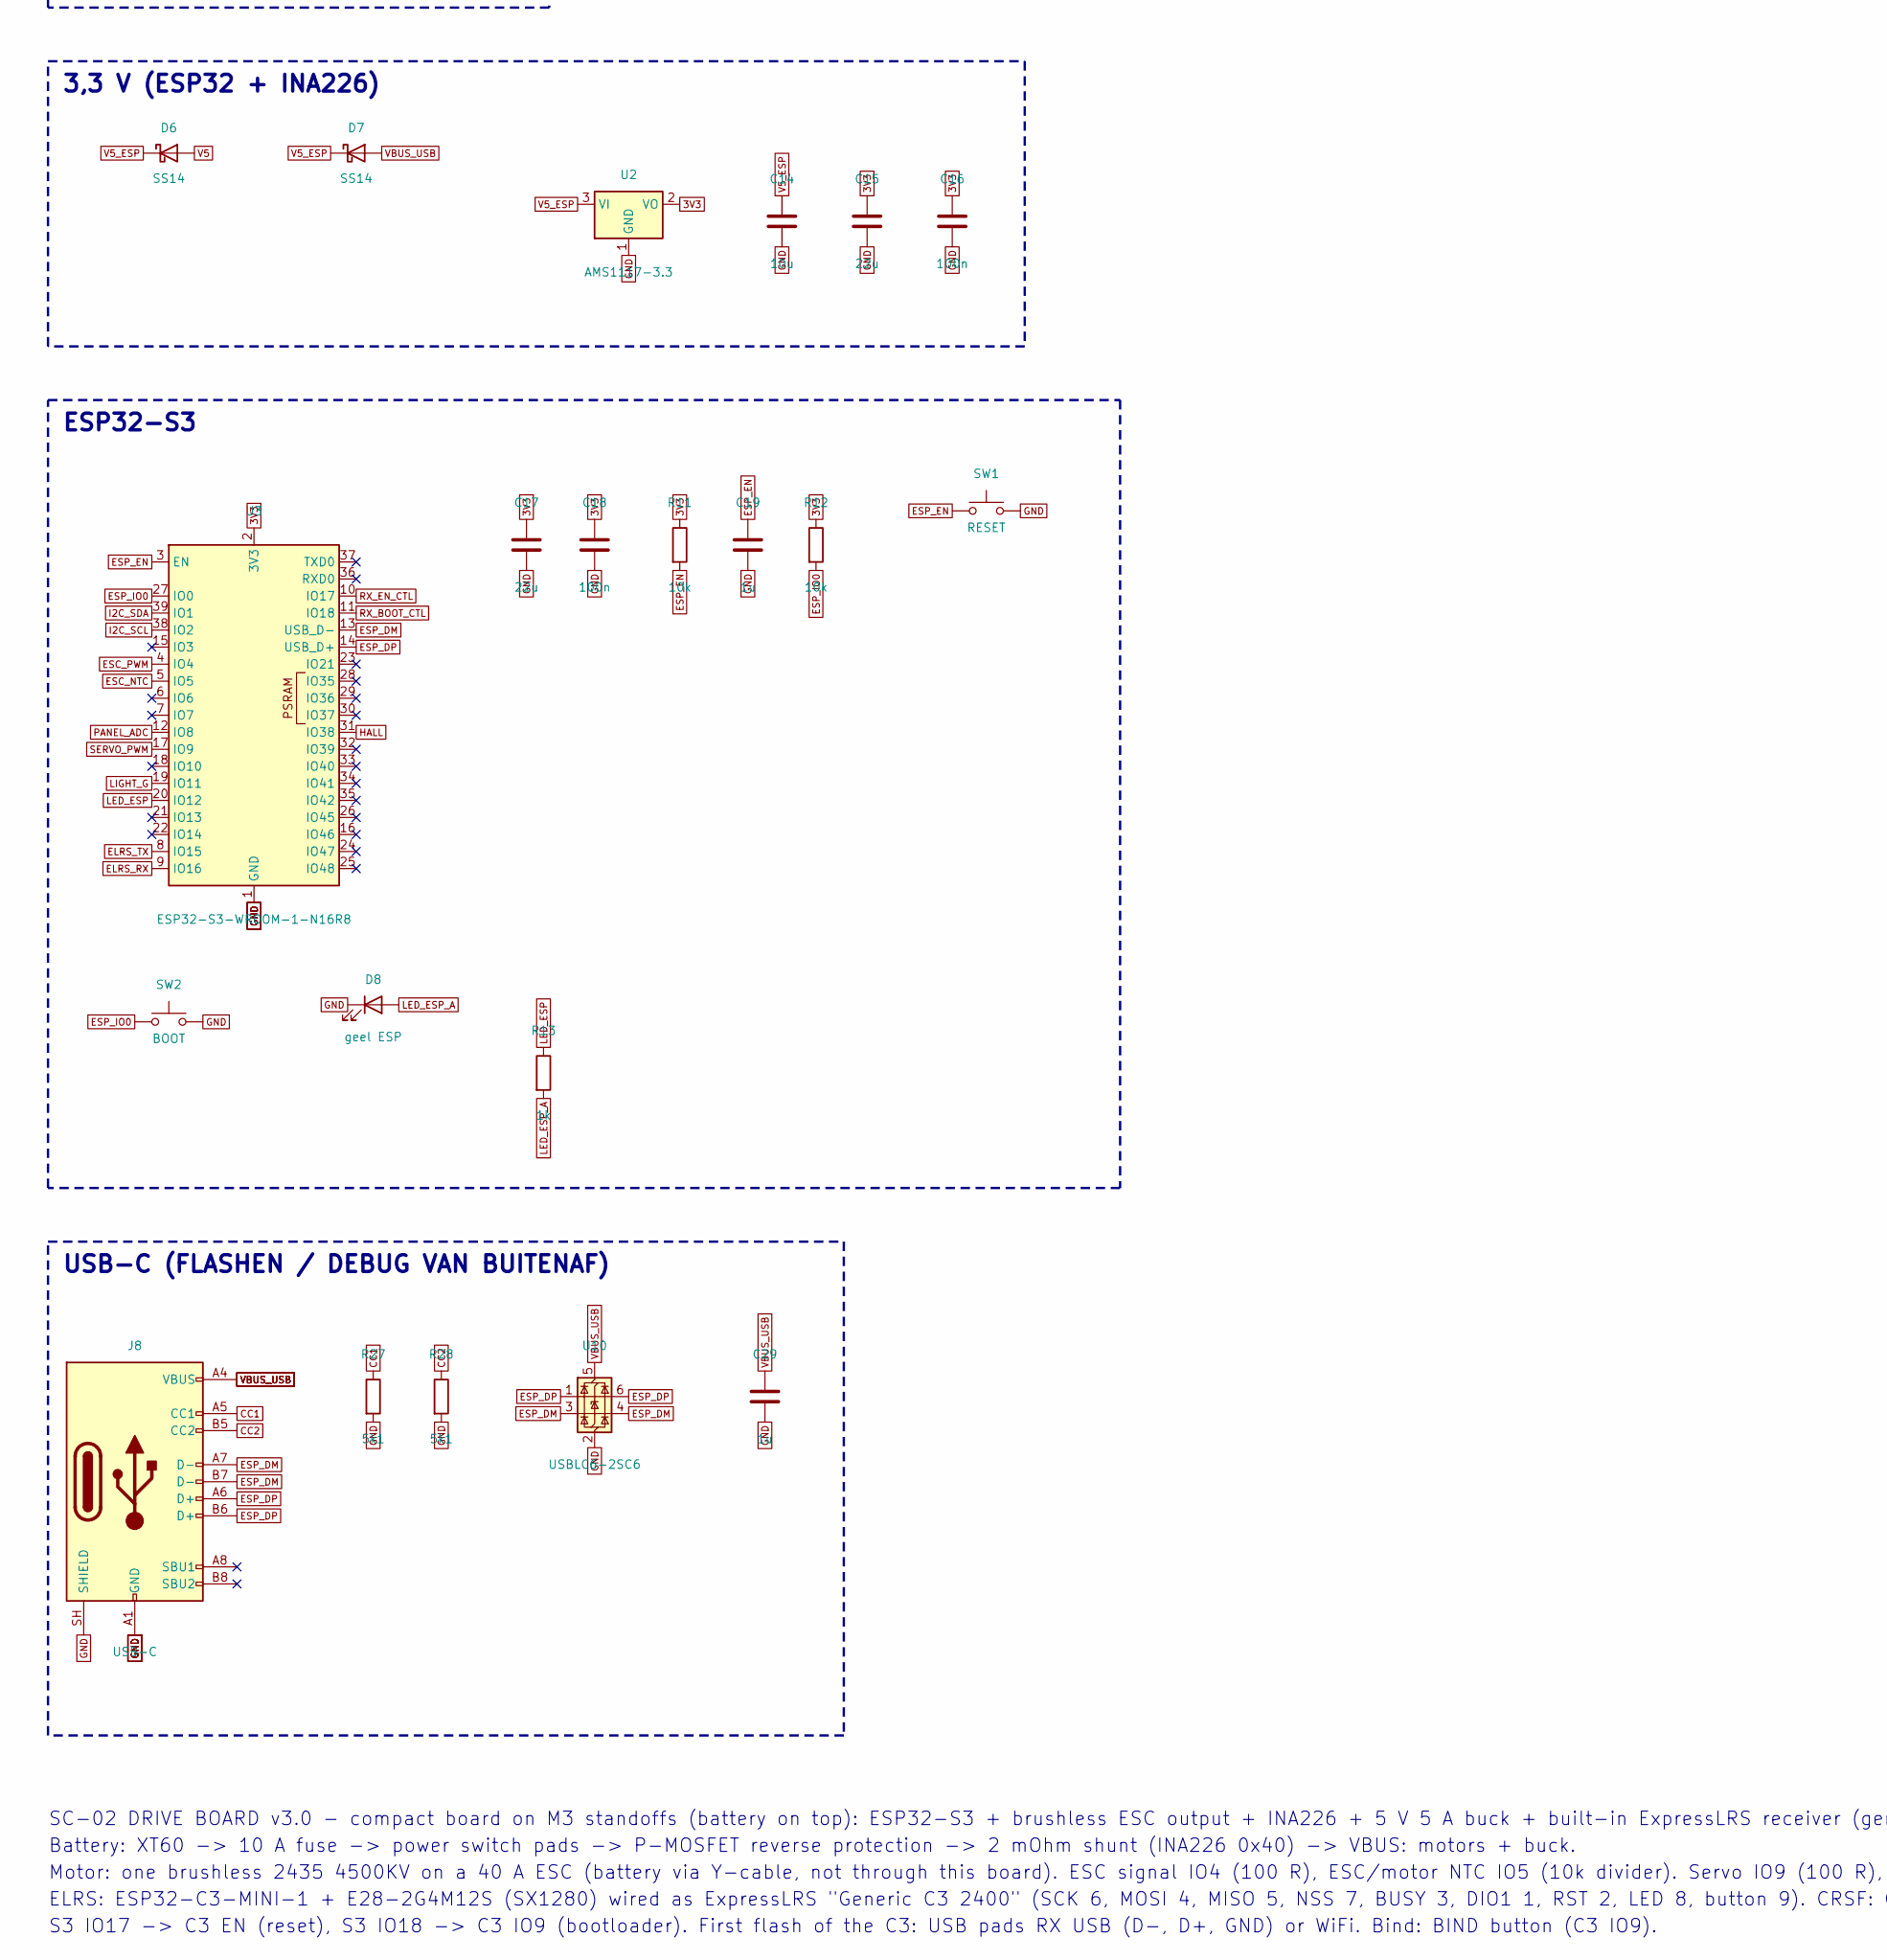
[picture p128: schematic sc02_drive.kicad_sch, SC-02 floor board, part in row 2, column 1]

Parts:
C1: 100u 25V; CP_Elec_6.3x7.7; MPN 100uF 25V 6.3x7.7 alu
C2, C7, C8, C16, C18, C32, C34: 100n; C_0603_1608Metric; MPN 0603 100n X7R ceramic
C5, C6: 10u 25V; C_1206_3216Metric; MPN 1206 10u 25V X5R ceramic
C9, C10, C11: 47u 10V; C_1210_3225Metric; MPN 1210 47u 10V X5R ceramic
C12: 4n7; C_0603_1608Metric; MPN 0603 4n7 X5R ceramic
C13: 47p; C_0603_1608Metric; MPN 0603 47p X7R ceramic
C14, C30, C33: 10u; C_0805_2012Metric; MPN 0805 10u X5R ceramic
C15, C17, C31: 22u; C_0805_2012Metric; MPN 0805 22u X5R ceramic
C19, C29, C35: 1u; C_0603_1608Metric; MPN 0603 1u X5R ceramic
D1: SMBJ15CA; D_SMB; MPN SMBJ15CA
D2: BZT52C15; D_SOD-123; MPN BZT52C15 (gate clamp)
D4: B560C; D_SMC; MPN B560C (5 A 60 V Schottky)
D5: groen 5V; LED_0603_1608Metric; MPN LED 0603 green
D6, D7: SS14; D_SMA; MPN SS14
D8: geel ESP; LED_0603_1608Metric; MPN LED 0603 yellow
D9: SS14; D_SMA; MPN SS14 (solar -> 5 V)
D10: SK6812MINI-E; LED-SMD_4P-L3.2-W2.8-LS5.9_SK6812MINI-E; MPN SK6812MINI-E (ELRS status LED, RGB)
F1: 10A; R_2512_6332Metric; MPN 2410FA-10A (fast 10 A, 2410 body on 251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
H1, H2, H3, H4: M3; Hole_3.2mm
J1: XT60; AMASS_XT60-M_1x02_P7.20mm_Vertical; MPN AMASS XT60-M (male, vertical): the LiPo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
J2: ESC; PinHeader_1x03_P2.54mm_Vertical; MPN 1x3 pin header 2.54 (ESC signal lead: b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
J3: ESC TEMP; SolderWire_2pad_P5mm_M; MPN solder pads: 10k NTC glued on the ESC /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
J4: SERVO; PinHeader_1x03_P2.54mm_Vertical; MPN NOT FITTED: solder the MG90S lead strai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; not fitted
J5: HALL; PinHeader_1x03_P2.54mm_Vertical; MPN 1x3 pin header 2.54 (A3144: GND, 5 V, o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
J6: ZONNEPANEEL; JST_XH_B2B-XH-A_1x02_P2.50mm_Vertical; MPN JST XH 2-pin (B2B-XH-A): plug the solar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
J7: I2C; JST_SH_SM04B-SRSS-TB_1x04-1MP_P1.00mm_Horizontal; MPN JST SM04B-SRSS-TB (Qwiic / STEMMA QT)
J8: USB-C; USB_C_Receptacle_HRO_TYPE-C-31-M-12; MPN HRO TYPE-C-31-M-12 (board edge)
J10: LICHTEN; SolderWire_2pad_P4mm_S; MPN solder pads, LED lights 5 V (with their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
J11: SCHAKELAAR; SolderWire_2pad_P5mm_SW; MPN solder pads for the power switch (mount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
J12: RX USB; Pads_RX_USB; MPN test pads: USB D-/D+/GND of the receive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
JP1: ZON>5V; SolderJumper-2_P1.3mm_Open_RoundedPad1.0x1.5mm; MPN solder jumper (open): solar panel feeds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
L1: 6.8u; L_Bourns_SRP1038C_10.0x10.0mm; MPN Bourns SRP1038C-6R8M (6.8 uH, >= 8 A)
Q1: AOD4185; TO-252-2; MPN AOD4185 (P-MOSFET 40 V 40 A, reverse po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
Q4: AO3400A; SOT-23; MPN AO3400A
R1, R11, R12, R19, R31, R32: 10k; R_0603_1608Metric; MPN 0603 10k 1%
R4: 442k; R_0603_1608Metric; MPN 0603 442k 1%
R5: 90.9k; R_0603_1608Metric; MPN 0603 90.9k 1%
R6: 243k; R_0603_1608Metric; MPN 0603 243k 1%
R7: 53.6k; R_0603_1608Metric; MPN 0603 53.6k 1%
R8: 10.2k; R_0603_1608Metric; MPN 0603 10.2k 1%
R9: 16.9k; R_0603_1608Metric; MPN 0603 16.9k 1%
R10: 2k2; R_0603_1608Metric; MPN 0603 2k2 1%
R13: 1k; R_0603_1608Metric; MPN 0603 1k 1%
R18, R20, R29, R30: 100; R_0603_1608Metric; MPN 0603 100 1%
R21: 10k; R_0603_1608Metric; MPN 0603 10k 1% (NTC divider)
R22, R26: 100k; R_0603_1608Metric; MPN 0603 100k 1%
R23: 33k; R_0603_1608Metric; MPN 0603 33k 1%
R24, R25: 4k7; R_0603_1608Metric; MPN 0603 4k7 1%
R27, R28: 5k1; R_0603_1608Metric; MPN 0603 5k1 1%
R33: 10k; R_0603_1608Metric; MPN 0603 10k (IO8 strapping pin high at boo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
R34: 1k; R_0603_1608Metric; MPN 0603 1k (S3 can reset the receiver)
R35: 1k; R_0603_1608Metric; MPN 0603 1k (S3 can start the receiver boot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
RS1: 2m; R_2512_6332Metric; MPN 2512 2 mOhm 2 W current shunt
SW1: RESET; SW_Push_1P1T_NO_CK_KMR2; MPN CK KMR221G (4.2x2.8 tact)
SW2: BOOT; SW_Push_1P1T_NO_CK_KMR2; MPN CK KMR221G (4.2x2.8 tact) - also the ra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
SW3: BIND; SW_Push_1P1T_NO_CK_KMR2; MPN CK KMR221G: ELRS bind / bootloader butt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
U1: TPS54560B; Texas_R-PDSO-G8_EP2.95x4.9mm_Mask2.4x3.1mm_ThermalVias; MPN TPS54560BDDAR
U2: AMS1117-3.3; SOT-223-3_TabPin2; MPN AMS1117-3.3
U3: ESP32-S3-WROOM-1-N16R8; ESP32-S3-WROOM-1; MPN ESP32-S3-WROOM-1-N16R8
U6: INA226; TSSOP-10_3x3mm_P0.5mm; MPN INA226AIDGSR (0x40)
U10: USBLC6-2SC6; SOT-23-6; MPN USBLC6-2SC6
U11: ESP32-C3-MINI-1-N4; WIFIM-SMD_ESP32-C3-MINI-1; MPN ESP32-C3-MINI-1-N4 (ELRS receiver MCU, 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
U12: E28-2G4M12S; WIRELM-SMD_E28-2G4M12S; MPN Ebyte E28-2G4M12S (SX1280 2.4 GHz, 12.5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
U13: AMS1117-3.3; SOT-223-3_TabPin2; MPN AMS1117-3.3 (receiver supply)

Connections:
3V3: C2.1, C15.1, C16.1, C17.1, C18.1, J7.2, R11.1, R12.1, R19.2, R21.2, R24.2, R25.2, U2.2 (VO), U3.2 (3V3), U6.6 (VS)
3V3_RX: C31.1, C32.1, C33.1, C34.1, D10.3 (VDD), R31.1, R32.1, R33.1, U11.3 (3V3), U12.1 (VCC), U13.2 (VO)
BAT_F: F1.2, J11.1
BAT_IN: F1.1, J1.2
BOOT: C8.1, U1.1 (BOOT)
BUCK_COMP: C13.1, R9.1, U1.6 (COMP)
BUCK_EN: R4.2, R5.1, U1.3 (EN)
BUCK_FB: R7.2, R8.1, U1.5 (FB)
BUCK_RT: R6.1, U1.4 (RT/CLK)
CC1: J8.A5 (CC1), R27.1
CC2: J8.B5 (CC2), R28.1
COMP_RC: C12.1, R9.2
ELRS_RX: R29.2, U3.9 (IO16)
ELRS_TX: R30.1, U3.8 (IO15)
ESC_NTC: J3.2, R21.1, U3.5 (IO5)
ESC_PWM: R20.1, U3.4 (IO4)
ESC_SIG: J2.3, R20.2
ESP_DM: J8.A7 (D-), J8.B7 (D-), U3.13 (USB_D-), U10.3 (I/O2), U10.4 (I/O2)
ESP_DP: J8.A6 (D+), J8.B6 (D+), U3.14 (USB_D+), U10.1 (I/O1), U10.6 (I/O1)
ESP_EN: C19.1, R11.2, SW1.1, U3.3 (EN)
ESP_IO0: R12.2, SW2.1, U3.27 (IO0)
GND: C1.2, C2.2, C5.2, C6.2, C7.2, C9.2, C10.2, C11.2, C12.2, C13.2, C14.2, C15.2, C16.2, C17.2, C18.2, C19.2, C29.2, C30.2, C31.2, C32.2, C33.2, C34.2, C35.2, D1.2 (A2), D4.2 (A), D5.1 (K), D8.1 (K), D10.1 (GND), J1.1, J2.1, J3.1, J4.1, J5.1, J6.1, J7.1, J7.MP (MountPin), J8.A1 (GND), J8.A12 (GND), J8.B1 (GND), J8.B12 (GND), J8.SH (SHIELD), J12.3, Q4.2 (S), R1.2, R5.2, R6.2, R8.2, R23.2, R26.2, R27.2, R28.2, SW1.2, SW2.2, SW3.2, U1.7 (GND), U1.9 (GND), U2.1 (GND), U3.1 (GND), U3.40 (GND), U3.41 (GND), U6.1 (A1), U6.2 (A0), U6.7 (GND), U10.2 (GND), U11.1 (GND), U11.2 (GND), U11.11 (GND), U11.14 (GND), U11.36 (GND), U11.37 (GND), U11.38 (GND), U11.39 (GND), U11.40 (GND), U11.41 (GND), U11.42 (GND), U11.43 (GND), U11.44 (GND), U11.45 (GND), U11.46 (GND), U11.47 (GND), U11.48 (GND), U11.49 (GND), U11.50 (GND), U11.51 (GND), U11.52 (GND), U11.53 (GND), U12.2 (GND), U12.7 (GND), U12.8 (GND), U12.14 (GND), U13.1 (GND)
HALL: J5.3, R19.1, U3.31 (IO38)
I2C_SCL: J7.4, R25.1, U3.38 (IO2), U6.5 (SCL)
I2C_SDA: J7.3, R24.1, U3.39 (IO1), U6.4 (SDA)
LED5_A: D5.2 (A), R10.2
LED_ESP: R13.1, U3.20 (IO12)
LED_ESP_A: D8.2 (A), R13.2
LIGHT_D: J10.1, Q4.3 (D)
LIGHT_G: Q4.1 (G), R26.1, U3.19 (IO11)
PANEL: D9.2 (A), J6.2, R22.1
PANEL_ADC: R22.2, R23.1, U3.12 (IO8)
PANEL_D: D9.1 (K), JP1.1 (A)
Q1_G: D2.2 (A), Q1.1 (G), R1.1
RF_BUSY: U11.6 (IO3), U12.10 (BUSY)
RF_DIO1: U11.13 (IO1), U12.11 (DIO1)
RF_MISO: U11.19 (IO5), U12.3 (MISO_TX)
RF_MOSI: U11.18 (IO4), U12.4 (MOSI_RX)
RF_NSS: U11.21 (IO7), U12.6 (NSS_CTS)
RF_RST: U11.5 (IO2), U12.9 (NRESET)
RF_SCK: U11.20 (IO6), U12.5 (SCK_RTSN)
RX_BOOT: R32.2, R35.2, SW3.1, U11.23 (IO9)
RX_BOOT_CTL: R35.1, U3.11 (IO18)
RX_EN: C35.1, R31.2, R34.2, U11.8 (EN)
RX_EN_CTL: R34.1, U3.10 (IO17)
RX_LED: D10.2 (DIN), R33.2, U11.22 (IO8)
RX_SERIAL_IN: R30.2, U11.30 (RXD0)
RX_SERIAL_OUT: R29.1, U11.31 (TXD0)
RX_USB_DM: J12.1, U11.26 (IO18)
RX_USB_DP: J12.2, U11.27 (IO19)
SERVO_PWM: R18.1, U3.17 (IO9)
SERVO_SIG: J4.3, R18.2
SW: C8.2, D4.1 (K), L1.1, U1.8 (SW)
V5: C9.1, C10.1, C11.1, C30.1, D6.2 (A), J4.2, J5.2, J10.2, JP1.2 (B), L1.2, R7.1, R10.1, U13.3 (VI)
V5_ESP: C14.1, D6.1 (K), D7.1 (K), U2.3 (VI)
VBAT_P: D2.1 (K), Q1.3 (S), RS1.1, U6.10 (Vin+)
VBAT_RAW: J11.2, Q1.2 (D)
VBUS: C1.1, C5.1, C6.1, C7.1, D1.1 (A1), R4.1, RS1.2, U1.2 (VIN), U6.8 (Vbus), U6.9 (Vin-)
VBUS_USB: C29.1, D7.2 (A), J8.A4 (VBUS), J8.A9 (VBUS), J8.B4 (VBUS), J8.B9 (VBUS), U10.5 (VBUS)

Notes on the sheet:
BATTERIJ 3S: XT60, ZEKERING, SCHAKELAAR, STROOMMETING
BUCK 5 V 5 A (ESP32, SERVO, LICHTEN)
ESC (BRUSHLESS)
3,3 V (ESP32 + INA226)
ESP32-S3
USB-C (FLASHEN / DEBUG VAN BUITENAF)
AANSLUITINGEN
ELRS-ONTVANGER (ESP32-C3 + SX1280)
BEVESTIGING
SC-02 DRIVE BOARD v3.0 - compact board on M3 standoffs (battery on top): ESP32-S3 + brushless ESC output + INA226 + 5 V 5 A buck + built-in ExpressLRS receiver (generated by tools/build_sch.py from tools/design.py)
Battery: XT60 -> 10 A fuse -> power switch pads -> P-MOSFET reverse protection -> 2 mOhm shunt (INA226 0x40) -> VBUS: motors + buck.
Motor: one brushless 2435 4500KV on a 40 A ESC (battery via Y-cable, not through this board). ESC signal IO4 (100 R), ESC/motor NTC IO5 (10k divider). Servo IO9 (100 R), hall IO38 (10k pull-up), lights IO11 (AO3400A), solar panel JST-XH, ADC IO8 (100k/33k), JP1 = panel -> 5 V.
ELRS: ESP32-C3-MINI-1 + E28-2G4M12S (SX1280) wired as ExpressLRS "Generic C3 2400" (SCK 6, MOSI 4, MISO 5, NSS 7, BUSY 3, DIO1 1, RST 2, LED 8, button 9). CRSF: C3 TX21 -> S3 IO16, S3 IO15 -> C3 RX20.
S3 IO17 -> C3 EN (reset), S3 IO18 -> C3 IO9 (bootloader). First flash of the C3: USB pads RX USB (D-, D+, GND) or WiFi. Bind: BIND button (C3 IO9).

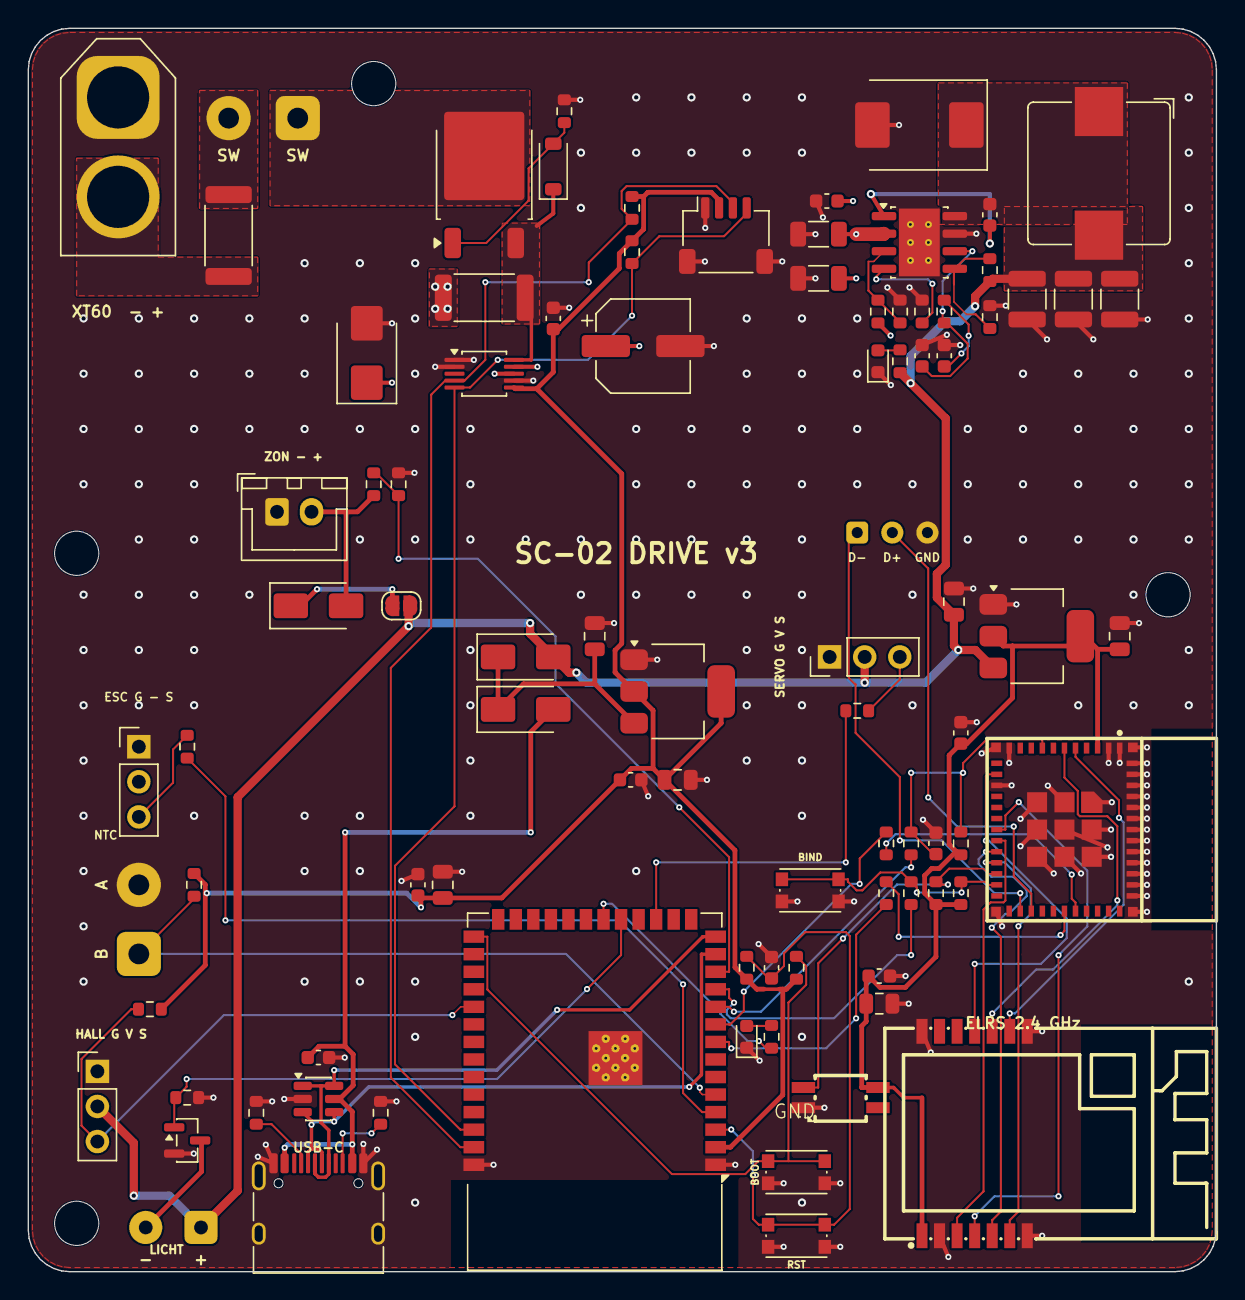
[picture p129: board sc02_drive.kicad_pcb from above]

Board: 4 copper layers, 86.0 x 90.0 mm, 94 parts (0 on the bottom side), 59 nets.
