KVR-CIBER/sc02-solar-hypercar/f1/pcb/tools/libs.py

import sys
"""Build the self-contained project libraries: sc02.kicad_sym and sc02.pretty."""
import os, re, json, shutil, copy
import symlib
from sexp import parse, dump, find, find1, Sym
import design

HERE = os.path.dirname(os.path.abspath(__file__))
PRJ = os.path.dirname(HERE)
FPDIR = '/Applications/KiCad/KiCad.app/Contents/SharedSupport/footprints/'
LIB = 'sc02'


def fp_name(fpid):
    return fpid.split(':')[1]


def sym_name(symid):
    lib, name = symid.split(':')
    return name


# ---------------------------------------------------------------- custom footprints
def fp_text(name, body, descr, attr='through_hole'):
    return f'''(footprint "{name}"
\t(version 20241229)
\t(generator "arachne_gen")
\t(layer "F.Cu")
\t(descr "{descr}")
\t(property "Reference" "REF**" (at 0 -4 0) (layer "F.SilkS") (effects (font (size 1 1) (thickness 0.15))))
\t(property "Value" "{name}" (at 0 4 0) (layer "F.Fab") (effects (font (size 1 1) (thickness 0.15))))
\t(attr {attr})
{body})
'''


def molex_5268():
    b = ''
    for i, n in enumerate((1, 2, 3)):
        shape = 'roundrect (roundrect_rratio 0.15)' if n == 1 else 'oval'
        b += f'\t(pad "{n}" thru_hole {shape} (at {i*2.5} 0) (size 1.7 2.1) (drill 1.0) (layers "*.Cu" "*.Mask"))\n'
    b += '\t(fp_rect (start -2.45 -2.35) (end 7.45 2.55) (stroke (width 0.12) (type solid)) (fill no) (layer "F.SilkS"))\n'
    b += '\t(fp_line (start -2.45 1.6) (end 7.45 1.6) (stroke (width 0.12) (type solid)) (layer "F.SilkS"))\n'
    b += '\t(fp_rect (start -2.7 -2.6) (end 7.7 2.8) (stroke (width 0.05) (type solid)) (fill no) (layer "F.CrtYd"))\n'
    b += '\t(fp_rect (start -2.35 -2.25) (end 7.35 2.45) (stroke (width 0.1) (type solid)) (fill no) (layer "F.Fab"))\n'
    for i, t in enumerate('GVS'):
        b += f'\t(fp_text user "{t}" (at {i*2.5} -3.3 0) (layer "F.SilkS") (effects (font (size 0.8 0.8) (thickness 0.15))))\n'
    b += ('\t(model "${KICAD10_3DMODEL_DIR}/Connector_JST.3dshapes/JST_XH_B3B-XH-A_1x03_P2.50mm_Vertical.step"'
          ' (offset (xyz 0 0 0)) (scale (xyz 1 1 1)) (rotate (xyz 0 0 0)))\n')
    return fp_text('Molex_5268-03A_1x03_P2.50mm_Vertical', b,
                   'Molex 5268-03A header, mates with 5264 housing used on Feetech STS bus servos (2.50 mm)')


def solder_pads():
    b = ''
    b += '\t(pad "1" thru_hole circle (at 0 0) (size 4.6 4.6) (drill 2.2) (layers "*.Cu" "*.Mask"))\n'
    b += '\t(pad "2" thru_hole roundrect (roundrect_rratio 0.2) (at 7 0) (size 4.6 4.6) (drill 2.2) (layers "*.Cu" "*.Mask"))\n'
    b += '\t(fp_text user "GND" (at 0 3.6 0) (layer "F.SilkS") (effects (font (size 1.1 1.1) (thickness 0.2))))\n'
    b += '\t(fp_text user "+12V" (at 7 3.6 0) (layer "F.SilkS") (effects (font (size 1.1 1.1) (thickness 0.2))))\n'
    b += '\t(fp_rect (start -3 -3) (end 10 4.8) (stroke (width 0.05) (type solid)) (fill no) (layer "F.CrtYd"))\n'
    return fp_text('SolderWire_2pad_P7mm_D2.2mm', b, 'Two big solder pads for the 12 V battery leads (14-16 AWG)')


def mount_hole():
    b = '\t(pad "" np_thru_hole circle (at 0 0) (size 4.2 4.2) (drill 4.2) (layers "*.Cu" "*.Mask"))\n'
    b += '\t(fp_circle (center 0 0) (end 3.4 0) (stroke (width 0.15) (type solid)) (fill no) (layer "F.SilkS"))\n'
    b += '\t(fp_circle (center 0 0) (end 3.4 0) (stroke (width 0.15) (type solid)) (fill no) (layer "B.SilkS"))\n'
    b += '\t(fp_circle (center 0 0) (end 3.7 0) (stroke (width 0.05) (type solid)) (fill no) (layer "F.CrtYd"))\n'
    return fp_text('MountingHole_4.2mm_M3_loose', b, 'M3 hole with 0.6 mm play: fits CAD (64,25) and measured (65.1,25.35) inserts',
                   attr='exclude_from_pos_files exclude_from_bom')


def padsn(name, labels, p=3.0, pad=2.2, drill=1.0, descr='Solder pads'):
    b = ''
    for i, lab in enumerate(labels):
        shape = 'roundrect (roundrect_rratio 0.2)' if i == 0 else 'circle'
        b += f'\t(pad "{i + 1}" thru_hole {shape} (at {i * p} 0) (size {pad} {pad}) (drill {drill}) (layers "*.Cu" "*.Mask"))\n'
        b += f'\t(fp_text user "{lab}" (at {i * p} {pad / 2 + 1.0:.2f} 0) (layer "F.SilkS") (effects (font (size 0.6 0.6) (thickness 0.12))))\n'
    b += f'\t(fp_rect (start {-pad/2 - .3:.2f} {-pad/2 - .3:.2f}) (end {(len(labels) - 1) * p + pad/2 + .3:.2f} {pad/2 + 1.7:.2f}) (stroke (width 0.05) (type solid)) (fill no) (layer "F.CrtYd"))\n'
    return fp_text(name, b, descr)


def pads2(name, l1, l2, p=5.0, pad=3.2, drill=1.5, descr='Two solder pads'):
    b = f'\t(pad "1" thru_hole circle (at 0 0) (size {pad} {pad}) (drill {drill}) (layers "*.Cu" "*.Mask"))\n'
    b += f'\t(pad "2" thru_hole roundrect (roundrect_rratio 0.2) (at {p} 0) (size {pad} {pad}) (drill {drill}) (layers "*.Cu" "*.Mask"))\n'
    b += f'\t(fp_text user "{l1}" (at 0 {pad/2 + 1.1:.2f} 0) (layer "F.SilkS") (effects (font (size 0.8 0.8) (thickness 0.16))))\n'
    b += f'\t(fp_text user "{l2}" (at {p} {pad/2 + 1.1:.2f} 0) (layer "F.SilkS") (effects (font (size 0.8 0.8) (thickness 0.16))))\n'
    b += f'\t(fp_rect (start {-pad/2 - .3:.2f} {-pad/2 - .3:.2f}) (end {p + pad/2 + .3:.2f} {pad/2 + 1.9:.2f}) (stroke (width 0.05) (type solid)) (fill no) (layer "F.CrtYd"))\n'
    return fp_text(name, b, descr)


def mount_hole_m25():
    b = '\t(pad "" np_thru_hole circle (at 0 0) (size 2.75 2.75) (drill 2.75) (layers "*.Cu" "*.Mask"))\n'
    b += '\t(fp_circle (center 0 0) (end 3.0 0) (stroke (width 0.05) (type solid)) (fill no) (layer "F.CrtYd"))\n'
    return fp_text('MountingHole_2.75mm_M2.5_Pi', b, 'M2.5 hole on the Raspberry Pi 4 mounting pattern (58 x 49)', attr='exclude_from_pos_files exclude_from_bom')


def hole(d):
    b = f'\t(pad "" np_thru_hole circle (at 0 0) (size {d} {d}) (drill {d}) (layers "*.Cu" "*.Mask"))\n'
    b += f'\t(fp_circle (center 0 0) (end {d / 2 + 0.25:.2f} 0) (stroke (width 0.05) (type solid)) (fill no) (layer "F.CrtYd"))\n'
    return fp_text(f'Hole_{d:.1f}mm', b, f'{d} mm floor hole (countersunk from below for M3 where d = 3.2)', attr='exclude_from_pos_files exclude_from_bom')


def build_fp_lib():
    d = os.path.join(PRJ, LIB + '.pretty'); os.makedirs(d, exist_ok=True)
    for f in os.listdir(d):
        os.remove(os.path.join(d, f))
    custom = {'SolderWire_2pad_P7mm_D2.2mm_BAT': pads2('SolderWire_2pad_P7mm_D2.2mm_BAT', 'BAT-', 'BAT+', 7.0, 4.6, 2.2, 'Battery leads 3S LiPo (14-16 AWG)'),
              'SolderWire_2pad_P5mm_M': pads2('SolderWire_2pad_P5mm_M', 'A', 'B', 5.0, 3.2, 1.5, 'Motor leads (20-22 AWG)'),
              'SolderWire_2pad_P4mm_S': pads2('SolderWire_2pad_P4mm_S', '-', '+', 4.0, 2.4, 1.0, 'Small solder pads (solar panel / lights)'),
              'SolderWire_2pad_P5mm_SW': pads2('SolderWire_2pad_P5mm_SW', 'SW', 'SW', 5.0, 3.2, 1.5, 'Power switch leads'),
              'SolderWire_2pad_P5mm_5V': pads2('SolderWire_2pad_P5mm_5V', 'GND', '5V PI', 5.0, 3.2, 1.5, '5 V 3 A to the Pi 4'),
              'Pads_ELRS_RX': padsn('Pads_ELRS_RX', ['GND', '5V', 'TX', 'RX'], descr='ExpressLRS receiver (RadioMaster RP2): GND 5V TX RX (CRSF)'),
              'Pads_PI_UART': padsn('Pads_PI_UART', ['GND', 'TXD', 'RXD'], descr='UART to the Raspberry Pi 4: GND, Pi TXD (pin 8), Pi RXD (pin 10)'),
              'Pads_RX_USB': padsn('Pads_RX_USB', ['D-', 'D+', 'GND'], p=2.54, pad=1.6, drill=0.8,
                                   descr='USB test pads of the ELRS receiver C3 (first flash with a cut USB cable)'),
              'MountingHole_2.75mm_M2.5_Pi': mount_hole_m25()}
    # LCSC/EasyEDA footprints (easyeda2kicad, docs/elrs): ELRS module + C3 module + RGB LED, 3D models kept in the project
    ez = os.path.join(PRJ, 'docs', 'elrs', 'e28lib.pretty')
    for f in os.listdir(ez):
        t = open(os.path.join(ez, f)).read().replace('(model "e28lib.3dshapes/', '(model "${KIPRJMOD}/docs/elrs/e28lib.3dshapes/')
        custom[f[:-len('.kicad_mod')]] = t
    for d_ in design.HOLE_SIZES:
        custom[f'Hole_{d_:.1f}mm'] = hole(d_)
    for n, t in custom.items():
        open(os.path.join(d, n + '.kicad_mod'), 'w').write(t)
    for p in design.parts:
        lib, n = p['fp'].split(':')
        if lib == LIB:
            continue
        shutil.copy(os.path.join(FPDIR, lib + '.pretty', n + '.kicad_mod'), os.path.join(d, n + '.kicad_mod'))
    # ESP32-S3 module: KiCad's antenna keep-out is 48 x 21 mm beyond the module; on the floor board that would cut through
    # the right pod. Keep only the antenna width (21 mm) and 9 mm in front of it.
    esp = os.path.join(d, 'ESP32-S3-WROOM-1.kicad_mod')
    if os.path.exists(esp):
        t = open(esp).read()
        t = t.replace('(xy -24 -6.75) (xy 24 -6.75) (xy 24 -27.75) (xy -24 -27.75)', '(xy -10.5 -6.75) (xy 10.5 -6.75) (xy 10.5 -16) (xy -10.5 -16)')
        for o, n in (('(start -24 -27.75)', '(start -10.5 -16)'), ('(end -24 -6.75)', '(end -10.5 -6.75)'), ('(start -24 -6.75)', '(start -10.5 -6.75)'),
                     ('(end 24 -6.75)', '(end 10.5 -6.75)'), ('(start 24 -27.75)', '(start 10.5 -16)'), ('(end -24 -27.75)', '(end -10.5 -16)'),
                     ('(start 24 -6.75)', '(start 10.5 -6.75)'), ('(end 24 -27.75)', '(end 10.5 -16)')):
            t = t.replace(o, n)
        open(esp, 'w').write(t)
    return d


# ---------------------------------------------------------------- symbols
def rename_sym(s, new):
    old = s[1]; s[1] = new
    for sub in find(s, 'symbol'):
        sub[1] = new + sub[1][len(old):]
    return s


def prop(name, val, at=(0, 0), hide=False, size=1.27):
    e = [Sym('effects'), [Sym('font'), [Sym('size'), size, size]]]
    if hide:
        e.append([Sym('hide'), Sym('yes')])
    return [Sym('property'), name, val, [Sym('at'), at[0], at[1], 0], e]


def pin(ptype, x, y, ang, num, name, length=5.08):
    f = [Sym('effects'), [Sym('font'), [Sym('size'), 1.27, 1.27]]]
    return [Sym('pin'), Sym(ptype), Sym('line'), [Sym('at'), x, y, ang], [Sym('length'), length],
            [Sym('name'), name, f], [Sym('number'), str(num), f]]


def cm5_symbol():
    names = {int(k): v for k, v in json.load(open(os.path.join(HERE, 'cm5_pins.json'))).items()}

    def ptype(n):
        if n in ('GND', '5V', 'GPIO_VREF'):
            return 'power_in'
        if n in ('CM5_3.3V', 'CM5_1.8V'):
            return 'power_out'
        return 'bidirectional'
    s = [Sym('symbol'), 'CM5', [Sym('pin_names'), [Sym('offset'), 1.016]],
         [Sym('exclude_from_sim'), Sym('no')], [Sym('in_bom'), Sym('yes')], [Sym('on_board'), Sym('yes')],
         prop('Reference', 'M', (0, 5.08)), prop('Value', 'CM5', (0, -132.08)),
         prop('Footprint', 'sc02:Raspberry-Pi-5-Compute-Module', hide=True),
         prop('Datasheet', 'https://datasheets.raspberrypi.com/cm5/cm5-datasheet.pdf', hide=True),
         prop('Description', 'Raspberry Pi Compute Module 5 (2x 100-pin DF40)', hide=True)]
    for unit in (1, 2):
        sub = [Sym('symbol'), f'CM5_{unit}_1',
               [Sym('rectangle'), [Sym('start'), -25.4, 2.54], [Sym('end'), 25.4, -127.0],
                [Sym('stroke'), [Sym('width'), 0.254], [Sym('type'), Sym('default')]],
                [Sym('fill'), [Sym('type'), Sym('background')]]],
               [Sym('text'), f'J{unit} pins {(unit-1)*100+1}-{unit*100}', [Sym('at'), 0, 0, 0],
                [Sym('effects'), [Sym('font'), [Sym('size'), 1.27, 1.27]]]]]
        seen = set()
        for i in range(50):
            for side, n in ((0, (unit - 1) * 100 + 2 * i + 1), (1, (unit - 1) * 100 + 2 * i + 2)):
                nm = names[n]; t = ptype(nm)
                if nm in seen and t.startswith('power'):
                    t = 'passive'
                seen.add(nm)
                y = -2.54 * i - 2.54
                sub.append(pin(t, -30.48 if side == 0 else 30.48, y, 0 if side == 0 else 180, n, nm))
        s.append(sub)
    s.append([Sym('embedded_fonts'), Sym('no')])
    return s


EASYEDA_SYMS = {'sc02:ESP32-C3-MINI-1': 'ESP32-C3-MINI-1-N4', 'sc02:E28-2G4M12S': 'E28-2G4M12S',
                'sc02:SK6812MINI-E': 'SK6812MINI-E_C5149201'}


def build_sym_lib():
    out = {}
    for p in design.parts:
        sid = p['sym']; n = sym_name(sid)
        if n in out:
            continue
        if sid == 'sc02:CM5':
            out[n] = cm5_symbol()
        elif sid in EASYEDA_SYMS:                  # LCSC/EasyEDA symbols: all pins 'passive' (they come in as 'unspecified')
            s = rename_sym(symlib.get('e28lib:' + EASYEDA_SYMS[sid], os.path.join(PRJ, 'docs', 'elrs', 'e28lib.kicad_sym')), n)
            for sub in find(s, 'symbol'):
                for pn in find(sub, 'pin'):
                    if pn[1] == Sym('unspecified') or str(pn[1]) == 'unspecified':
                        pn[1] = Sym('passive')
            for e in s:
                if isinstance(e, list) and e[0] == 'property' and e[1] == 'Reference':
                    e[2] = {'sc02:SK6812MINI-E': 'D'}.get(sid, 'U')
            out[n] = s
        elif sid == 'sc02:Q_PMOS_GDS':
            s = rename_sym(symlib.get('Device:Q_PMOS'), 'Q_PMOS_GDS')
            m = {'G': '1', 'D': '2', 'S': '3'}
            for sub in find(s, 'symbol'):
                for pn in find(sub, 'pin'):
                    num = find1(pn, 'number'); num[1] = m[num[1]]
            out[n] = s
        else:
            out[n] = symlib.get(sid)
        # point the footprint field to our own lib
        fpid = LIB + ':' + fp_name(p['fp'])
        for e in out[n]:
            if isinstance(e, list) and e[0] == 'property' and e[1] == 'Footprint':
                e[2] = fpid if sid != 'Device:R' and sid != 'Device:C' else ''
    lib = [Sym('kicad_symbol_lib'), [Sym('version'), 20241209], [Sym('generator'), 'arachne_gen'],
           [Sym('generator_version'), '1.0']] + list(out.values())
    open(os.path.join(PRJ, LIB + '.kicad_sym'), 'w').write(dump(lib) + '\n')
    return out


def lib_tables():
    open(os.path.join(PRJ, 'sym-lib-table'), 'w').write(
        '(sym_lib_table\n\t(version 7)\n\t(lib (name "sc02")(type "KiCad")(uri "${KIPRJMOD}/sc02.kicad_sym")(options "")(descr "SC-02 drive board"))\n)\n')
    open(os.path.join(PRJ, 'fp-lib-table'), 'w').write(
        '(fp_lib_table\n\t(version 7)\n\t(lib (name "sc02")(type "KiCad")(uri "${KIPRJMOD}/sc02.pretty")(options "")(descr "SC-02 drive board"))\n)\n')


if __name__ == '__main__':
    build_fp_lib(); syms = build_sym_lib(); lib_tables()
    print('footprints + %d symbols written' % len(syms))
    sys.stdout.flush(); os._exit(0)   # KiCad's SWIG objects can crash Python at shutdown
