KVR-CIBER/sc02-solar-hypercar/(commit log)

2026-10-16 SC-02 Solar Hypercar: CAD, firmware, Pi software, web sim, print files, website
    [1_body_main_ASA.3mf, 1_body_main_ASA.step, 1_car_ASA.3mf, 1x_battery_tray.stl, 1x_bearing_cap_L.stl, 1x_bearing_cap_R.stl, 1x_body_main.stl, 1x_body_nose.stl]
2026-10-16 Sim: stabiel rijden + oneindige rechte lijn
    - Wielas impliciet geïntegreerd: geen wielslip-trillen meer bij optrekken en kruipen
    - Sliphoeken in het wielassenstelsel: achteruit + sturen werd chaotisch (tekenfout)
    - Smallere voorbanden (muF 0.9, BF 6): stabiel onderstuur i.p.v. tollen (max zijslip 8°)
    - Remmen = slipregeling in de firmware (ABS-achtig), zachter bij sturen; 2,4x kortere remweg
    - Rem gaat altijd voor gas (W + spatie versnelde verder)
    - Demo-autopiloot alleen tot de eerste input, neemt nooit meer over na 9 s
    - Nieuwe baan: oneindige rechte lijn (periodiek, wereld schuift mee), afstand + 12 m-sprinttimer
    - Gewicht 715 g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
2026-10-16 Sim: knop voor besturingsvertraging (direct / BT 35 ms / gsm 120 ms)
    Inputs gaan als pakketjes met vertraging + jitter naar de wagen en landen
    binnen de 1 ms-fysicastappen. Simuleert controller -> Pi 4 -> UART -> ESP32
    of gsm via hotspot. Waarden zijn schattingen.
2026-10-18 SC-02 drive board: Pi 4 HAT-style PCB (ESP32-S3, 2x DRV8871, INA226, 5 V 5 A buck), DRC/ERC clean, JLC fab files
    [sc02_drive-B_Cu.gbr, sc02_drive-B_Mask.gbr, sc02_drive-B_Paste.gbr, sc02_drive-B_Silkscreen.gbr, sc02_drive-Edge_Cuts.gbr, sc02_drive-F_Cu.gbr, sc02_drive-F_Mask.gbr, sc02_drive-F_Paste.gbr]
2026-10-18 SC-02 floor board v2: the whole floor is the PCB (XT60, fuse, ELRS RP2 pads, Pi UART, USB-C at the edge); body gets a USB-C opening
    [1_body_main_ASA.step, 2_body_nose_ASA.step, 3_canopy_smoke_PETG.step, 4_chassis_parts_ASA.step, 5_aero_black_ASA.step, 6_wheels_PLA.step, 7a_tyre_mold_bottom_cores_PLA.step, 7b_tyre_mold_top_PLA.step]
2026-10-18 SC-02 drive board v3: compact board on standoffs, no Pi, built-in ExpressLRS receiver (ESP32-C3 + E28 SX1280, Generic C3 2400), JST-XH solar connector
    [sc02_drive-B_Cu.gbr, sc02_drive-B_Mask.gbr, sc02_drive-B_Paste.gbr, sc02_drive-B_Silkscreen.gbr, sc02_drive-Edge_Cuts.gbr, sc02_drive-F_Cu.gbr, sc02_drive-F_Mask.gbr, sc02_drive-F_Paste.gbr]
2026-10-19 Drive board v3: KiCad project file
2026-10-19 Sim: RadioMaster Pocket as USB joystick (learnable mapping), boost with motor-temperature + battery lockout, live synthesized sound; Pocket boot logo (SC-02 splash patch)
2026-10-19 Sim: boost = switch SA on channel 5 by default
2026-10-19 Sim: left gas stick (back = brake to a stop), reverse only with a learnable switch (default SB/CH6)
2026-10-19 Sim: switches only count when fully on (3-position middle = off)
2026-10-19 Sim: Pocket SA momentary = HID button 0 counts as boost; live boost/reverse state in the controller panel
2026-10-19 Sim: learn steering on the right stick
2026-10-19 Sim: max boost = full battery voltage, DRV8871 current limit (3.55 A) + driver thermal model, 38k rpm guard
2026-10-19 Sim: DRV8874 drivers (0.2 ohm, 6 A) + heatsink instead of DRV8871
2026-10-19 Sim: temperature reset button (T)
2026-10-19 Sim: brushless 2435 4500KV + 40 A ESC (11:35) as default drivetrain (boost ~124 km/h), old 2x130 selectable
2026-10-19 Drive board v3: brushless ESC output (IO4) + ESC/motor NTC (IO5) instead of 2x DRV8871
    [sc02_drive-B_Cu.gbr, sc02_drive-B_Mask.gbr, sc02_drive-B_Paste.gbr, sc02_drive-B_Silkscreen.gbr, sc02_drive-Edge_Cuts.gbr, sc02_drive-F_Cu.gbr, sc02_drive-F_Mask.gbr, sc02_drive-F_Paste.gbr]
2026-10-19 Speed limit on the Pocket scroll wheel (P1 -> CH7): Lua screen + spoken limit on the radio, governor + speech in the sim
2026-10-19 Sim: learn step for the speed-limit wheel (Bluetooth joystick has another channel order)
2026-10-20 SC-02 CAD: one 2435 brushless (11T/35T m0.8) on a motor plate + strap, ESC beside the motor, drive PCB v3 on 4 mm posts, 2S LiPo tray above the PCB, acrylic floor; interference pairs 0. PCB: J4 servo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
    [battery_tray.stl, body_main.stl, cnc_pinion_m0.8_11T.dxf, cnc_spur_m0.8_35T.dxf, esc_tray.stl, floor_2mm_acrylic.dxf, motor_clamp.stl, pcb_posts.stl]
2026-10-20 4K assembly film of the new SC-02 (Blender on lvdell)
2026-10-20 New SC-02 assembly film: 4K + 1080p (2435 brushless, PCB v3, LiPo above) + stills
2026-10-21 Pro renders of the SC-02: showroom studio, car paint/carbon/rubber, beauty stills, x-ray, exploded view, steering film, 360 turntable
2026-10-21 SC-02 explainer film: camera flies part to part with labels (motor, gears, ESC, PCB, ELRS, LiPo, servo, panel, wing)
2026-10-21 Renders: real KiCad drive PCB (matte black) + real 2S LiPo with label, leads, XT60 and balance plug; name Kobe Vanrobaeys
    [sc02_drive-B_Cu.gbr, sc02_drive-B_Mask.gbr, sc02_drive-B_Paste.gbr, sc02_drive-B_Silkscreen.gbr, sc02_drive-Edge_Cuts.gbr, sc02_drive-F_Cu.gbr, sc02_drive-F_Mask.gbr, sc02_drive-F_Paste.gbr]
2026-10-21 Exploded view: lift the car so downward parts stay above the floor, wider camera
2026-10-21 SC-02 beauty renders (4K, showroom): front/rear 3/4, side, nose, top, wing, wheel, panel, x-ray
2026-10-21 SC-02 steering film (servo, uprights, tie rods; 4K + 1080p)
2026-10-21 Steering film v2: tie rods follow horn + uprights, camera low front to high 3/4, own title + live steering-angle gauge
2026-10-21 Floor: clean laser DXF (cut lines only: LINE/ARC/CIRCLE on layer CUT, mm)
    [floor_2mm_acrylic_snijlijnen.dxf]
2026-10-21 Renders: one at a time (VRAM), 40 samples + OptiX denoise, resume skips finished frames
2026-10-21 Steering film v2 (tie rods follow, angle gauge, new camera)
2026-10-21 Floor v2: no holes near the edge (min 2.4 mm acrylic): diffuser screws on ears 4.5 mm in, rear clip screw 5 mm in (magnet unchanged), bearing blocks 1 mm wider inward
    Claude-Session: https://claude.ai/code/session_011i77QLySBcGV5zMtjYjqQb
    [bearing_cap_L.stl, bearing_cap_R.stl, clip_2L.stl, clip_2R.stl, diffuser.stl, floor_2mm_acrylic.dxf, floor_2mm_acrylic_snijlijnen.dxf, rear_bearing_L.stl]
2026-10-22 Steering film v3: stub axle + hub from upright to the front wheel, wheel pivots from the real tyre centre
2026-10-22 Explainer v2: camera arcs over the car between shots, front stub axles in every mode
2026-10-22 Steering film v3 (stub axles) + pro assembly film (4K + 1080p)
2026-10-22 Driving film: figure-eight through the showroom, wheels/steering/spur/pinion turning, x-ray half, speed + rpm gauges
2026-10-22 Renders: real LiPo (soft pouch, shrink wrap, wrap-around label, lead exit, XT60 with contacts, JST-XH balance plug)
